bradleyeckert/thriller/README.md

# FPGA security stack with ROT

Root of trust for an FPGA-based device platform, built from three parts: an FPGA with an encrypted and authenticated bitstream,
one QSPI NOR flash, and a TPM 2.0 (ST33KTPM2X). The FPGA is a model of the ASIC that replaces it
at volume (`doc/ics55.md`), so everything the FPGA does is generic RTL and firmware, and everything that depends on the FPGA family lives in `fpga/<family>/`.

- **The FPGA is the root of trust and the application.** Its configuration engine authenticates and decrypts the bitstream with the device's own eFuse key;
  the bitstream holds a boot ROM, a loader core that owns every key path and security decision and is, with its hardware, the FIPS 140-3 cryptographic module; a supervisor core that
  runs the manufacturer's transports, scheduling and CLI outside the module, so that those change without a CMVP filing; and an application core that runs the LiteForth application and can reach
  nothing secret. All three execute in place from the flash through a decrypting, authenticating cache (`doc/xip.md`).
- **The TPM holds what must survive the bitstream:** the device's keys, its identity, and the two monotonic counters that stop rollback.
  It releases a key only to a bitstream that holds the current pairing key, and the data key only after the host has proved itself to the TPM directly (`doc/tpm.md`).
  It is a FIPS 140-3 validated module in its own right, which is what lets the device's own module boundary stop at the loader domain (`doc/fips.md`).
- **The flash is untrusted storage** for the bitstream, the loader, the supervisor and the application, every line of code authenticated as it is fetched (`doc/flash.md`).
- **The module is frozen.** Every change to the bitstream or the loader is a filing with the CMVP, so the loader is a crypto kernel with a fixed service API and all product logic lives in the supervisor and application images (`doc/fips.md`, Designing for few filings).

The platform will encrypt files, so the TPM is provisioned accordingly.
To support DSP applications, audio CODECs are planned for.

## Documents

| Document | Contents |
|---|---|
| This README | Overview: chipset, keys, boot, updates, recordings, sensor, host sessions, the network and the CLI |
| `doc/arch.md` | Trust boundary, threat model, risk assessment, algorithm bill of materials |
| `doc/hw.md` | Hardware modules: the three cores, the mailboxes, the shared XIP engine, key paths, boot and lockdown, the key-source interface |
| `doc/api.md` | The module's service API: mailbox messages, session messages the module consumes, events, status block, parameters carried as data |
| `doc/tpm.md` | TPM: NV indices, sealed objects and PCRs, sessions over SPI, host authentication, the pairing-key ratchet, counters, attestation, provisioning |
| `doc/flash.md` | Flash map: bitstream slots and multi-boot, loader, supervisor and application slots, boot record, install order, staging |
| `doc/fpga.md` | The FPGA, family-neutral: configuration from flash, per-device bitstreams, fallback, TRNG, resources |
| `fpga/` | Everything family-specific, one folder per FPGA family, and the wish list a family must meet |
| `doc/xip.md` | Execute in place: per-line Ascon-AEAD128 for the loader, the supervisor and the application |
| `doc/acquisition.md` | CODECs, data path, recording encryption, LCD, speaker and alarms |
| `doc/sensor.md` | Replaceable temperature sensor: certificates, offline pairing, authenticated sessions, fail-safe behavior |
| `doc/enrollment.md` | Device and sensor enrollment, TPM provisioning, the bitstream build service, detecting unknown identities, updates |
| `doc/roles.md` | Manufacturer, application owner, developer and user; device-bound developer builds |
| `doc/test.md` | Test plan and fault-injection campaigns |
| `doc/fda.md` | FDA security architecture views |
| `doc/network.md` | Network security posture: why the device cannot be a network attack vector, for IT departments and the FDA |
| `doc/fips.md` | FIPS 140-3 as the long-term target: designing for few filings, module boundary, approved algorithms, DRBG, self-tests, roles, zeroization, and what it changes now |
| `doc/ics55.md` | ASIC migration to the ICS55 55 nm process: the PUF behind the key-source interface |
| `doc/questions.md` | Every open question in one matrix, and the decisions taken |

## Chipset

- **FPGA with an encrypted and authenticated bitstream.** Current choice: **Pango Logos2 PG2L50H-6IFBG484** (50K-class), which authenticates bitstreams before decrypting them
  (`fpga/logos2/`). No family offers a hardened cipher usable from the fabric, so all symmetric cryptography runs in a masked Ascon core of our own (`doc/hw.md`). It configures itself from the flash at power-up in master SPI mode, with the vendor's multi-boot fallback to a second bitstream. Fallback: **Efinix Titanium Ti60** (`fpga/ti60/`), which meets the same hard requirements with RSA-4096 authentication
  and a scripted BRAM content updater. Candidates: Microchip PolarFire, Lattice CrossLink-NX. The ECP5 and Gowin GW5A were evaluated and dropped for lacking bitstream authentication. The requirements a family must meet are in `fpga/README.md`.
- **QSPI NOR flash**, 32 MB proposed: bitstream slots, loader, supervisor and application images (A/B each), the boot record and a recovery staging area (`doc/flash.md`). Nothing in it is trusted.
- **ST33KTPM2X32DKG9** TPM 2.0 (STMicroelectronics), on an SPI bus that never leaves the sealed enclosure, powered with the FPGA. Chosen over the ATECC608C when FIPS 140-3 became the target:
  it is on CMVP certificate #5570 (FIPS 140-3, physical security Level 3), ships with ST-certified endorsement keys, and sits inside the device's own module boundary as an embedded validated
  module, so its services need no testing of ours (`doc/fips.md`). Keys are sealed objects released only under a policy that names the pairing key; counters are its NV counters, authenticated and
  authorized; its indices cannot be deleted by anyone but the enrollment station (`doc/tpm.md`).
  Provisioned blank at enrollment. A high-volume part, in stock at Mouser in quantity; not at LCSC, so a consigned part for JLCPCB builds (E8).
- **2 × NAU88C22** stereo CODECs: four acquisition channels, and the speaker driver (`doc/acquisition.md`).
- **LCD panel and speaker** inside the enclosure, which carries a tamper-evident seal.
- **MicroSD card socket**, driven by the FPGA: encrypted recordings and user data, the event log, offline update packages.
- **ESP-PSRAM64H** (8 MB QSPI PSRAM): a ring buffer for the encrypted recording stream between the recording engine and the card or the network, riding out card write latency and network stalls.
  It holds ciphertext only, about ten seconds of it at the full rate, and is outside the trust boundary like the card (`doc/acquisition.md`, Stream buffer).
- **Sensor connector**: a wired, two-way link to a replaceable temperature sensor; the supervisor moves the bytes, the module checks every frame (`doc/sensor.md`).
- **UART** (USB-UART bridge): status reports, and the wired path for host sessions, updates and the CLI.
- **Ethernet**, 10/100 over RMII to a PHY such as the LAN8742A: the path to the server for attestation, updates, uploads and sensor-pairing confirmation. The FPGA speaks only UDP on one port,
  implemented in hardware; there is no network stack anywhere in the device (see Network). An untrusted edge proxy on site relays the datagrams to the server over TLS where IT requires port 443.
- **YXC YSN8130E real-time clock** (3225 module with built-in crystal, 0.9 µA, open-drain /INT that survives a VDD cycle), backed by two SR44 cells; A10 for the remaining checks. Its time is untrusted and never stands in for the server's time beacons (`doc/acquisition.md`); its job is
  scheduling and local display, and **its alarm output wakes the device from deep sleep** (the regulators' enables on the FPGA board, RST_N on the ASIC), so every scheduled wake is a cold start through the
  entire trust chain; the alarm is also an input pin, so the supervisor sees it as an interrupt when awake. It also automates NIST SP 800-90B restart testing of the TRNG: a thousand wakes, each logging its first raw samples (`doc/hw.md`, Real-time clock).
- Oscillator, voltage regulators, and test connectors not populated in production. The FPGA's JTAG is permanently disabled at enrollment where the family allows it.

## Keys and what unlocks them

| Key | Held in | Per device | Unlocked by | Protects |
|---|---|---|---|---|
| Bitstream configuration key | FPGA eFuse; HSM | Yes | The FPGA alone | The bitstream at rest in flash and on the configuration bus |
| Bitstream signing key | Manufacturer HSM; public key data in FPGA eFuse | No | — | Only manufacturer bitstreams configure the FPGA (where the family authenticates) |
| **Pairing key** | The bitstream (key source) and the TPM's pairing index, as its authorization value | Yes, and per bitstream release | The bitstream itself | Every TPM session: the session key, every HMAC, every policy. Rotated with each bitstream release, which is what kills old bitstreams (`doc/tpm.md`, Ratchet) |
| Application key | TPM, sealed | Yes | Pairing key | Headers and per-line keys of the loader, supervisor and application images in flash; the boot record |
| **Data key** | TPM, sealed, one per host | Yes | Pairing key **and** the host's proof to the TPM (a relayed HMAC session) | User data on the MicroSD card |
| Host authorization key | TPM (an NV index's authorization value, never readable) and the host | Yes, per host | Never leaves either | Proving the host is present; the host session secret sealed with the data key derives the session key |
| Device identity key (symmetric) | TPM (keyed-hash object, never readable); HSM | Yes | Pairing key; used in place | Authenticating the device to the enrollment server, quantum-safe |
| Attestation key (ECDSA P-256) | TPM (never readable); certificate chained to the manufacturer CA, bound to ST's endorsement key certificate | Yes | Pairing key | Quotes over the PCRs for hosts and third parties |
| Distribution key | TPM, sealed | No | Pairing key | Production application packages in transit; a device never enrolled cannot install them |
| Developer key | TPM, sealed | Yes | Pairing key, into hardware only | Developer builds for that one device (`doc/roles.md`) |
| Log key | TPM, sealed | Yes | Pairing key | The security event log's MAC chain |
| Release LMS keys (platform; application), main and backup | HSMs; platform public key in the boot ROM, application keys in write-locked TPM NV | No | — | Every update package, checked before anything is decrypted or installed |
| Host data secret | Host only; from a separate HSM master | Yes | — | Unlocks user data together with the device's data key |
| Host recording key pair (ML-KEM-768) | Private key on the host; public key in flash, under the application key | Per host | — | Recordings: the device can encrypt them but not decrypt them |
| Segment key | Loader domain and the recording engine, for one segment, then erased | Per segment | — | One segment of a recording |
| Sensor pairing key | Flash (under the application key) and the sensor | Per pairing | — | Sessions with one paired sensor |

The HSM derives every per-device key from a master key and the TPM's identifier (`doc/enrollment.md`). No stored key ever reaches software on any core: keys move from the
TPM or the key source into hardware key registers (`doc/hw.md`, Key paths). The one computed secret that does pass through loader software is the ML-KEM shared secret, which the
encapsulation code produces and hands to the derive path (H10).

## Boot

1. The FPGA's configuration engine loads the active bitstream from flash, checks its signature and decrypts it with the device's eFuse key; anything else is refused. On failure it falls back to the other
   bitstream slot (the family's multi-boot).
2. The **boot ROM** (block RAM in the bitstream) starts on the loader core with the other two cores in reset. It starts the TPM, opens a session under the pairing key, reads counter 0,
   has the TPM unseal the application key, checks the loader image's header and version, derives the loader's image key into the XIP engine, and jumps to the loader in flash.
   If the TPM refuses the pairing key, this bitstream has been superseded: the boot ROM stops in recovery.
3. The **loader** reads counters 1 and 2, checks the supervisor image's header and version, then the application's (or, for a developer build, device and epoch), derives their image keys,
   applies the network policy to the PHY's reset, and releases the supervisor core, then the application core. Every cache line of every image is authenticated as it is fetched.
4. The **supervisor** brings up the card, the clock, the schedule and, if the policy allows, the network address, and has the module open the sensor session.
5. The application runs. It reaches user data, recordings, the host, the sensor and the log only through the module's services; the supervisor moves the bytes.

Any check that fails falls back to the other slot of that image, or stops in the safe state with a record in the boot record (`doc/hw.md`, Boot and lockdown).

## Updates

Two signed chains, sharing nothing but the TPM:

| Package | Contents | Scope | Signed by | Counter |
|---|---|---|---|---|
| Platform | This device's encrypted bitstream with its next pairing key, and a loader image | Per device, built by the bitstream build service | LMS (manufacturer), one signature per release over a manifest | 0 |
| Supervisor | The manufacturer's supervisor image: transports, scheduling, CLI | Fleet | LMS (manufacturer) | 2 |
| Application | The LiteForth application, and its network policy | Fleet; encrypted under the distribution key | LMS (application owner); developer builds: a MAC under the device's developer key | 1 |

Packages arrive on the MicroSD card, over the UART from the host, or over the network, and the supervisor streams them to the module. The module checks the signature and the version before decrypting anything, writes into the
inactive slot, reads it back, advances the counter and switches the boot record (`doc/flash.md`, Install order). A bitstream update ends with the new bitstream, once it has booted,
replacing the pairing key in the TPM with its next key, after which the old bitstream can no longer open the TPM. Platform packages are the rare ones: each is a change to the FIPS module and a CMVP filing; supervisor and application packages are not (`doc/fips.md`).

## Recordings

The loader draws a fresh key for each segment, encapsulates it with ML-KEM to the host's public key, and loads it into the recording engine, which encrypts the stream in the FPGA's
masked Ascon core and writes ciphertext to the card. The segment key is then erased, so the device cannot read its own past recordings, and neither can a thief (`doc/acquisition.md`).

## Sensor

The temperature sensor is replaceable and pairs offline with an ML-DSA certificate and ML-KEM. Every frame carries a MAC, readings older than the maximum age are rejected,
and the server later confirms each pairing and catches clones (`doc/sensor.md`).

## Host sessions and user data

The host proves itself to the TPM, not to the loader: the loader relays one TPM command's HMAC, which the host computes under its own key, and the TPM unseals the data key only when it
verifies; the host session secret unsealed alongside derives the session key, so that every frame is encrypted and authenticated. User data other than recordings is encrypted under a key derived from both the device's data key and a secret the host sends in each
session, which the device never stores. A lost host is re-issued from the HSM. A compromised host means retiring the device (`doc/arch.md`, R20).

## Attestation and identity

The device proves what it is and what it runs in two ways (`doc/tpm.md`, Attestation):

- to the enrollment server, with a MAC under its symmetric identity key over the server's nonce and a report of its versions and counters: quantum-safe, and the HSM can derive the key;
- to a host or a third party, with a TPM quote: an ECDSA P-256 signature over PCRs the loader extended with the same report, under a per-device attestation key certificate chained to the manufacturer's CA and to ST's endorsement key certificate.

The TPM signs only for a bitstream that holds the current pairing key, so a report proves the pairing, the bitstream release, and the versions the loader measured.

## Network and the CLI

There are no radios. The device has one wired Ethernet port, and the FPGA implements the whole of its network side in hardware (`doc/hw.md`, Ethernet transport): an RMII MAC, an ARP
responder for its own address, IPv4 without fragments or options, ICMP echo, and a UDP demultiplexer that delivers datagrams on one port to the supervisor core and drops everything else.
The payload is the same authenticated, encrypted session frame the module already checks from the UART, so the network is a second transport for one protocol, with no TCP, DNS, TLS or HTTP
anywhere in the device. Flows are outbound only, with keepalives; the ack-and-window layer that makes updates and uploads reliable over a lossy path is part of the session protocol.

Where a site's IT policy only allows TCP on port 443, a small **edge proxy** (software on a PC or a gateway appliance on the same LAN) relays the device's datagrams to the server over TLS.
It is outside the trust boundary and sees only ciphertext: it can drop, delay or replay, and every one of those is already handled by the session protocol.

**The application owner decides** whether the port is enabled, through a network policy in the signed application package; the module holds the PHY in reset when it is disabled, and the supervisor cannot override it.
Addressing is by DHCP, with static addresses settable in a host session; the server (or proxy) address is set the same way.

- **The UART** gives read-only status to anyone with a cable, and authenticated sessions.
- **The network** carries authenticated sessions with the server, and with a host on the same LAN.

| Session | Commands |
|---|---|
| None (UART status only) | Versions, build mode, faults, pairing state |
| Host (host authorization key) | User data, recordings, sensor pairing, updates, log export, network settings, attestation |
| Developer (developer key, developer builds only) | The above, plus the application's debug commands |

The PHY choice, PoE and the edge proxy are open items (`doc/questions.md`, A6 to A9).

## ASIC conversion

The ASIC keeps the boot ROM (now mask ROM), the loader, the supervisor and application chains, the TPM and the flash, and loses the bitstream. The one thing the bitstream carried,
the pairing key, comes instead from a PUF behind the same key-source interface the FPGA build already uses, with the hardware to characterize it on silicon (`doc/ics55.md`).
