bradleyeckert/thriller/fpga/logos2/README.md

# Pango Logos2 (PG2L50H)

**Part under consideration:** PG2L50H-6IFBG484 (50K-class logic, speed grade 6, industrial temperature, 484-ball BGA).
**Status:** current choice, with the Efinix Ti60 as fallback (`fpga/ti60/`). Its bitstream security meets the hard requirements of the wish list. Its "DPA protection" turned out to mean authentication before decryption of the bitstream, not a hardened cipher the fabric can use,
so the design's symmetric cryptography runs in a masked Ascon core of our own (`doc/hw.md`), as it would on any family. The deciding unknowns are the build flow (item 5, F1) and the master SPI multi-boot behavior (item 4, F3).

## What the datasheet claims

From the *Logos2 Family FPGAs Device Datasheet*:

- AES-256-GCM bitstream encryption with "self-authentication", plus RSA-2048 bitstream signatures over a SHA-3 digest.
- Key storage in eFuse or battery-backed RAM (BB-RAM).
- Protection against bitstream readback.
- JTAG security management, including permanently disabling JTAG.
- Protection against differential power analysis (DPA) of the key. **In practice this is authentication before decryption:** the RSA signature over the ciphertext is checked first, so an attacker cannot feed chosen ciphertexts to the decryptor. It is not a hardened AES engine, and no AES engine is exposed to the fabric.

## The wish list

| # | Requirement (`fpga/README.md`) | Logos2 |
|---|---|---|
| 1 | Encryption and authentication, per-device key | AES-256-GCM with the key in eFuse, programmed per device at enrollment, and RSA-2048 signatures. **Yes, twice.** Closes R32 |
| 2 | No fallback | The configuration guide's procedure says only the corresponding encrypted bitstream can be configured once a key is programmed; an adjacent sentence is ambiguous about eFuse keys. Verify on a fused sample (see F2 below) |
| 3 | Readback disabled, key not readable | Encrypted bitstreams cannot be read back or verified (guide 4.3.9.1); eFuse key; JTAGLOCK and SCANLOCK fuse bits |
| 4 | Master SPI self-configuration with multi-boot | Yes: multi-boot stream with golden and application images, built by `cfg_gen_multi_file`; a status-register fallback flag. Golden-image rule and mode pins to confirm (F3) |
| 5 | Per-device constants from a script | **Not in the Tcl guide** (see Per-device keys below). Per-device re-encryption is cheap; whether a DRM INIT change forces re-synthesis is the open item (F1) |
| 6 | Room for a masked Ascon core | Yes; a 50K-class part. No vendor cipher block is usable from the fabric, so the core is ours (F4) |
| 7 | Ring-oscillator TRNG | To confirm |
| 8 | Enough logic | A 50K-class part: ample room for the three cores, the security blocks and the application. LUT size and block RAM to confirm |
| 9 | QSPI and peripheral pins | General I/O; 484 balls |
| 10 | Module placement held stable | **Partly:** hierarchy isolation, a locked region and fixed pins in the physical constraints editor; no partition flow, so netlist locking and the build-to-build comparison are scripts to write (Keeping the module's partition stable, below) |

## Against the Ti60 fallback

| | Logos2 PG2L50H | Efinix Ti60 |
|---|---|---|
| Bitstream authentication | RSA-2048 over SHA-3, plus AES-256-GCM | RSA-4096, plus AES-256-GCM |
| Power analysis on configuration (R5) | Signature checked before decryption | To confirm |
| Per-device constants (item 5, F1) | Open: DRM INIT re-synthesis test | Yes: BRAM Initial Content Updater |
| Permanent JTAG disable (R43) | JTAGLOCK, SCANLOCK fuses | JTAG disable option |
| Fit | 50K class | 60K class |
| Toolchain | PDS, free node-locked licence, Tcl and `cdt_cfg` headless | Efinity; headless operation to confirm |
| Origin | Pango (China) | Efinix (US) |

The fabric-side cryptography (R33) is the same masked Ascon and SHA-256 cores on both.

## No hard AES for the fabric

An earlier version of this design assumed the Logos2's DPA protection was a hardened AES engine the fabric could use, and built the XIP engine, the recording engine and the install port on it.
It is not: Pango's countermeasure is to authenticate the bitstream (RSA-2048 over the ciphertext) before decrypting it, which denies an attacker chosen ciphertexts, and nothing in the datasheet exposes an
AES engine to user logic. The design therefore runs all symmetric cryptography in a first-order masked Ascon-AEAD128 core of its own (`doc/hw.md`, The Ascon core), as it would on every other candidate family,
and F5 (wrapping the pairing keys under the eFuse key) is closed for this part.

## Key storage: eFuse or BB-RAM

- **eFuse (base choice):** permanent, needs no battery, matches every other family here.
- **BB-RAM:** the key lives in battery-backed RAM and can be erased instantly, which would allow a tamper response from the enclosure switch (Q7). The cost is a coin cell, and a device whose
  battery dies also stops working, which is probably unacceptable for a medical device.

## Enrollment

Replaces step 3 of `doc/enrollment.md`. Everything below is scriptable through the Fabric Configuration tool (`cdt_cfg`), from its *Fabric Configuration User Guide*; see Headless station flow.

1. Run the board's boundary-scan test.
2. Program the device's `.nky` key file into eFuse: the AES-256 key (from the HSM) and the RSA-2048 public key digest (`cfg_program_key_file -key_location 1`).
3. Confirm that decryption and authentication are mandatory (F2, see the caveat below), then lock the key, the digest, and the authentication, decryption and DPA enables (`cfg_efuse_lock`); DPALOCK and DRMDPALOCK are kept set, whatever they protect, since there is no reason to leave them open.
4. After the first boot and the attestation check, lock JTAG and scan mode (`cfg_efuse_lock -lock C`, `-lock D`), or lock everything with `-lock FF`.

### Headless station flow

The Fabric Configuration tool runs without its GUI: `cdt_cfg.exe -ip <jtag server> -port 65420 -file station.tcl -args {dev.sbit dev.nky dev_mul.sfc}`, where `%s` placeholders in the
script are filled in order from `-args`; `cdt_cfg_shell.exe` is the terminal version. It talks to the Jtag Server, a TCP service on the station PC (or a remote host) that drives the cable.
A per-device script, from the commands the guide documents (section 4.5):

```tcl
cfg_connect -ip 127.0.0.1 -port 65420
cfg_add_device -file %s                              ;# this device's encrypted .sbit
cfg_read_device_property -mode 1                     ;# device UID, for the enrollment record
cfg_program_key_file -key_location 1 -file %s        ;# .nky into eFuse: 0 = temporary register, 1 = eFuse, 2 = BBRAM
cfg_efuse_lock -lock <index> -password 000000 -status 1   ;# per lock bit, or FF for all; the password is a fixed interlock, not a secret
cfg_read_device_property -mode 4                     ;# eFuse value, for the record
cfg_read_device_property -mode 3                     ;# status register: bit 23 key_lock, bit 22 fallback
cfg_flash_scan_device                                ;# SPI flash through the cable; cfg_jtag_flash_* goes through the FPGA instead
cfg_flash_assign_file -file %s                       ;# the multi-boot .sfc
cfg_flash_program
cfg_flash_verify_checksum
cfg_disconnect
```

Conversions are Tcl too: `cfg_gen_sfc -sbit x.sbit -opcode 107 -device_name <flash>` makes a flash image (opcodes 0x0B/0x3B/0x6B for 24-bit, 0x0C/0x3C/0x6C for 32-bit, single/dual/quad read),
and `cfg_gen_multi_file -type 0 -infile {golden.sfc app.sfc} -outfile dev_mul.sfc -sbit_start_address …` builds the multi-boot stream. The GUI's Tcl record function (Operations → TCL Record File)
writes the commands for any manual sequence, and `cfg_xxx -help` prints each command's options.

`-key_location 0` loads the key into a volatile register, so encrypted bitstreams can be tested on unlocked boards without fusing anything; BBRAM (location 2) can change the AES key later but not the RSA digest.

### eFuse lock bits (Logos2 and Titan2, Table 5-21)

| Index | Name | Locks |
|---|---|---|
| 0 | KEYLOCK | Program key |
| 1 | UIDPLOCK | Program UID |
| 2 | FUSEPLOCK | Program user fuse |
| 3 | EDLOCK | Public key abstract (the RSA digest) |
| 4 | FUSELOCK | User fuse |
| 5 | OBFUSLOCK | Obscure enable |
| 6 | AUTLOCK | Authentication enable |
| 7 | DPALOCK | DPA enable |
| 8 | DRMDPALOCK | DRM DPA enable |
| 9 | DECLOCK | Deciphering enable |
| A | BBKEYLOCK | Power-source (BBRAM) key |
| B | KEYENLOCK | eFuse key enable |
| C | JTAGLOCK | JTAG |
| D | SCANLOCK | Scan mode |
| E | EFUSELOCK | eFuse enable |
| F | IDLOCK | IDCODE program |
| 10 | PRCFGLOCK | Partial reconfiguration |
| 11 | TRIMLOCK | Trim |
| 12 | ID2LOCK | IDCODE2 program |
| FF | all | Every bit above |

JTAGLOCK and SCANLOCK are the permanent JTAG disable the design relies on (R43): documented, one command. The 32 user eFuse bits (`cfg_program_user_efuse -value <32 binary digits>`) are
available for a lifecycle mark if wanted.

### F2: does the eFuse key force encryption?

Section 4.3.9.1 contains two statements in tension. The procedure's closing note says: "After configuring the key file, only the corresponding encrypted bitstream can be configured," with no distinction
between key locations, which is the behavior the design needs. The introductory paragraph, contrasting the temporary key with the eFuse key, says that after a temporary key is loaded "unencrypted bitstreams
will fail. This restriction does not apply to eFuse key .nky files," where "restriction" most plausibly refers to the temporary key's own property (bitstreams must match that key until power-off, when it is lost),
and reads as a translation placing the sentence one step too far. The lock table's KEYENLOCK ("eFuse key enable") and DECLOCK ("deciphering enable") show that separate enable bits exist, as on other vendors'
parts, and are presumably set by the `.nky` as a matter of course.

Treated as an ambiguity, not a hole, and closed by one bench test during station bring-up: fuse a sample with its `.nky`, attempt a plaintext `.sbit` and an `.sbit` encrypted under another key, confirm both are
refused, and read `cfg_read_device_property -mode 4` to record which enable bits the `.nky` set. Ask Pango in parallel how the `.nky` carries the enables.

## Flash and multi-boot

From the configuration guide (section 4.3.20.3), answering the layout half of F3:

- The multi-boot data stream (Logos, Logos2, Titan2) is built by `cfg_gen_multi_file -type 0` from a golden stream and one or more application streams, each with a settable start address.
- Each application stream has an 8 KB header; each stream gets 108 bytes of desynchronization data appended; every start address must be on a flash sector boundary; a watchdog field follows each stream
  and triggers the fallback to the golden stream when the application stream fails to configure. The status register's bit 22 (`fallback`) reports that the golden stream was used.
- Other types: 1 SPI remote-update stream, 4 remote-upgrade stream, 5 and 7 dual-boot streams (Compact only).

Still open in F3: whether the golden stream must be the fixed image at the base address (then bitstream A in `doc/flash.md` is the enrollment-time image, retired by the ratchet after the first platform update,
and updates alternate between B and a third region) or whether the fabric or the loader can redirect the boot address; and the master SPI mode pins. The bitstream slots in `doc/flash.md` are sized at 4 MB pending F9.

## Toolchain

Pango Design Suite (PDS), proprietary, runs from the command line. There is no open-source place-and-route for Logos2, so the development flow is PDS too.
Scripted block RAM updates with encryption and signing (F1) are open; see Per-device keys below.
License is free, but getting set up is not obvious. The steps are:

1. Create an account at https://www.pangomicro.com/en/
1. Once approved, log in using your email address and password (the password field is labeled PIN)
1. Apply for a node-locked license for PDS.
1. Download PDS. It is 2.0 GB, so it will take a while.
1. You will get an email about your MAC being approved. That means your license file is ready. 
1. Download the PDS license file from https://www.pangomicro.com/en/member/license/
1. Create a new environmental variable PANGO_LICENSE_FILE that points to it.
1. Launch PDS.

## Per-device keys: what the Tcl guide says

Read against the *Tcl Command User Guide* v2.0 (October 2023, 119 pages), the only version in hand:

**Present.** `pds_shell -file script.tcl` and `pds_shell -project design.pds -run gen_bit_stream` run headless. `gen_bit_stream` accepts `-input_db_file`, so a bitstream can be generated from a saved
place-and-route database without re-running PnR. **Changing the AES or RSA key settings in the project does not invalidate place-and-route; only Generate Bitstream reruns, in about a minute on a
moderate design** (observed in PDS). With blank key names the project draws fresh random keys at each run. So a per-device *encryption* step is cheap, and that step is needed in both plans, since the eFuse
key is per device whether the pairing keys ride in the bitstream or in flash.

**Absent.**
1. Any command that sets bitstream options. `gen_bit_stream` takes only `-of_flow`, `-force_to_run` and `-input_db_file`; there is no `set_property` or equivalent for encryption, key files, signing or
   security bits among the guide's commands. Those are project settings made in the GUI and stored in the `.pds` file; `import_project_settings -gen_bit_stream` copies them between projects, and
   `export_project_tcl` and `open_config` (the Configuration component) are marked "only supported in the GUI interface."
2. Any command that changes memory initialization in a routed design. The Design Editor commands (`move_cell`, `manual_route`, `new_net`, `copy_inst`, `save_adif`) edit placement and routing;
   `define_attribute` handles only `PAP_REGION` and `PAP_LOC`. There is no equivalent of Xilinx `updatemem`, Efinix's BRAM Initial Content Updater, or Diamond's ECO INIT edit.

**Consequences, in order of preference:**
1. **Test whether a DRM INIT change forces re-synthesis.** If PDS treats the key-source block RAM's initial contents as bitstream data (as Xilinx does), per-device bitstreams cost one `gen_bit_stream` each
   and F1 is settled. If it forces a new synthesis and PnR, the pairing keys need another per-device carrier (below) or per-device PnR.
2. **Per-device encryption from the project.** Per device, the station either edits the key file path in the `.pds` (its format to confirm) or leaves the key names blank and harvests the `.nky` PDS generates.
   To settle: the `.nky` format, so HSM-derived AES keys can be written into one (letting PDS's RNG pick them and escrowing the `.nky` is acceptable, since the station is already the trusted build service, R42);
   and the RSA signing key, which must be a fixed named file and never regenerated, and which therefore lives on the isolated station rather than in an HSM. Remaining question for Pango: whether a DRM INIT
   change forces re-synthesis (irrelevant under wrapped keys).
3. **Patch the bitstream.** Generate an unencrypted bitstream from the DB, locate the key DRM frames by diffing two builds with different placeholder constants, patch per device, then encrypt and sign.
   Workable only if step 2 yields a standalone encrypt-and-sign step; reimplementing Pango's AES-256-GCM-plus-RSA bitstream format is not realistic.
4. **Per-device synthesis and PnR** with the keys as Verilog parameters: minutes per device and different routing per unit. Not acceptable at fleet scale.

## Other considerations

- Documentation is mostly in Chinese; some details may only be available through Pango's support.
- Supply chain, availability and **country of origin** for the target markets should be checked alongside the technical evaluation (F11). PolarFire is the candidate to compare against if origin matters.
- It fits the ICS55 direction (`doc/ics55.md`): a domestic Chinese FPGA now, a domestic 55 nm ASIC later.

## Keeping the module's partition stable (F12)

The loader domain is the FIPS 140-3 module, and a bitstream release that changes only supervisor or application logic should be shown not to have touched it (`doc/fips.md`, Designing for
few filings). What PDS offers, and what it does not:

- **Hierarchy is preserved.** PDS parses the standard HDL hierarchy, so the whole loader domain is written as one hierarchy node (`thriller_module` in the RTL) and can be isolated as a unit.
- **Placement is held by constraints, not by a partition flow.** To keep the module's layout stable across iterations, its logic is assigned to a locked rectangular region in the physical
  constraints editor (the equivalent of a Pblock), and its pins (TPM SPI and reset, host UART, the QSPI, the overlay lines, the PHY reset, WAKE) are fixed by pin assignments. This keeps the
  module's cells inside its region and the rest of the design outside; it does not by itself make the module's placement and routing identical from build to build.
- **Bit-identical sub-region output needs scripting.** Guaranteeing that the module's region is strictly identical across unrelated top-level changes requires locking the module's placed
  and routed netlist and preserving its pin assignments by script between builds, and checking the result. Routing that crosses the region (the mailboxes' signals, clocks, resets) will still
  differ at the boundary, so the claim to make is "the module's cells and their internal routing are unchanged", with the mailbox interfaces as the declared boundary.
- **Bitstream bytes are not the evidence.** Every device's bitstream is encrypted under its own key, so no two are byte-comparable anyway, and even one device's successive bitstreams differ
  outside the region. The evidence is a digest of the module's post-place-and-route netlist (cells, their locations, their internal nets) extracted by script from each build and compared with
  the validated one; the laboratory decides whether that digest, plus the locked region and pins, is enough to call a release non-security-relevant (E12).

What this costs: the module's region is sized once with margin, and the design outside it works around a fixed rectangle. What remains: write the lock-and-compare scripts in PDS Tcl and prove
on two consecutive builds, one with a supervisor-only RTL change, that the digest holds (F12).

## Answers so far, and what remains

| Question | Answer |
|---|---|
| Encrypted-only and signed-only configuration | The guide says only the corresponding encrypted bitstream can be configured after keying, with one ambiguous sentence about eFuse keys; enable bits exist (locked by DECLOCK, AUTLOCK, KEYENLOCK). Bench test on a fused sample (F2) |
| Master SPI self-configuration and multi-boot | Multi-boot stream format and generation known (above); golden-image rule and mode pins open (F3) |
| JTAG access to the eFuse key before JTAG is disabled | Key read-out not offered by the tool (only `cfg_read_device_property -mode 4`, the eFuse value, to confirm what it shows); JTAGLOCK and SCANLOCK fuse bits disable JTAG permanently |
| DPA protection | Authentication before decryption of the bitstream only; no hardened engine for the fabric |
| PDS from the command line | Yes |
| Block RAM contents in a routed design, from a script, then encrypt and sign | **Not in the Tcl guide v2.0;** three questions for Pango support (F1, now the fallback) |
| A cipher block usable from the fabric | **None.** Symmetric cryptography is our masked Ascon core (F4) |
| Wrapping the pairing keys under the eFuse key | **Closed (F5):** no engine to do it with |
