bradleyeckert/thriller/doc/acquisition.md

# Acquisition and Recordings

One foreseen application streams digitized audio or video to the MicroSD card, whose files are sent to a server.
Assuming the data is biometric, recordings are the primary asset (`doc/arch.md`).

## Hardware

| Part | Role |
|---|---|
| 24-bit stereo CODEC(s) | One CODEC's DAC and speaker driver also drives the alarm speaker |
| FPGA, application core domain | Masters both I2S buses and generates the CODECs' master clock; controls the CODECs over their own I2C bus; drives the LCD |
| FPGA, loader core domain | The recording engine, segment keys |
| FPGA, supervisor core domain | The stream buffer's drain, the card, the network: ciphertext only |
| LCD panel | Inside the enclosure, behind a window |
| Speaker | Inside the enclosure, for audible alarms |
| Enclosure | Tamper-evident seal |

## Data path

| Hop | Contents | Protection |
|---|---|---|
| CODEC → FPGA (I2S) | Samples | None possible; tamper-evident seal |
| Application core domain | Samples, for display and processing | Inside the FPGA |
| Application → recording engine (sample FIFO) | Samples the application wants recorded | A one-way FIFO into the loader domain; the engine accepts samples only while a segment key is loaded |
| FPGA → LCD | Displayed waveforms | Tamper-evident seal |
| Recording engine → stream buffer (PSRAM) → card or network | Recording ciphertext | Encrypted to the host; the PSRAM holds nothing else |

Plaintext exists only in the sealed enclosure: on the I2S buses, the LCD bus, and inside the FPGA (R38). Someone who breaks the seal could also replay or substitute samples on an I2S bus;
nothing in the design detects that (R40). An enclosure-crossing data link, when present, carries only ciphertext (R39).

## Recording encryption

Recordings are encrypted so that **the device can write them but not read them back.**

1. **Recipient keys.** The host (and optionally a clinic server) gives the device its ML-KEM-768 public key during an authenticated host session. The loader stores it in the records region of the flash, under the application key.
2. **Segments.** A recording is cut into segments, for example a few minutes each. For each segment the loader draws a fresh 128-bit segment key (Ascon-AEAD128's key size) from the DRBG into the recording engine's key register.
   For each recipient it runs ML-KEM encapsulation to the recipient's public key and wraps the segment key with Ascon-AEAD128 under a key derived from the shared secret (the one place the loader's code
   handles key material, masked; `doc/hw.md`). It then writes the segment header: device serial, recording ID, segment number, start sample index, build mode, the latest time beacon with the
   sample count since it (below), and the encapsulations with their wrapped keys.
3. **Stream.** The application feeds samples into the sample FIFO; the recording engine encrypts them in Ascon-AEAD128 blocks (for example 4 KB) in the Ascon core, with the block number in the nonce
   and the segment header as associated data in the first block, and the supervisor writes the ciphertext to the card or sends it over the network.
4. **Erase.** At the end of the segment the engine's key register is cleared. Nothing on the device can decrypt that segment again.
5. **Order.** Block and segment numbers make dropped, reordered or substituted blocks and segments detectable at the host.
6. **Provenance (optional).** The loader signs each segment's header and final block tag with a per-device ML-DSA key kept in the records region, registered at enrollment (open question Q5).

A thief who breaks the device gets the segment in progress at most, never earlier recordings. The host, holding the private key, decrypts and checks everything.

## Stream buffer

The card and the network both stall: an SD card can pause for hundreds of milliseconds on a wear-leveling or garbage-collection cycle, and a network path can lose connectivity for longer.
The recording engine cannot stall, because samples arrive at a fixed rate. Between them sits a **stream buffer**: an 8 MB QSPI PSRAM (ESP-PSRAM64H) used as a ring of encrypted blocks.

- **Ciphertext only.** The recording engine writes finished, authenticated Ascon-AEAD128 blocks into the ring; the supervisor's stream-buffer controller drains them to the SD controller, the Ethernet
  transport, or both, with the supervisor choosing destinations and watching the fill level. No plaintext and no key ever reaches the PSRAM, so it is outside the trust boundary like the card:
  a board prober who reads it sees ciphertext, and one who corrupts it corrupts a block the host will reject (R41).
- **Capacity.** 8 MB is about ten seconds of stream at the highest foreseen rate and twenty at the lowest, far beyond card latency, and enough to cover a network hiccup. A longer outage simply
  falls back to the card, which is always a destination unless the application owner has turned it off.
- **Loss on power cut.** PSRAM is volatile; whatever is in the ring when power fails is lost, at most the last ten seconds of the segment in progress. The host sees the missing blocks (block numbers
  are consecutive) and the segment's final tag is absent, so the loss is visible, never silent.
- **Overflow.** If both destinations stall for longer than the ring holds, the controller stops accepting blocks and the supervisor raises an alarm and logs the event; the recording engine's FIFO
  then backs up to the application, which decides whether to drop samples or stop. Nothing is overwritten silently.
- **Its own bus.** The PSRAM has its own QSPI pins and controller, separate from the flash's QSPI, so buffering never contends with instruction fetch. The controller respects the device's
  maximum chip-select time and page boundaries, which is what makes a PSRAM need a controller rather than a plain SPI master.

The same ring can hold a staged update package on its way from the network to the card, so a download does not stall on card writes either.

## When a recording was made

The device has no trusted clock. The TPM's clock runs only while it is powered, the FPGA has none, and a battery-backed clock on the board is something a board prober can set, so a device
timestamp proves only what the device believed. Instead, **time comes from the server, and the recording proves its position relative to it.**

- **Time beacons.** Whenever the device is in contact with the server, the server sends a beacon: its time, a nonce, and a MAC under the device's symmetric identity key, which the loader
  verifies through the TPM (`TPM2_HMAC` under the symmetric identity key, compared in the security block, as for any server message). The loader keeps the latest verified beacon in the records region, together with the device's sample count at the moment it arrived.
  Online, beacons arrive every few seconds; the loader also requests one at the start of every recording.
- **In the header.** Every segment header carries the latest beacon and the number of samples the device has acquired since it, so the header says: *this segment started no earlier than
  the server time in the beacon, plus this many samples at the nominal rate.* The header is authenticated as associated data of the segment, so the claim cannot be altered without the segment failing.
- **Bracketing.** The first segment written after a reconnection carries the first new beacon as well. A recording made offline is then bounded on both sides by server-attested instants:
  not before beacon A, not after beacon B, with the device's own sample count filling in the elapsed time. Online, A and B are seconds apart; after an offline week they are a week apart,
  and the host shows that interval rather than a false timestamp.
- **What it defeats.** Backdating or postdating a recording by setting a clock; presenting an old recording as new (its beacon is old and the server knows when it issued it);
  claiming a recording was made during a period when the device was provably offline or elsewhere (R47).
- **The real-time clock is not a substitute.** The board's RTC (`doc/hw.md`, Real-time clock) is settable by anyone with board access, so its reading is recorded in headers only as an untrusted
  estimate: useful for interpolating between beacons across power cycles, when the sample count cannot run, and shown by the host as such, inside the trusted bracket.
- **What it does not do.** It does not make the device's oscillator trustworthy: a prober who slows the clock stretches the sample count, which the next beacon exposes as a rate mismatch the host
  can flag. It does not give a time to a device that has never contacted the server; such recordings carry no beacon and the host marks them as undated.

The cost is one record in flash, one field in the segment header, and nothing in hardware. The same beacons also give the event log server-anchored times.

## Alarms

The speaker is driven through a CODEC by the application. The loader raises alarms through the mailbox (sensor faults, security events) and also drives the LCD overlay band directly,
so an alarm and the developer-mode mark are visible whatever the application draws (F8). Safety alarms do not need a path independent of the application beyond that.

## Open questions

See `doc/questions.md` (Acquisition rows).
