bradleyeckert/thriller/fpga/logos2/KiCAD/thriller/thriller_bom.csv

Qty | Value | Footprint | LCSC | MPN | DNP | References
2 | SR44 |  |  |  |  | BT1 BT2
9 | 47u | Capacitor_SMD:C_1206_3216Metric | C96123 |  |  | C1 C52 C63 C68 C80 C89 C98 C107 C116
6 | 22u | Capacitor_SMD:C_0805_2012Metric | C45783 |  |  | C10 C11 C15 C16 C20 C21
1 | 470p | Capacitor_SMD:C_0402_1005Metric |  |  |  | C130
2 | 22p | Capacitor_SMD:C_0402_1005Metric | C1555 |  |  | C131 C132
1 | 4n7/2kV | Capacitor_SMD:C_1206_3216Metric |  |  |  | C139
1 | 1u/50V | Capacitor_SMD:C_0805_2012Metric | C28323 |  |  | C177
58 | 100n | Capacitor_SMD:C_0402_1005Metric | C1525 |  |  | C2 C5 C6 C9 C12 C14 C17 C19 C22 C24 C42 C43 C44 C45 C46 C50 C51 C61 C62 C67 C70 C71 C74 C76 C77 C79 C87 C88 C96 C97 C105 C106 C114 C115 C123 C124 C125 C128 C134 C135 C136 C138 C140 C141 C142 C152 C154 C155 C159 C167 C169 C170 C174 C176 C178 C179 C180 C181
4 | 100u | Capacitor_SMD:C_1206_3216Metric | C15008 |  |  | C25 C26 C27 C47
29 | 4u7 | Capacitor_SMD:C_0603_1608Metric | C19666 |  |  | C28 C29 C30 C31 C32 C33 C53 C54 C55 C64 C72 C81 C82 C90 C91 C99 C100 C108 C109 C117 C118 C151 C153 C156 C157 C166 C168 C171 C172
22 | 1u | Capacitor_SMD:C_0402_1005Metric | C52923 |  |  | C3 C4 C75 C78 C126 C129 C133 C137 C143 C144 C145 C146 C147 C148 C149 C150 C160 C161 C162 C163 C164 C165
38 | 470n | Capacitor_SMD:C_0402_1005Metric |  |  |  | C34 C35 C36 C37 C38 C39 C40 C41 C48 C49 C56 C57 C58 C59 C60 C65 C66 C69 C83 C84 C85 C86 C92 C93 C94 C95 C101 C102 C103 C104 C110 C111 C112 C113 C119 C120 C121 C122
1 | 2u2 | Capacitor_SMD:C_0402_1005Metric | C12530 |  |  | C7
1 | 10n | Capacitor_SMD:C_0402_1005Metric | C15195 |  |  | C73
8 | 10u | Capacitor_SMD:C_0603_1608Metric | C19702 |  |  | C8 C13 C18 C23 C127 C158 C173 C175
1 | SMAJ5.0A | Diode_SMD:D_SMA |  | SMAJ5.0A |  | D1
1 | BAT54A | Package_TO_SOT_SMD:SOT-23 |  | BAT54A |  | D2
1 | BAT54C | Package_TO_SOT_SMD:SOT-23 |  | BAT54C |  | D3
4 | green | LED_SMD:LED_0603_1608Metric | C72043 |  |  | D4 D6 D7 D10
1 | B5819W | Diode_SMD:D_SOD-123 | C8598 |  |  | D5
1 | blue | LED_SMD:LED_0603_1608Metric | C72041 |  |  | D8
1 | red | LED_SMD:LED_0603_1608Metric | C2286 |  |  | D9
1 | 2A PTC | Fuse:Fuse_1812_4532Metric |  |  |  | F1
1 | 0.2A PTC | Fuse:Fuse_0805_2012Metric |  |  |  | F2
9 | 600R@100MHz | Inductor_SMD:L_0603_1608Metric | C1002 | GZ1608D601TF |  | FB1 FB2 FB3 FB4 FB5 FB6 FB7 FB8 FB9
1 | 5V IN | TerminalBlock_Phoenix:TerminalBlock_Phoenix_MKDS-1,5-2-5.08_1x02_P5.08mm_Horizontal |  |  |  | J1
1 | SPEAKER | Connector_JST:JST_PH_B2B-PH-K_1x02_P2.00mm_Vertical | C131337 | B2B-PH-K-S |  | J11
1 | FPC 40P 0.5mm | Connector_FFC-FPC:Hirose_FH12-40S-0.5SH_1x40-1MP_P0.50mm_Horizontal |  |  |  | J13
1 | SWITCH | Connector_JST:JST_PH_B2B-PH-K_1x02_P2.00mm_Vertical | C131337 | B2B-PH-K-S |  | J14
1 | JTAG | Connector_PinHeader_2.54mm:PinHeader_1x06_P2.54mm_Vertical |  |  | DNP | J2
1 | TEST | Connector_PinHeader_2.54mm:PinHeader_2x10_P2.54mm_Vertical |  |  | DNP | J3
1 | TF-01A |  | C91145 | TF-01A |  | J4
1 | HR911105A | Connector_RJ:RJ45_Hanrun_HR911105A_Horizontal | C12074 | HR911105A |  | J5
1 | TYPE-C-31-M-12 | Connector_USB:USB_C_Receptacle_HRO_TYPE-C-31-M-12 | C165948 | TYPE-C-31-M-12 |  | J6
1 | UART TEST | Connector_PinHeader_2.54mm:PinHeader_1x03_P2.54mm_Vertical |  |  | DNP | J7
1 | SENSOR | Connector_JST:JST_PH_B4B-PH-K_1x04_P2.00mm_Vertical |  | B4B-PH-K-S |  | J8
2 | ANALOG IN | Connector_PinHeader_2.54mm:PinHeader_2x05_P2.54mm_Vertical |  |  |  | J9 J10
1 | JUMPER | Connector_PinHeader_2.54mm:PinHeader_1x02_P2.54mm_Vertical |  |  |  | JP1
3 | 2u2 | Inductor_SMD:L_Sunlord_SWPA4030S |  | SWPA4030S2R2MT |  | L1 L2 L3
1 | 10u | Inductor_SMD:L_Sunlord_SWPA4030S |  | SWPA4030S100MT |  | L4
4 | AO3401A | Package_TO_SOT_SMD:SOT-23 | C15127 | AO3401A |  | Q1 Q2 Q3 Q12
9 | BSS138 | Package_TO_SOT_SMD:SOT-23 |  | BSS138 |  | Q4 Q5 Q6 Q7 Q8 Q9 Q10 Q11 Q13
13 | 100k | Resistor_SMD:R_0402_1005Metric | C25741 |  |  | R1 R2 R3 R4 R6 R13 R14 R16 R18 R81 R83 R87 R105
22 | 10k | Resistor_SMD:R_0402_1005Metric | C25744 |  |  | R10 R15 R19 R27 R36 R37 R51 R52 R53 R60 R70 R71 R88 R93 R94 R100 R101 R104 R107 R108 R109 R110
1 | 10R | Resistor_SMD:R_0402_1005Metric | C25077 |  |  | R106
1 | 68k | Resistor_SMD:R_0402_1005Metric |  |  |  | R11
1 | 15k | Resistor_SMD:R_0402_1005Metric | C25756 |  |  | R12
1 | 0R | Resistor_SMD:R_0402_1005Metric | C17168 |  |  | R17
12 | 1k | Resistor_SMD:R_0402_1005Metric | C11702 |  |  | R20 R21 R28 R29 R42 R82 R111 R112 R113 R114 R115 R116
21 | 4k7 | Resistor_SMD:R_0402_1005Metric | C25900 |  |  | R22 R23 R24 R25 R26 R30 R31 R35 R38 R43 R44 R45 R46 R47 R48 R49 R50 R91 R92 R98 R99
12 | 33R | Resistor_SMD:R_0402_1005Metric | C25105 |  |  | R32 R40 R54 R61 R62 R63 R64 R65 R66 R95 R102 R103
4 | 0R | Resistor_SMD:R_0402_1005Metric | C17168 |  | DNP | R33 R34 R41 R86
1 | 1k | Resistor_SMD:R_0402_1005Metric | C11702 |  | DNP | R39
2 | 1M | Resistor_SMD:R_0402_1005Metric | C26083 |  |  | R5 R77
5 | 47k | Resistor_SMD:R_0402_1005Metric | C25792 |  |  | R55 R56 R57 R58 R59
2 | 330R | Resistor_SMD:R_0402_1005Metric | C25104 |  |  | R67 R68
1 | 12k1 | Resistor_SMD:R_0402_1005Metric |  |  |  | R69
2 | 20k | Resistor_SMD:R_0402_1005Metric | C25765 |  |  | R7 R9
1 | 2k2 | Resistor_SMD:R_0402_1005Metric | C25879 |  |  | R72
4 | 49R9 | Resistor_SMD:R_0402_1005Metric | C25120 |  |  | R73 R74 R75 R76
2 | 5k1 | Resistor_SMD:R_0402_1005Metric | C25905 |  |  | R78 R79
1 | 30k | Resistor_SMD:R_0402_1005Metric |  |  |  | R8
1 | 150k | Resistor_SMD:R_0402_1005Metric |  |  |  | R80
2 | 100R | Resistor_SMD:R_0402_1005Metric | C25076 |  |  | R84 R85
4 | 2k2 | Resistor_SMD:R_0402_1005Metric | C25879 |  | DNP | R89 R90 R96 R97
5 | TS-1187A | Button_Switch_SMD:SW_Push_1P1T_XKB_TS-1187A | C318884 | TS-1187A-B-A-B |  | SW1 SW2 SW3 SW4 SW5
1 | PG2L50H-6IFBG484 |  |  |  |  | U1
1 | LAN8742AI-CZ | Package_DFN_QFN:QFN-24-1EP_4x4mm_P0.5mm_EP2.6x2.6mm | C621425 | LAN8742AI-CZ-TR |  | U10
2 | USBLC6-2SC6 | Package_TO_SOT_SMD:SOT-23-6 | C7519 | USBLC6-2SC6 |  | U11 U13
1 | CH340N | Package_SO:SOIC-8_3.9x4.9mm_P1.27mm | C2977777 | CH340N |  | U12
2 | NAU88C22YG | Package_DFN_QFN:QFN-32-1EP_5x5mm_P0.5mm_EP3.45x3.45mm | C914209 | NAU88C22YG |  | U14 U15
1 | TPS61169DCKR | Package_TO_SOT_SMD:SOT-353_SC-70-5 |  | TPS61169DCKR |  | U16
1 | XC6206P332MR | Package_TO_SOT_SMD:SOT-23 | C5446 | XC6206P332MR |  | U2
3 | TLV62569PDDCR | Package_TO_SOT_SMD:TSOT-23-6 | C398365 | TLV62569PDDCR |  | U3 U4 U5
1 | W25Q256JVEIQ | Package_SON:WSON-8-1EP_8x6mm_P1.27mm_EP3.4x4.3mm | C97522 | W25Q256JVEIQ |  | U6
1 | ATECC608C-SSHDA | Package_SO:SOIC-8_3.9x4.9mm_P1.27mm | C28975195 | ATECC608C-SSHDA-T |  | U7
1 | YSN8130E |  | C48888238 | YSN8130E |  | U8
1 | ESP-PSRAM64H | Package_SO:SOIC-8_3.9x4.9mm_P1.27mm |  | ESP-PSRAM64H |  | U9
1 | 50MHz | Oscillator:Oscillator_SMD_Abracon_ASE-4Pin_3.2x2.5mm |  |  |  | Y1
1 | 25MHz | Crystal:Crystal_SMD_3225-4Pin_3.2x2.5mm | C9006 | X322525MOB4SI |  | Y2
