bradleyeckert/thriller/doc/test.md

# Test Plan

How `thriller` is tested, from reference models to fault injection. Risk IDs (R1–R46) refer to `doc/arch.md`.

## 1. Approach

Security lives in three places: the FPGA's configuration engine (the vendor's, characterized by the vendor), the TPM (validated), and our own RTL and Forth in the loader domain.
Testing therefore concentrates on:

- **our protocols and their implementation:** packages, the TPM sessions, the ratchet, host sessions, recordings, sensor pairing and sessions, user data, the event log, attestation;
- **our RTL:** the XIP engine, key paths and the key gate, the recording engine, the mailbox, the TRNG, the security block;
- **the chip configurations:** FPGA eFuses and locks, the TPM's NV layout and policies;
- **fault injection and side channels** on the checks we write, and on the vendor's claimed countermeasures.

### Layers

| Layer | What | Where |
|---|---|---|
| 1. Reference models | Python models of every format and protocol: package layout and signatures, key derivations, per-line Ascon-AEAD128, headers and boot record, TPM sessions and policies, ratchet, recording segments, host session, sensor pairing and session, user data records, event log chain, attestation report | Workstation; produce test vectors |
| 2. Unit tests | RTL modules against the vectors in Verilator; loader Forth against the same vectors in LiteForth's `vm.c` with modeled peripherals; a TPM 2.0 software stack (tpm2-tools or a Python TSS) against a real TPM and against the Microsoft TPM 2.0 reference simulator for the sessions and policies | Workstation and bench |
| 3. System tests | Whole device against simulated host, sensor, server, network and card | Hardware-in-the-loop rig |
| 4. Fault injection and side channels | Attacks on one unit | Lab bench |
| 5. Penetration test | Independent team, whole system | External |

### Evidence

Each test names the risk it covers. The catalogue below is the traceability matrix between risks and tests that an FDA submission needs (`doc/fda.md`).

## 2. Reference models

- **Formats:** platform and application packages, manifests and inclusion proofs, developer packages, image headers, XIP lines and tags, the boot record, records in flash, TPM command and response frames, recording segment headers and blocks, sensor certificates and transcripts, session frames, user data records, log entries, attestation reports.
- **Cryptography:** known-answer tests for each algorithm from the standards (LMS from RFC 8554, ML-KEM and ML-DSA from the FIPS 203 and 204 vectors, Ascon-AEAD128 and Ascon-Hash256 from the SP 800-232 vectors, HMAC-SHA256 KDF from SP 800-108, the TPM 2.0 session KDFa, HMAC and XOR parameter-encryption formats from the TPM reference implementation); the same vectors drive the RTL and the Forth.
- **Protocols:** both ends of the host session, the sensor protocol and the server exchange, so each end can be tested against a model of the other; the TPM reference simulator with our NV layout and policies loaded, so a policy mistake shows up in simulation before a part is provisioned.

The sensor's firmware is tested against the same models.

## 3. Hardware-in-the-loop rig

- A production-configured board (locked FPGA, provisioned TPM, flash, CODECs, LCD, card), plus boards with the eFuses left open, an unlocked FPGA and a TPM with its platform hierarchy still open for debugging.
- **Interposers** on the QSPI flash (or a flash emulator), on the TPM's SPI bus, and on one I2S bus, able to record, replay and alter traffic.
- **Signal source** on the CODEC inputs: synthetic EEG at known levels.
- **Host simulator** on the UART and on the LAN, driven by test scripts.
- **Network test harness:** a switch, a packet generator and a server simulator able to act as the edge proxy, the DHCP server or a fake server, and to drop, delay, replay and flood.
  Everything from the RMII pins outward is attacker territory, so the harness is driven as an attacker: boofuzz (the successor to Sulley) generates the malformed ARP, IP, ICMP, UDP and DHCP
  traffic and the malformed session frames, with the device's response and its UART status as the monitor.
- **Sensor simulator** on the sensor link, able to misbehave on command (bad certificates, wrong MACs, replays, delays, silence), and a **link interposer** between it and the device.
- **Power control** for power cuts at chosen points during installs, the ratchet write and pairing.
- A flash programmer, and a JTAG pod on unlocked FPGAs.

## 4. Test catalogue

| Area | Tests | Risks |
|---|---|---|
| Bitstream | Configuration bus capture shows only ciphertext; an unencrypted, unsigned or altered bitstream is refused; one encrypted for another device fails to configure; an older bitstream of the same device, after an update, pairs with neither key and stays in recovery; corrupting the active slot falls back to the other slot with the same result | R17, R31, R32, R44 |
| Ratchet | Power cut before, during and after `TPM2_NV_ChangeAuth` at each boot leaves a device that boots; a release that fails to configure leaves the old release working; a skipped-release package built for the wrong inherited key is refused by the TPM and reported | R4, R17 |
| Boot chain | Forged or old loader header refused by the boot ROM; forged or old application header refused by the loader; slot fallback when an image fails; recovery when both fail; a header for another device's application key fails | R2, R4, R34, R35 |
| XIP | Each attack in `doc/xip.md`: modified, moved, other-slot and earlier-install lines; a whole older image written back; flash copied from another board; an emulator swapping lines after boot; all fail and lock down, and the next boot falls back | R6 |
| Updates | Forged LMS signature, bad inclusion proof, altered ciphertext, wrong distribution key, truncated package: all refused before any flash write, for both chains; a platform package for another device refused; power cut at every step leaves a bootable device; a new image that fails its checks is never selected | R3, R18 |
| TPM | Every read with a replayed or forged response fails its HMAC; altered sealed data fails the response HMAC before it reaches a key register; a counter increment or NV write without the pairing policy is refused; the data key is not unsealed without the host's HMAC, and a wrong one counts against the lockout; a `TPM2_Clear` or platform command after the boot ROM has run is refused; the NV and policy dump matches `doc/tpm.md` after provisioning | R1, R36 |
| Key isolation | No instruction sequence or bus access on any core reads a key (simulation over every register address, and on hardware); the application core's buses have no path into the loader domain (netlist connectivity check); no debug port in production bitstreams; keys cleared on reset, reconfiguration and failures | R8, R37 |
| Mailbox | Parser fuzzing on the software platform; oversized, misaligned and racing requests rejected; a request changed after submission has no effect | R45 |
| Debug lockdown | JTAG unusable after enrollment; UART recovery accepts only signed loader packages and reads out nothing | R7, R43 |
| Host session | Wrong host key, replayed challenge, reordered, altered and replayed frames, all rejected; no user data access outside a session; attempt limits and logging | R9, R28 |
| User data | Card read offline shows no plaintext; altered records rejected; an old copy of the card detected through the freshness index; developer and production data mutually unreadable | R1, R10, R21 |
| Attestation | A report with a stale nonce, a forged signature or a wrong MAC is rejected by the verifier model; a report from a bitstream with a retired pairing key cannot be obtained; the report's versions match the installed images | R16 |
| Sensor pairing | Certificate signed by an unknown CA, altered certificate, denylisted serial, wrong private key (implicit rejection) all refused; power cut during pairing leaves the old pairing or none; server rejection removes the pairing | R14, R15 |
| Sensor session | Forged, replayed, reordered and delayed frames rejected; readings older than the maximum age rejected; link cut puts the device in its safe state within the maximum age | R11, R12, R13 |
| Recordings | Card and network capture show no plaintext; the loader's memory holds a segment key only in masked form and only during encapsulation; the recording engine accepts no samples without a key; the host detects dropped, reordered and substituted blocks and segments; segment keys erased at segment end | R39, R41 |
| Real-time clock | An alarm from deep sleep powers the device up through the complete chain, with the boot cause recorded; the loader's sleep sequence flushes the stream buffer and closes the card before releasing power-hold; a device whose RTC is set arbitrarily still attests correctly and its recordings still carry correct beacons; a forced reboot during a recording leaves a segment the host reads up to the last complete block | R49 |
| Stream buffer | PSRAM bus capture shows only ciphertext; a block corrupted in the PSRAM is rejected by the host; a stalled card and a stalled network are ridden out for at least ten seconds without sample loss; overflow raises the alarm and the log entry and overwrites nothing; power loss during recording leaves a segment the host can read up to the last complete block | R48 |
| Recording time | A forged or replayed beacon is rejected by the HMAC check through the TPM; a header's beacon cannot be altered without the segment failing; offline recordings are bracketed by the last and next beacons; a slowed oscillator shows as a rate mismatch at the host; recordings from a never-connected device are marked undated | R47 |
| Enrollment | Unenrolled device cannot install updates or authenticate; enrollment cannot be repeated; server flags unknown and duplicate identities | R16 |
| Developer builds | Package for another device refused; old-epoch builds refused after an epoch release; counter 1 unchanged by developer installs; developer mode shown on the overlay whatever the application draws | R21, R22 |
| Event log | Removed or altered entries detected by the host and the server | R26 |
| Network policy and transport | A release with the port disabled holds the PHY in reset, and no software path releases it; RTL fuzzing of the Ethernet transport (malformed ARP, IP, ICMP and UDP headers, bad checksums, runt and giant frames, floods) in simulation and on hardware never delivers a payload that is not a well-formed UDP datagram to our port, and never wedges the transport beyond a re-initialization; ARP and DHCP spoofing cause only loss of connectivity; CLI refuses commands without a session; developer commands absent from production builds; the supervisor's framing and DHCP code fuzzed on the software platform and from the network, and a crashed supervisor leaves the module's state and the recording intact (R50) | R23, R28, R50 |
| Network updates | Fake server, hostile edge proxy and injected datagrams: forged, old and truncated packages refused; interrupted download leaves the old image active; server authentication failure stops the exchange | R29 |
| UART status | Status output contains no user data or keys | R30 |
| Coexistence | Sensor timing and safe-state behavior unaffected by recording, card and network load, including floods | R13 |

## 5. Fault injection

### Threat

A lab attacker glitches the FPGA to skip a check: a header comparison, a version comparison, an HMAC comparison in the TPM session, sensor or host protocol, a tag comparison in the XIP engine.
On the configuration engine, a glitch could make it accept a bad bitstream; that is the vendor's countermeasure to test.

### Countermeasures to build into our RTL and Forth

1. Compare MACs, tags and signatures in constant time, in hardware comparators, and check each security decision twice, with the second check on a complemented value.
2. Encode success as a multi-bit pass token, never 0 or 1, so a single skipped instruction or zeroed register cannot produce it; keys load only on pass tokens.
3. Count loop iterations in signature and MAC checks, and check the count at the end (the flow counter in the security block).
4. Random delays before critical checks (the TRNG is available).
5. On any inconsistency, lock down; never retry silently.
6. Encoded state machines in the fill, key gate and TPM session sequencers that a single bit flip cannot advance.
7. Clock checker and supply monitor inputs to the security block; their events are logged.

### Campaigns

| Campaign | Method | Target | Pass |
|---|---|---|---|
| A. Package check | Voltage glitch (crowbar on the core supply) and EM pulses during the loader's LMS check | Install a package with a bad signature | No bad package installed in the campaign budget; detections logged |
| B. Header and version | Same, during the boot ROM's and loader's header checks | Boot an old or forged image | Never boots |
| C. TPM session HMACs | Same, during HMAC comparison | Accept a forged counter read or altered sealed data | Never accepted |
| D. Sensor and host MACs | Same, during frame verification | Accept a forged reading or frame | Never accepted |
| E. XIP tag check | Voltage and clock glitches during line fills; first in Verilator with injected faults, then on hardware | Execute a line whose tag failed | Never executed |
| F. Configuration engine | Voltage and EM glitches during configuration | Configure an unsigned or altered bitstream | Never configures; the vendor's detectors fire where present |
| G. Key gate | Glitches during key loading | Load a key without its pass token | Never loads |

### TRNG characterization

SP 800-90B wants two kinds of data from an entropy source: a long sequential run, and a **restart** data set of about a thousand power-ups with the first thousand samples from each, to show that the
source is as random at a cold start as in steady state (ring oscillators are the classic case where it may not be). The RTC makes the second automatic:

1. A test build whose boot ROM, before anything else, logs the first raw noise-source samples (pre-conditioning) and the health-test counters to the MicroSD card, then programs the RTC alarm a few
   seconds ahead, and powers down.
2. The RTC wakes the device from deep sleep a thousand times (`doc/hw.md`, Real-time clock), across the temperature and voltage corners the rig can set.
3. The card's log feeds NIST's SP 800-90B estimator suite: the IID tests, the non-IID min-entropy estimators, and the restart tests (row and column), per corner.
4. The result sets the conditioner's input ratio and the health-test cutoffs in production builds, and is the entropy evidence for any FIPS or FDA question about the source (A11).

The same campaign runs on each FPGA family and on ASIC silicon, since ring-oscillator behavior is process-specific.

### Side channels

- **Configuration decryption:** test-vector leakage assessment (TVLA) on the configuration engine as far as the family allows; on the Logos2 the question is how much the fixed legitimate bitstream leaks over repeated power-ups, since chosen ciphertexts are refused (R5).
- **Ascon core:** TVLA on the masked core as used by the XIP engine, the recording engine and the install port, including key loading, with the mask PRNG running and with it deliberately stalled to confirm the masking is what protects it (R33).
- **SHA-256 core:** TVLA with the pairing key and the HMAC keys; the result decides whether the core must be masked (H4).
- **TPM:** the part's validation covers it; the session KDFa and HMACs in the SHA-256 core, which also produces the XOR stream for encrypted parameters, are covered by the SHA-256 core's TVLA.
- **Sensor:** TVLA on the sensor's ML-KEM decapsulation and MAC. A broken sensor exposes only itself (R15).

## 6. Tools

| Tool | Use |
|---|---|
| Verilator | The security RTL, with fault injection, against the vectors |
| LiteForth `vm.c` and `stage1sim` | The loader and application Forth with modeled peripherals; two cores and the mailbox |
| tpm2-tools or a Python TSS, the Microsoft TPM 2.0 reference simulator, an SPI TPM evaluation board | Exercising the NV layout, policies and sessions in simulation and on real TPMs before provisioning |
| Python (`cryptography`, reference implementations of LMS, ML-KEM, ML-DSA) | Reference models and vectors |
| boofuzz, Scapy and a managed switch | Protocol fuzzing of the Ethernet transport and the session protocol from the network; the edge proxy, DHCP and fake-server cases. boofuzz's block-based grammars suit the fixed header and frame formats, and the same grammars drive the RTL fuzzing in Verilator through a Python harness |
| ChipWhisperer-Husky, a voltage glitch stage, an EMFI probe | Fault injection |
| A scope or ChipWhisperer for power traces | TVLA |
| The family's programmer and tools | eFuse state, encrypted bitstream generation |

## 7. Open questions

See `doc/questions.md` (Test rows).
