bradleyeckert/thriller/fpga/logos2/KiCAD/thriller/th_audio.kicad_sch

## KiCad design fpga/logos2/KiCAD/thriller/th_audio.kicad_sch (2026-11-13)

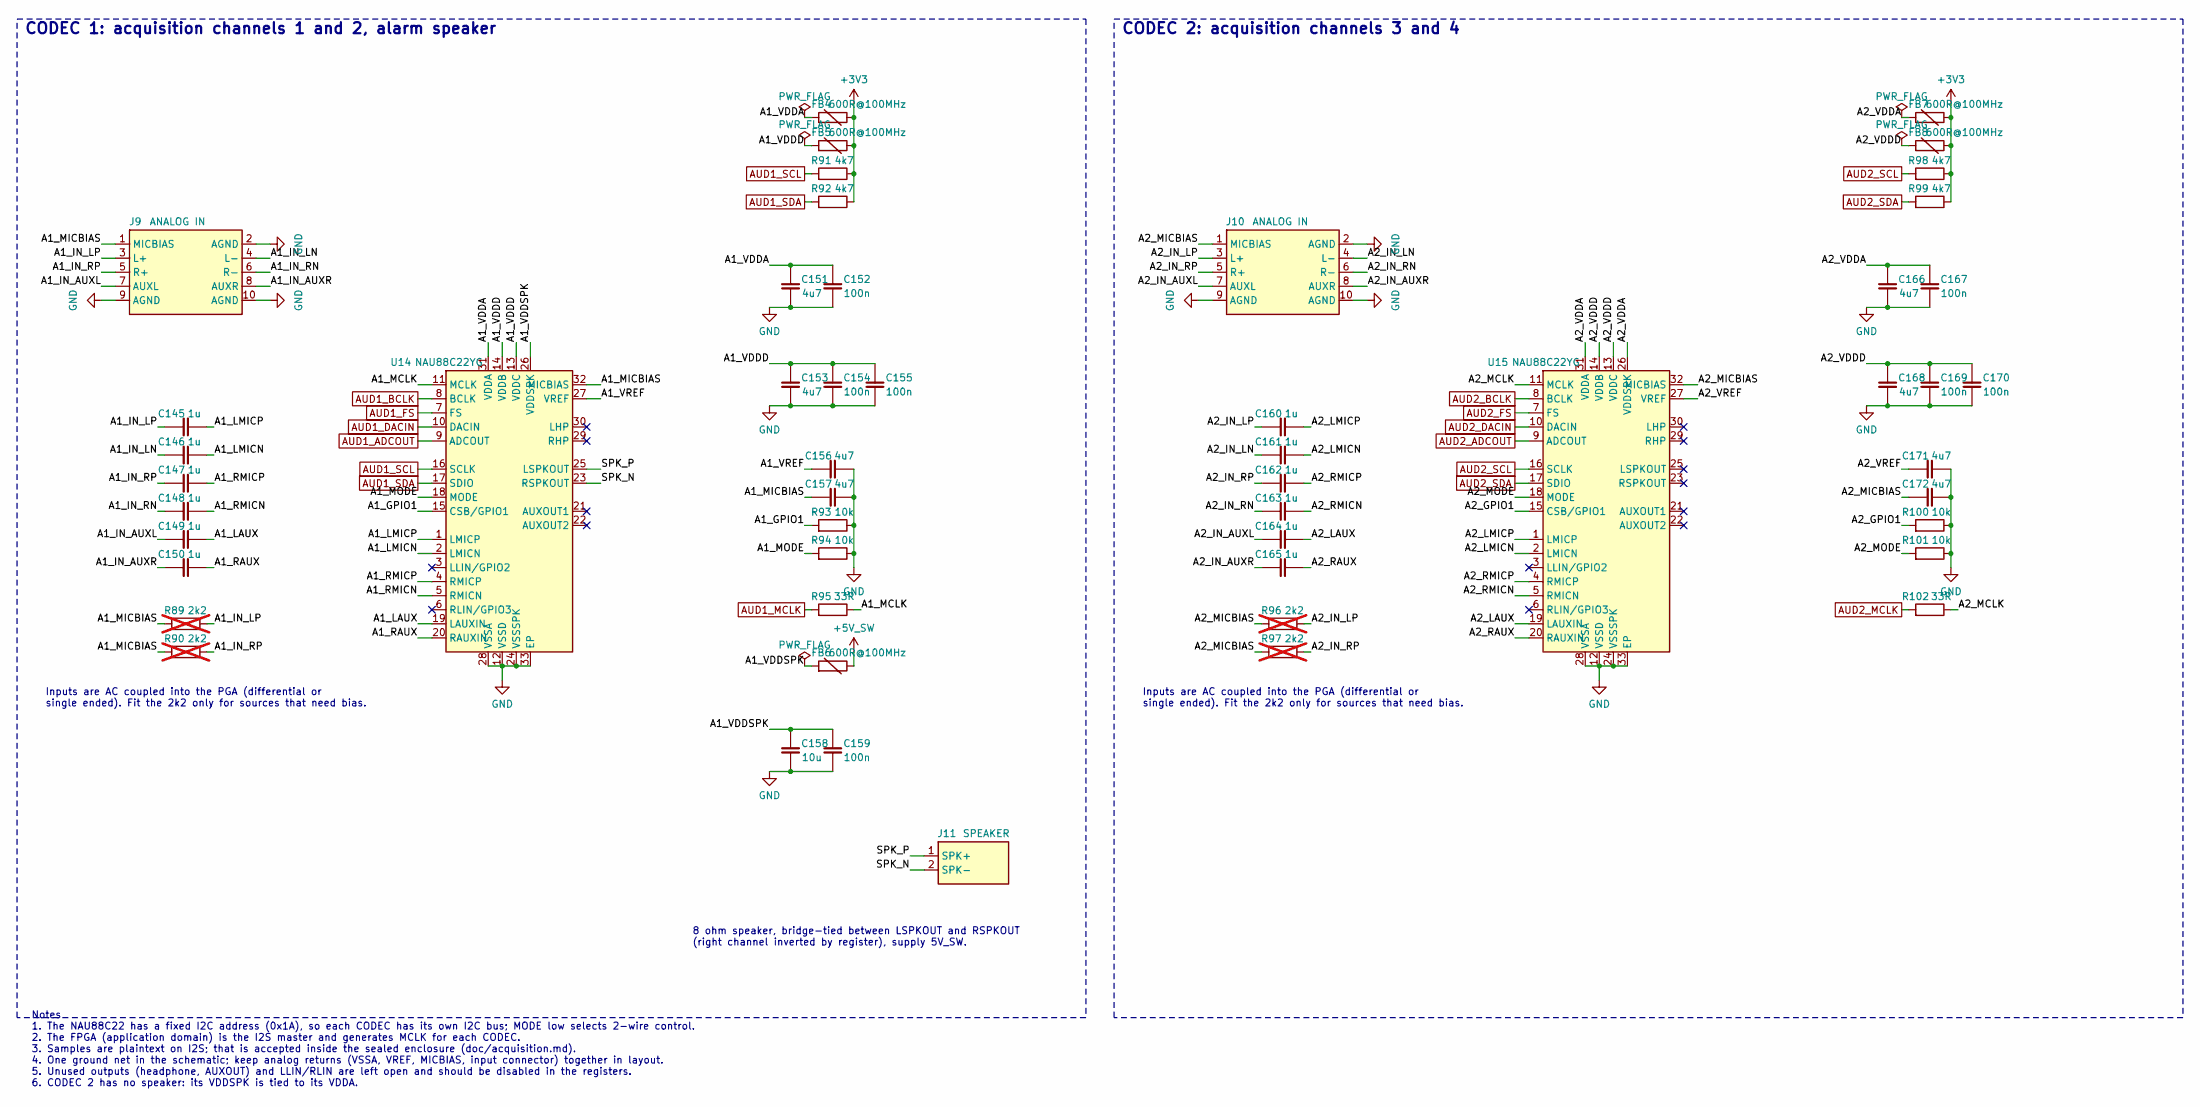
[picture p1: schematic th_audio.kicad_sch]

Parts:
C145, C146, C147, C148, C149, C150, C160, C161, C162, C163, C164, C165: 1u; C_0402_1005Metric; LCSC C52923
C151, C153, C156, C157, C166, C168, C171, C172: 4u7; C_0603_1608Metric; LCSC C19666
C152, C154, C155, C159, C167, C169, C170: 100n; C_0402_1005Metric; LCSC C1525
C158: 10u; C_0603_1608Metric; LCSC C19702
FB4, FB5, FB6, FB7, FB8: 600R@100MHz; L_0603_1608Metric; MPN GZ1608D601TF; LCSC C1002
J9, J10: ANALOG IN; PinHeader_2x05_P2.54mm_Vertical
J11: SPEAKER; JST_PH_B2B-PH-K_1x02_P2.00mm_Vertical; MPN B2B-PH-K-S; LCSC C131337
R89, R90, R96, R97: 2k2; R_0402_1005Metric; LCSC C25879; not fitted
R91, R92, R98, R99: 4k7; R_0402_1005Metric; LCSC C25900
R93, R94, R100, R101: 10k; R_0402_1005Metric; LCSC C25744
R95, R102: 33R; R_0402_1005Metric; LCSC C25105
U14, U15: NAU88C22YG; QFN-32-1EP_5x5mm_P0.5mm_EP3.45x3.45mm; MPN NAU88C22YG; LCSC C914209

Connections:
+3V3: FB4.2, FB5.2, FB7.2, FB8.2, R91.2, R92.2, R98.2, R99.2
+5V_SW: FB6.2
A1_GPIO1: R93.1, U14.15 (CSB/GPIO1)
A1_IN_AUXL: C149.1, J9.7 (AUXL)
A1_IN_AUXR: C150.1, J9.8 (AUXR)
A1_IN_LN: C146.1, J9.4 (L-)
A1_IN_LP: C145.1, J9.3 (L+), R89.2
A1_IN_RN: C148.1, J9.6 (R-)
A1_IN_RP: C147.1, J9.5 (R+), R90.2
A1_LAUX: C149.2, U14.19 (LAUXIN)
A1_LMICN: C146.2, U14.2 (LMICN)
A1_LMICP: C145.2, U14.1 (LMICP)
A1_MCLK: R95.2, U14.11 (MCLK)
A1_MICBIAS: C157.1, J9.1 (MICBIAS), R89.1, R90.1, U14.32 (MICBIAS)
A1_MODE: R94.1, U14.18 (MODE)
A1_RAUX: C150.2, U14.20 (RAUXIN)
A1_RMICN: C148.2, U14.5 (RMICN)
A1_RMICP: C147.2, U14.4 (RMICP)
A1_VREF: C156.1, U14.27 (VREF)
A2_GPIO1: R100.1, U15.15 (CSB/GPIO1)
A2_IN_AUXL: C164.1, J10.7 (AUXL)
A2_IN_AUXR: C165.1, J10.8 (AUXR)
A2_IN_LN: C161.1, J10.4 (L-)
A2_IN_LP: C160.1, J10.3 (L+), R96.2
A2_IN_RN: C163.1, J10.6 (R-)
A2_IN_RP: C162.1, J10.5 (R+), R97.2
A2_LAUX: C164.2, U15.19 (LAUXIN)
A2_LMICN: C161.2, U15.2 (LMICN)
A2_LMICP: C160.2, U15.1 (LMICP)
A2_MCLK: R102.2, U15.11 (MCLK)
A2_MICBIAS: C172.1, J10.1 (MICBIAS), R96.1, R97.1, U15.32 (MICBIAS)
A2_MODE: R101.1, U15.18 (MODE)
A2_RAUX: C165.2, U15.20 (RAUXIN)
A2_RMICN: C163.2, U15.5 (RMICN)
A2_RMICP: C162.2, U15.4 (RMICP)
A2_VREF: C171.1, U15.27 (VREF)
AUD1_ADCOUT: U14.9 (ADCOUT)
AUD1_BCLK: U14.8 (BCLK)
AUD1_DACIN: U14.10 (DACIN)
AUD1_FS: U14.7 (FS)
AUD1_MCLK: R95.1
AUD1_SCL: R91.1, U14.16 (SCLK)
AUD1_SDA: R92.1, U14.17 (SDIO)
AUD2_ADCOUT: U15.9 (ADCOUT)
AUD2_BCLK: U15.8 (BCLK)
AUD2_DACIN: U15.10 (DACIN)
AUD2_FS: U15.7 (FS)
AUD2_MCLK: R102.1
AUD2_SCL: R98.1, U15.16 (SCLK)
AUD2_SDA: R99.1, U15.17 (SDIO)
GND: C151.2, C152.2, C153.2, C154.2, C155.2, C156.2, C157.2, C158.2, C159.2, C166.2, C167.2, C168.2, C169.2, C170.2, C171.2, C172.2, J9.2 (AGND), J9.9 (AGND), J9.10 (AGND), J10.2 (AGND), J10.9 (AGND), J10.10 (AGND), R93.2, R94.2, R100.2, R101.2, U14.12 (VSSD), U14.24 (VSSSPK), U14.28 (VSSA), U14.33 (EP), U15.12 (VSSD), U15.24 (VSSSPK), U15.28 (VSSA), U15.33 (EP)
PWR_FLAG: C151.1, C152.1, C153.1, C154.1, C155.1, C158.1, C159.1, C166.1, C167.1, C168.1, C169.1, C170.1, FB4.1, FB5.1, FB6.1, FB7.1, FB8.1, U14.13 (VDDC), U14.14 (VDDB), U14.26 (VDDSPK), U14.31 (VDDA), U15.13 (VDDC), U15.14 (VDDB), U15.26 (VDDSPK), U15.31 (VDDA)
SPK_N: J11.2 (SPK-), U14.23 (RSPKOUT)
SPK_P: J11.1 (SPK+), U14.25 (LSPKOUT)

Notes on the sheet:
CODEC 1: acquisition channels 1 and 2, alarm speaker
Inputs are AC coupled into the PGA (differential or single ended). Fit the 2k2 only for sources that need bias.
8 ohm speaker, bridge-tied between LSPKOUT and RSPKOUT (right channel inverted by register), supply 5V_SW.
CODEC 2: acquisition channels 3 and 4
Notes 1. The NAU88C22 has a fixed I2C address (0x1A), so each CODEC has its own I2C bus; MODE low selects 2-wire control. 2. The FPGA (application domain) is the I2S master and generates MCLK for each CODEC. 3. Samples are plaintext on I2S; that is accepted inside the sealed enclosure (doc/acquisit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
