bradleyeckert/thriller/fpga/logos2/KiCAD/thriller/th_base.kicad_sch

## KiCad design fpga/logos2/KiCAD/thriller/th_base.kicad_sch (2026-11-13)

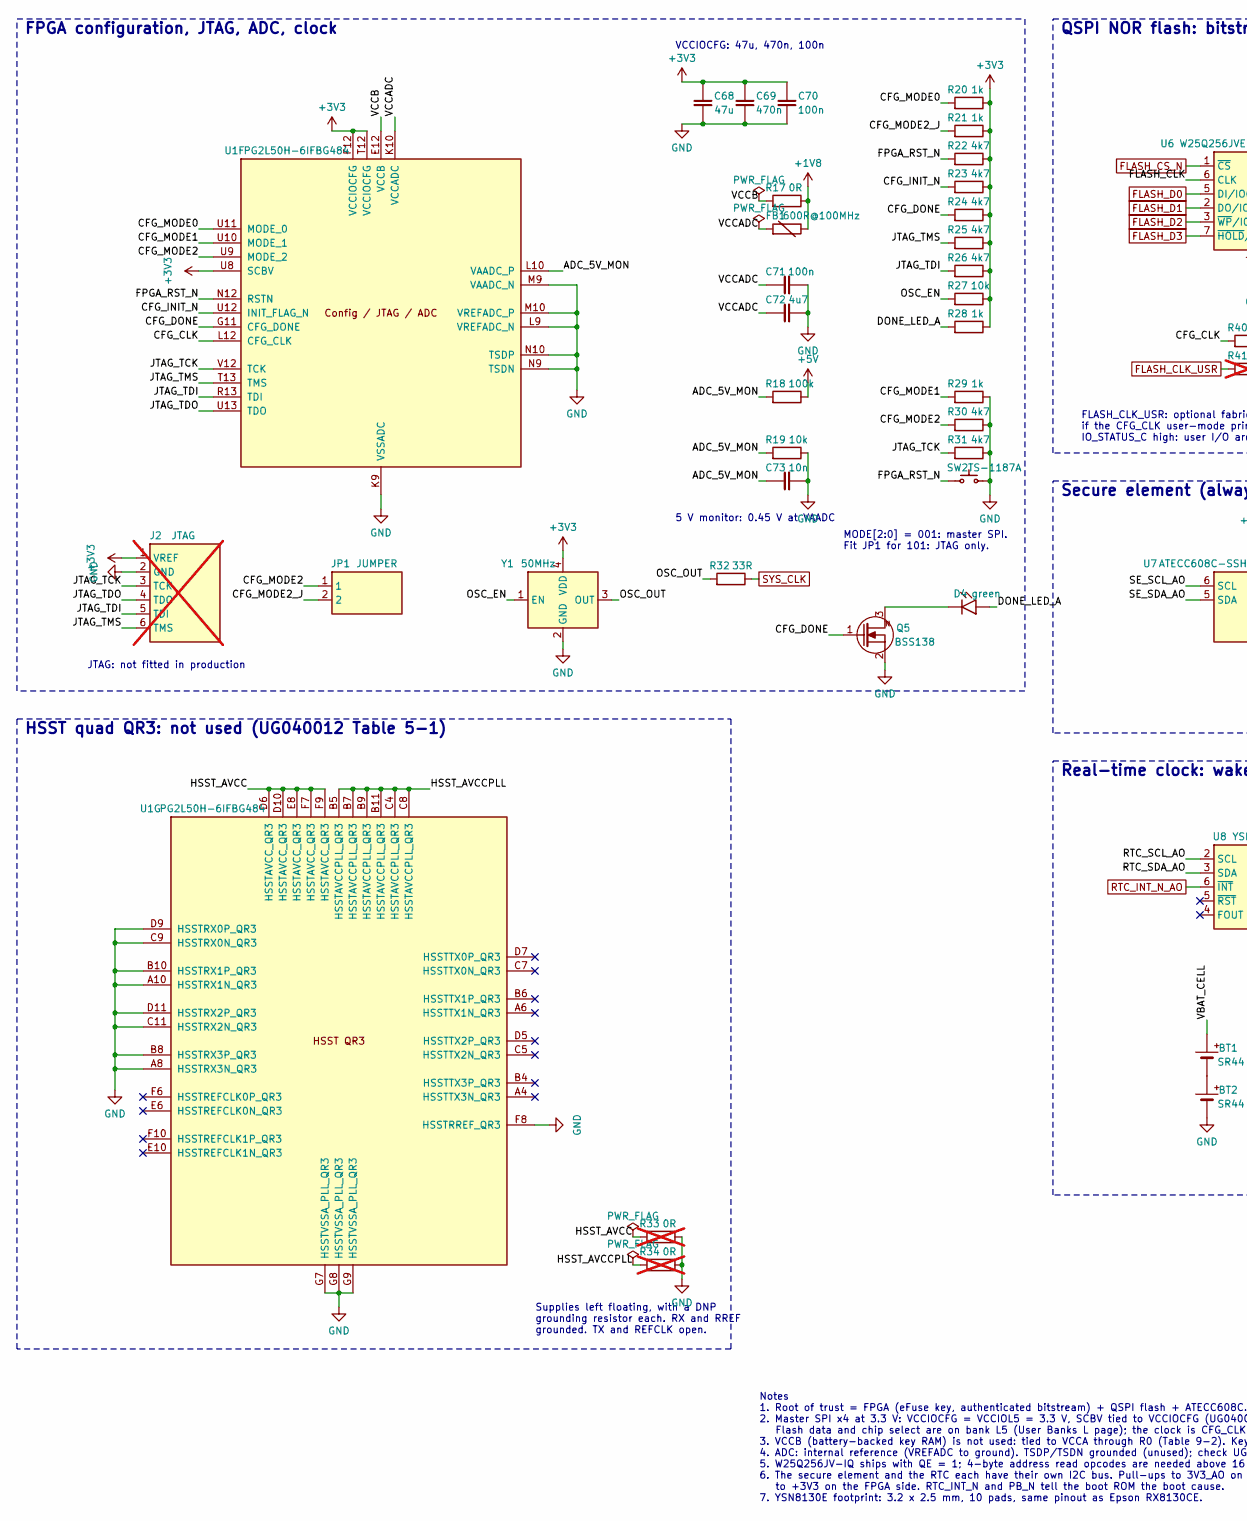
[picture p2: schematic th_base.kicad_sch, part in row 1, column 1]

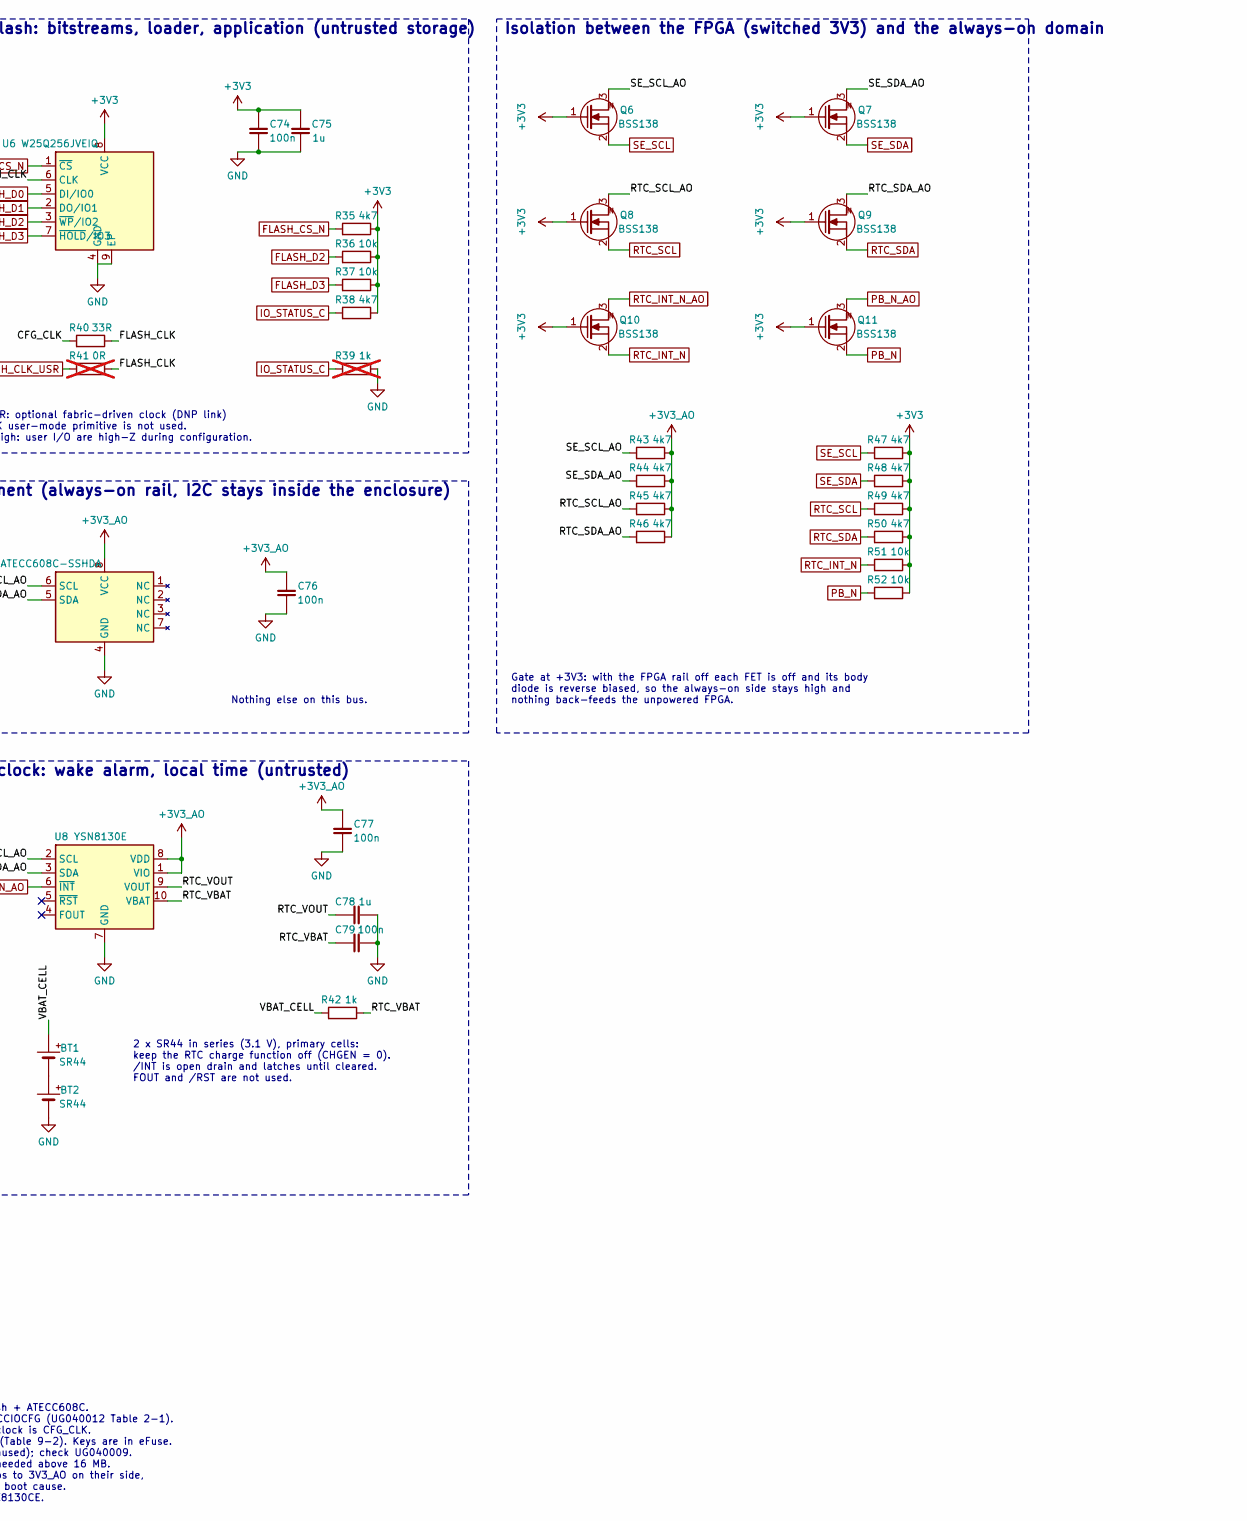
[picture p3: schematic th_base.kicad_sch, part in row 1, column 2]

Parts:
BT1, BT2: SR44
C68: 47u; C_1206_3216Metric; LCSC C96123
C69: 470n; C_0402_1005Metric
C70, C71, C74, C76, C77, C79: 100n; C_0402_1005Metric; LCSC C1525
C72: 4u7; C_0603_1608Metric; LCSC C19666
C73: 10n; C_0402_1005Metric; LCSC C15195
C75, C78: 1u; C_0402_1005Metric; LCSC C52923
D4: green; LED_0603_1608Metric; LCSC C72043
FB1: 600R@100MHz; L_0603_1608Metric; MPN GZ1608D601TF; LCSC C1002
J2: JTAG; PinHeader_1x06_P2.54mm_Vertical; not fitted
JP1: JUMPER; PinHeader_1x02_P2.54mm_Vertical
Q5, Q6, Q7, Q8, Q9, Q10, Q11: BSS138; SOT-23; MPN BSS138
R17: 0R; R_0402_1005Metric; LCSC C17168
R18: 100k; R_0402_1005Metric; LCSC C25741
R19, R27, R36, R37, R51, R52: 10k; R_0402_1005Metric; LCSC C25744
R20, R21, R28, R29, R42: 1k; R_0402_1005Metric; LCSC C11702
R22, R23, R24, R25, R26, R30, R31, R35, R38, R43, R44, R45, R46, R47, R48, R49, R50: 4k7; R_0402_1005Metric; LCSC C25900
R32, R40: 33R; R_0402_1005Metric; LCSC C25105
R33, R34, R41: 0R; R_0402_1005Metric; LCSC C17168; not fitted
R39: 1k; R_0402_1005Metric; LCSC C11702; not fitted
SW2: TS-1187A; SW_Push_1P1T_XKB_TS-1187A; MPN TS-1187A-B-A-B; LCSC C318884
U1: PG2L50H-6IFBG484; BGA-484_23.0x23.0mm_Layout22x22_P1.0mm
U6: W25Q256JVEIQ; WSON-8-1EP_8x6mm_P1.27mm_EP3.4x4.3mm; MPN W25Q256JVEIQ; LCSC C97522
U7: ATECC608C-SSHDA; SOIC-8_3.9x4.9mm_P1.27mm; MPN ATECC608C-SSHDA-T; LCSC C28975195
U8: YSN8130E; MPN YSN8130E; LCSC C48888238
Y1: 50MHz; Oscillator_SMD_Abracon_ASE-4Pin_3.2x2.5mm

Connections:
+1V8: FB1.2, R17.2
+3V3: C68.1, C69.1, C70.1, C74.1, C75.1, J2.1 (VREF), Q6.1 (G), Q7.1 (G), Q8.1 (G), Q9.1 (G), Q10.1 (G), Q11.1 (G), R20.2, R21.2, R22.2, R23.2, R24.2, R25.2, R26.2, R27.2, R28.2, R35.2, R36.2, R37.2, R38.2, R47.2, R48.2, R49.2, R50.2, R51.2, R52.2, U1.F12 (VCCIOCFG), U1.T12 (VCCIOCFG), U1.U8 (SCBV), U6.8 (VCC), Y1.4 (VDD)
+3V3_AO: C76.1, C77.1, R43.2, R44.2, R45.2, R46.2, U7.8 (VCC), U8.1 (VIO), U8.8 (VDD)
+5V: R18.2
ADC_5V_MON: C73.1, R18.1, R19.1, U1.L10 (VAADC_P)
CFG_CLK: R40.1, U1.L12 (CFG_CLK)
CFG_DONE: Q5.1 (G), R24.1, U1.G11 (CFG_DONE)
CFG_INIT_N: R23.1, U1.U12 (INIT_FLAG_N)
CFG_MODE0: R20.1, U1.U11 (MODE_0)
CFG_MODE1: R29.1, U1.U10 (MODE_1)
CFG_MODE2: JP1.1, R30.1, U1.U9 (MODE_2)
CFG_MODE2_J: JP1.2, R21.1
DONE_LED_A: D4.2 (A), R28.1
FLASH_CLK: R40.2, R41.2, U6.6 (CLK)
FLASH_CLK_USR: R41.1
FLASH_CS_N: R35.1, U6.1 (~CS)
FLASH_D0: U6.5 (DI/IO0)
FLASH_D1: U6.2 (DO/IO1)
FLASH_D2: R36.1, U6.3 (~WP/IO2)
FLASH_D3: R37.1, U6.7 (~HOLD/IO3)
FPGA_RST_N: R22.1, SW2.1, U1.N12 (RSTN)
GND: BT2.2 (-), C68.2, C69.2, C70.2, C71.2, C72.2, C73.2, C74.2, C75.2, C76.2, C77.2, C78.2, C79.2, J2.2 (GND), Q5.2 (S), R19.2, R29.2, R30.2, R31.2, R33.2, R34.2, R39.2, SW2.2, U1.A8 (HSSTRX3N_QR3), U1.A10 (HSSTRX1N_QR3), U1.B8 (HSSTRX3P_QR3), U1.B10 (HSSTRX1P_QR3), U1.C9 (HSSTRX0N_QR3), U1.C11 (HSSTRX2N_QR3), U1.D9 (HSSTRX0P_QR3), U1.D11 (HSSTRX2P_QR3), U1.F8 (HSSTRREF_QR3), U1.G7 (HSSTVSSA_PLL_QR3), U1.G8 (HSSTVSSA_PLL_QR3), U1.G9 (HSSTVSSA_PLL_QR3), U1.K9 (VSSADC), U1.L9 (VREFADC_N), U1.M9 (VAADC_N), U1.M10 (VREFADC_P), U1.N9 (TSDN), U1.N10 (TSDP), U6.4 (GND), U6.9 (EP), U7.4 (GND), U8.7 (GND), Y1.2 (GND)
IO_STATUS_C: R38.1, R39.1
JTAG_TCK: J2.3 (TCK), R31.1, U1.V12 (TCK)
JTAG_TDI: J2.5 (TDI), R26.1, U1.R13 (TDI)
JTAG_TDO: J2.4 (TDO), U1.U13 (TDO)
JTAG_TMS: J2.6 (TMS), R25.1, U1.T13 (TMS)
unnamed: BT1.2 (-), BT2.1 (+)
unnamed: D4.1 (K), Q5.3 (D)
OSC_EN: R27.1, Y1.1 (EN)
OSC_OUT: R32.1, Y1.3 (OUT)
PB_N: Q11.2 (S), R52.1
PB_N_AO: Q11.3 (D)
PWR_FLAG: C71.1, C72.1, FB1.1, R17.1, R33.1, R34.1, U1.B5 (HSSTAVCCPLL_QR3), U1.B7 (HSSTAVCCPLL_QR3), U1.B9 (HSSTAVCCPLL_QR3), U1.B11 (HSSTAVCCPLL_QR3), U1.C4 (HSSTAVCCPLL_QR3), U1.C8 (HSSTAVCCPLL_QR3), U1.D6 (HSSTAVCC_QR3), U1.D10 (HSSTAVCC_QR3), U1.E8 (HSSTAVCC_QR3), U1.E12 (VCCB), U1.F7 (HSSTAVCC_QR3), U1.F9 (HSSTAVCC_QR3), U1.K10 (VCCADC)
RTC_INT_N: Q10.2 (S), R51.1
RTC_INT_N_AO: Q10.3 (D), U8.6 (~INT)
RTC_SCL: Q8.2 (S), R49.1
RTC_SCL_AO: Q8.3 (D), R45.1, U8.2 (SCL)
RTC_SDA: Q9.2 (S), R50.1
RTC_SDA_AO: Q9.3 (D), R46.1, U8.3 (SDA)
RTC_VBAT: C79.1, R42.2, U8.10 (VBAT)
RTC_VOUT: C78.1, U8.9 (VOUT)
SE_SCL: Q6.2 (S), R47.1
SE_SCL_AO: Q6.3 (D), R43.1, U7.6 (SCL)
SE_SDA: Q7.2 (S), R48.1
SE_SDA_AO: Q7.3 (D), R44.1, U7.5 (SDA)
SYS_CLK: R32.2
VBAT_CELL: BT1.1 (+), R42.1

Notes on the sheet:
FPGA configuration, JTAG, ADC, clock
VCCIOCFG: 47u, 470n, 100n
5 V monitor: 0.45 V at VAADC
MODE[2:0] = 001: master SPI. Fit JP1 for 101: JTAG only.
JTAG: not fitted in production
HSST quad QR3: not used (UG040012 Table 5-1)
Supplies left floating, with a DNP grounding resistor each. RX and RREF grounded. TX and REFCLK open.
QSPI NOR flash: bitstreams, loader, application (untrusted storage)
FLASH_CLK_USR: optional fabric-driven clock (DNP link) if the CFG_CLK user-mode primitive is not used. IO_STATUS_C high: user I/O are high-Z during configuration.
Secure element (always-on rail, I2C stays inside the enclosure)
Nothing else on this bus.
Real-time clock: wake alarm, local time (untrusted)
2 x SR44 in series (3.1 V), primary cells: keep the RTC charge function off (CHGEN = 0). /INT is open drain and latches until cleared. FOUT and /RST are not used.
Isolation between the FPGA (switched 3V3) and the always-on domain
Gate at +3V3: with the FPGA rail off each FET is off and its body diode is reverse biased, so the always-on side stays high and nothing back-feeds the unpowered FPGA.
Notes 1. Root of trust = FPGA (eFuse key, authenticated bitstream) + QSPI flash + ATECC608C. 2. Master SPI x4 at 3.3 V: VCCIOCFG = VCCIOL5 = 3.3 V, SCBV tied to VCCIOCFG (UG040012 Table 2-1). Flash data and chip select are on bank L5 (User Banks L page); the clock is CFG_CLK. 3. VCCB (battery-backe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
