bradleyeckert/thriller/fpga/logos2/KiCAD/thriller/th_display.kicad_sch

## KiCad design fpga/logos2/KiCAD/thriller/th_display.kicad_sch (2026-11-13)

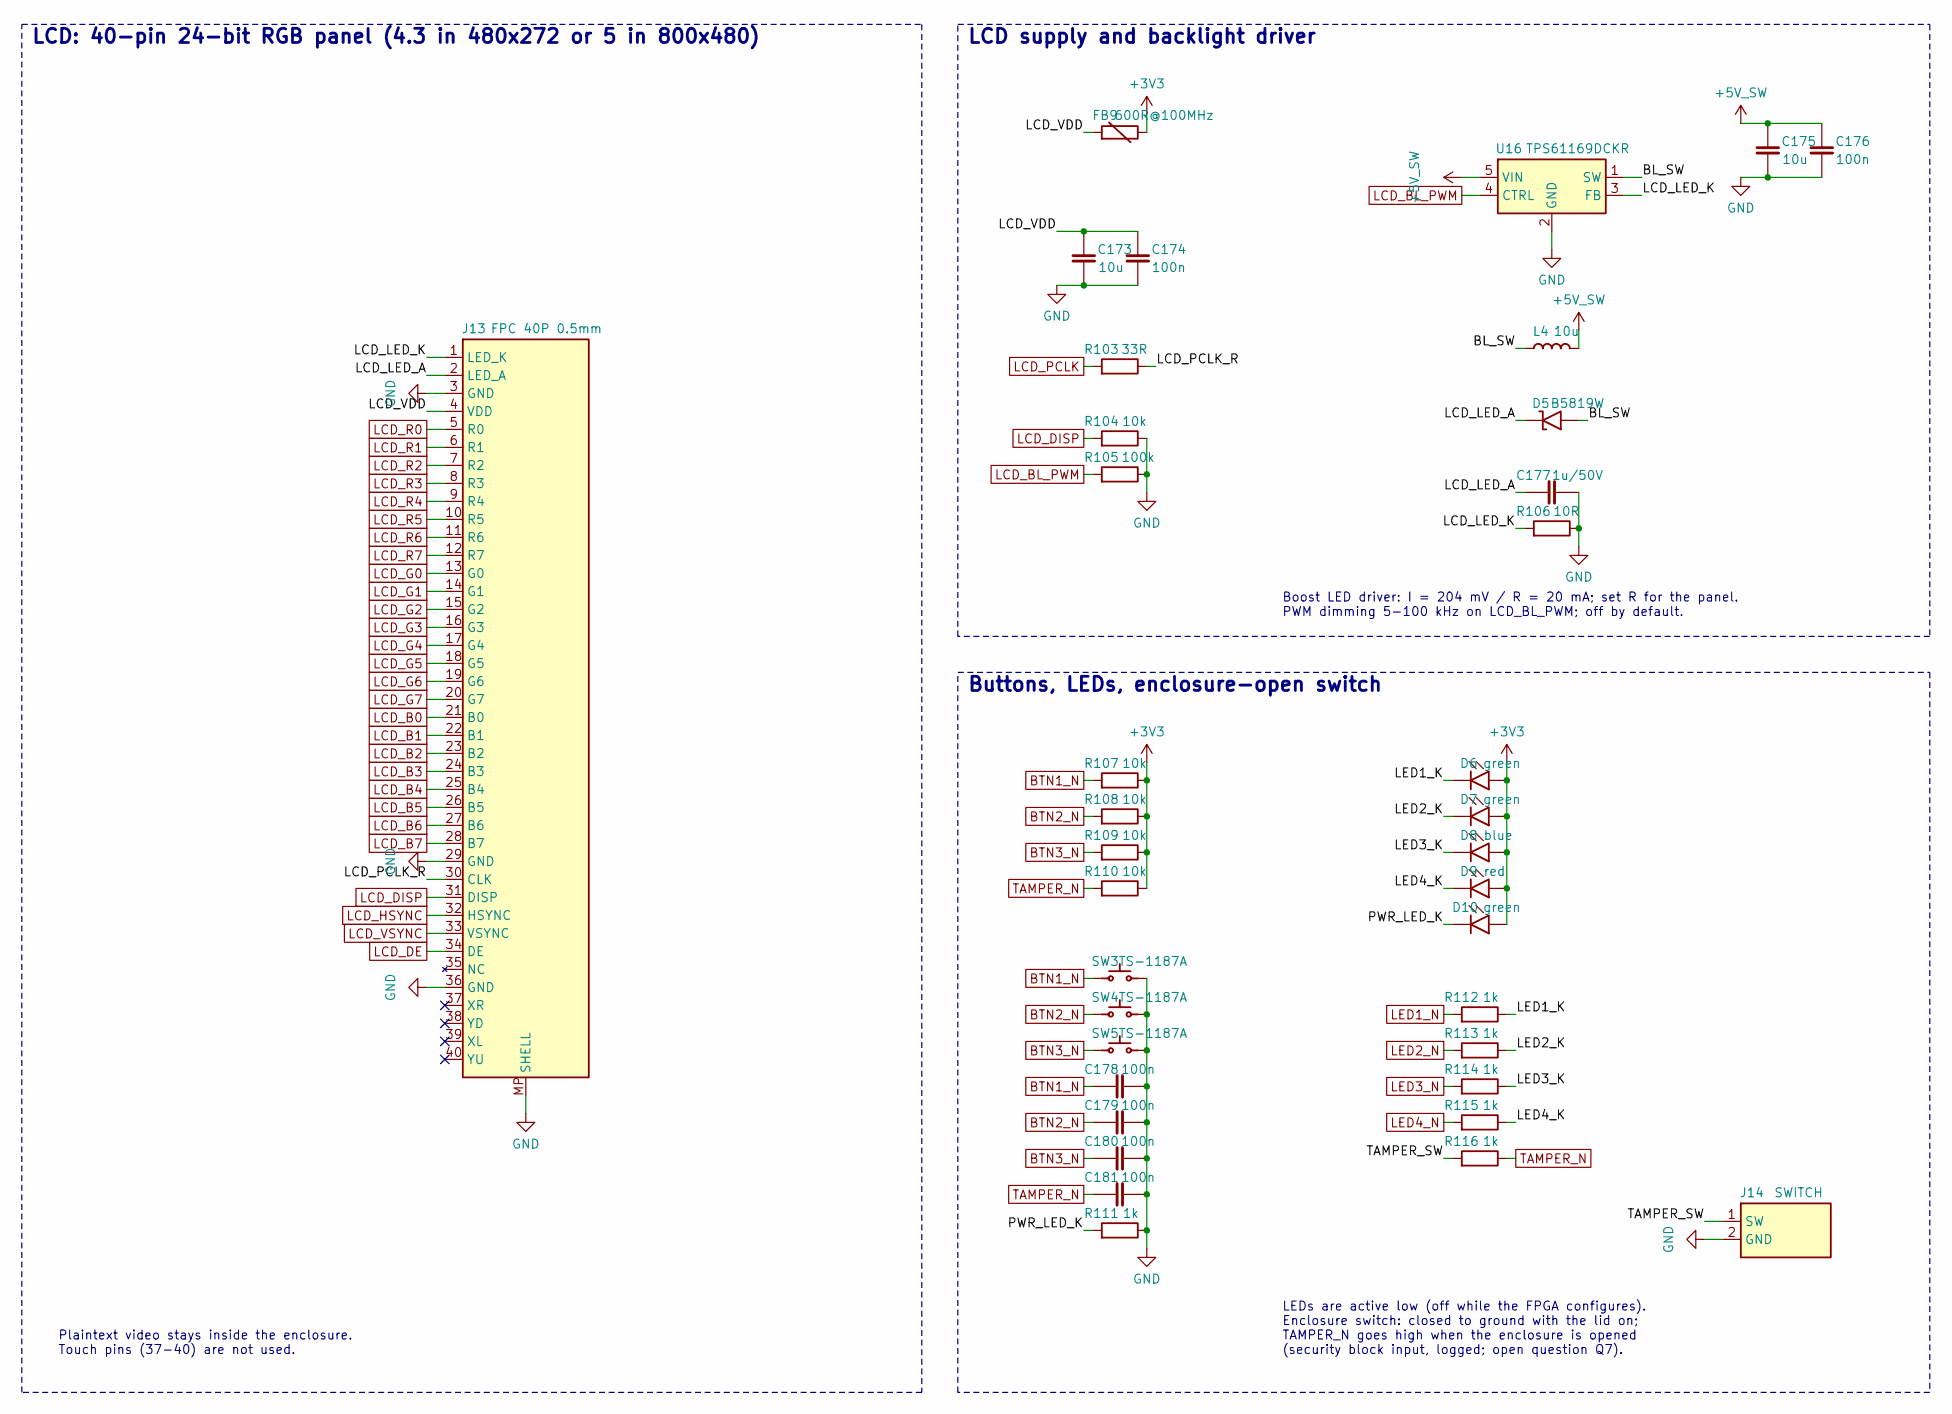
[picture p4: schematic th_display.kicad_sch]

Parts:
C173, C175: 10u; C_0603_1608Metric; LCSC C19702
C174, C176, C178, C179, C180, C181: 100n; C_0402_1005Metric; LCSC C1525
C177: 1u/50V; C_0805_2012Metric; LCSC C28323
D5: B5819W; D_SOD-123; LCSC C8598
D6, D7, D10: green; LED_0603_1608Metric; LCSC C72043
D8: blue; LED_0603_1608Metric; LCSC C72041
D9: red; LED_0603_1608Metric; LCSC C2286
FB9: 600R@100MHz; L_0603_1608Metric; MPN GZ1608D601TF; LCSC C1002
J13: FPC 40P 0.5mm; Hirose_FH12-40S-0.5SH_1x40-1MP_P0.50mm_Horizontal
J14: SWITCH; JST_PH_B2B-PH-K_1x02_P2.00mm_Vertical; MPN B2B-PH-K-S; LCSC C131337
L4: 10u; L_Sunlord_SWPA4030S; MPN SWPA4030S100MT
R103: 33R; R_0402_1005Metric; LCSC C25105
R104, R107, R108, R109, R110: 10k; R_0402_1005Metric; LCSC C25744
R105: 100k; R_0402_1005Metric; LCSC C25741
R106: 10R; R_0402_1005Metric; LCSC C25077
R111, R112, R113, R114, R115, R116: 1k; R_0402_1005Metric; LCSC C11702
SW3, SW4, SW5: TS-1187A; SW_Push_1P1T_XKB_TS-1187A; MPN TS-1187A-B-A-B; LCSC C318884
U16: TPS61169DCKR; SOT-353_SC-70-5; MPN TPS61169DCKR

Connections:
+3V3: D6.2 (A), D7.2 (A), D8.2 (A), D9.2 (A), D10.2 (A), FB9.2, R107.2, R108.2, R109.2, R110.2
+5V_SW: C175.1, C176.1, L4.2, U16.5 (VIN)
BL_SW: D5.2 (A), L4.1, U16.1 (SW)
BTN1_N: C178.1, R107.1, SW3.1
BTN2_N: C179.1, R108.1, SW4.1
BTN3_N: C180.1, R109.1, SW5.1
GND: C173.2, C174.2, C175.2, C176.2, C177.2, C178.2, C179.2, C180.2, C181.2, J13.3 (GND), J13.29 (GND), J13.36 (GND), J13.MP (SHELL), J14.2 (GND), R104.2, R105.2, R106.2, R111.2, SW3.2, SW4.2, SW5.2, U16.2 (GND)
LCD_B0: J13.21 (B0)
LCD_B1: J13.22 (B1)
LCD_B2: J13.23 (B2)
LCD_B3: J13.24 (B3)
LCD_B4: J13.25 (B4)
LCD_B5: J13.26 (B5)
LCD_B6: J13.27 (B6)
LCD_B7: J13.28 (B7)
LCD_BL_PWM: R105.1, U16.4 (CTRL)
LCD_DE: J13.34 (DE)
LCD_DISP: J13.31 (DISP), R104.1
LCD_G0: J13.13 (G0)
LCD_G1: J13.14 (G1)
LCD_G2: J13.15 (G2)
LCD_G3: J13.16 (G3)
LCD_G4: J13.17 (G4)
LCD_G5: J13.18 (G5)
LCD_G6: J13.19 (G6)
LCD_G7: J13.20 (G7)
LCD_HSYNC: J13.32 (HSYNC)
LCD_LED_A: C177.1, D5.1 (K), J13.2 (LED_A)
LCD_LED_K: J13.1 (LED_K), R106.1, U16.3 (FB)
LCD_PCLK: R103.1
LCD_PCLK_R: J13.30 (CLK), R103.2
LCD_R0: J13.5 (R0)
LCD_R1: J13.6 (R1)
LCD_R2: J13.7 (R2)
LCD_R3: J13.8 (R3)
LCD_R4: J13.9 (R4)
LCD_R5: J13.10 (R5)
LCD_R6: J13.11 (R6)
LCD_R7: J13.12 (R7)
LCD_VDD: C173.1, C174.1, FB9.1, J13.4 (VDD)
LCD_VSYNC: J13.33 (VSYNC)
LED1_K: D6.1 (K), R112.2
LED1_N: R112.1
LED2_K: D7.1 (K), R113.2
LED2_N: R113.1
LED3_K: D8.1 (K), R114.2
LED3_N: R114.1
LED4_K: D9.1 (K), R115.2
LED4_N: R115.1
PWR_LED_K: D10.1 (K), R111.1
TAMPER_N: C181.1, R110.1, R116.2
TAMPER_SW: J14.1 (SW), R116.1

Notes on the sheet:
LCD: 40-pin 24-bit RGB panel (4.3 in 480x272 or 5 in 800x480)
Plaintext video stays inside the enclosure. Touch pins (37-40) are not used.
LCD supply and backlight driver
Boost LED driver: I = 204 mV / R = 20 mA; set R for the panel. PWM dimming 5-100 kHz on LCD_BL_PWM; off by default.
Buttons, LEDs, enclosure-open switch
LEDs are active low (off while the FPGA configures). Enclosure switch: closed to ground with the lid on; TAMPER_N goes high when the enclosure is opened (security block input, logged; open question Q7).
