bradleyeckert/thriller/fpga/logos2/KiCAD/thriller/th_ext.kicad_sch

## KiCad design fpga/logos2/KiCAD/thriller/th_ext.kicad_sch (2026-11-13)

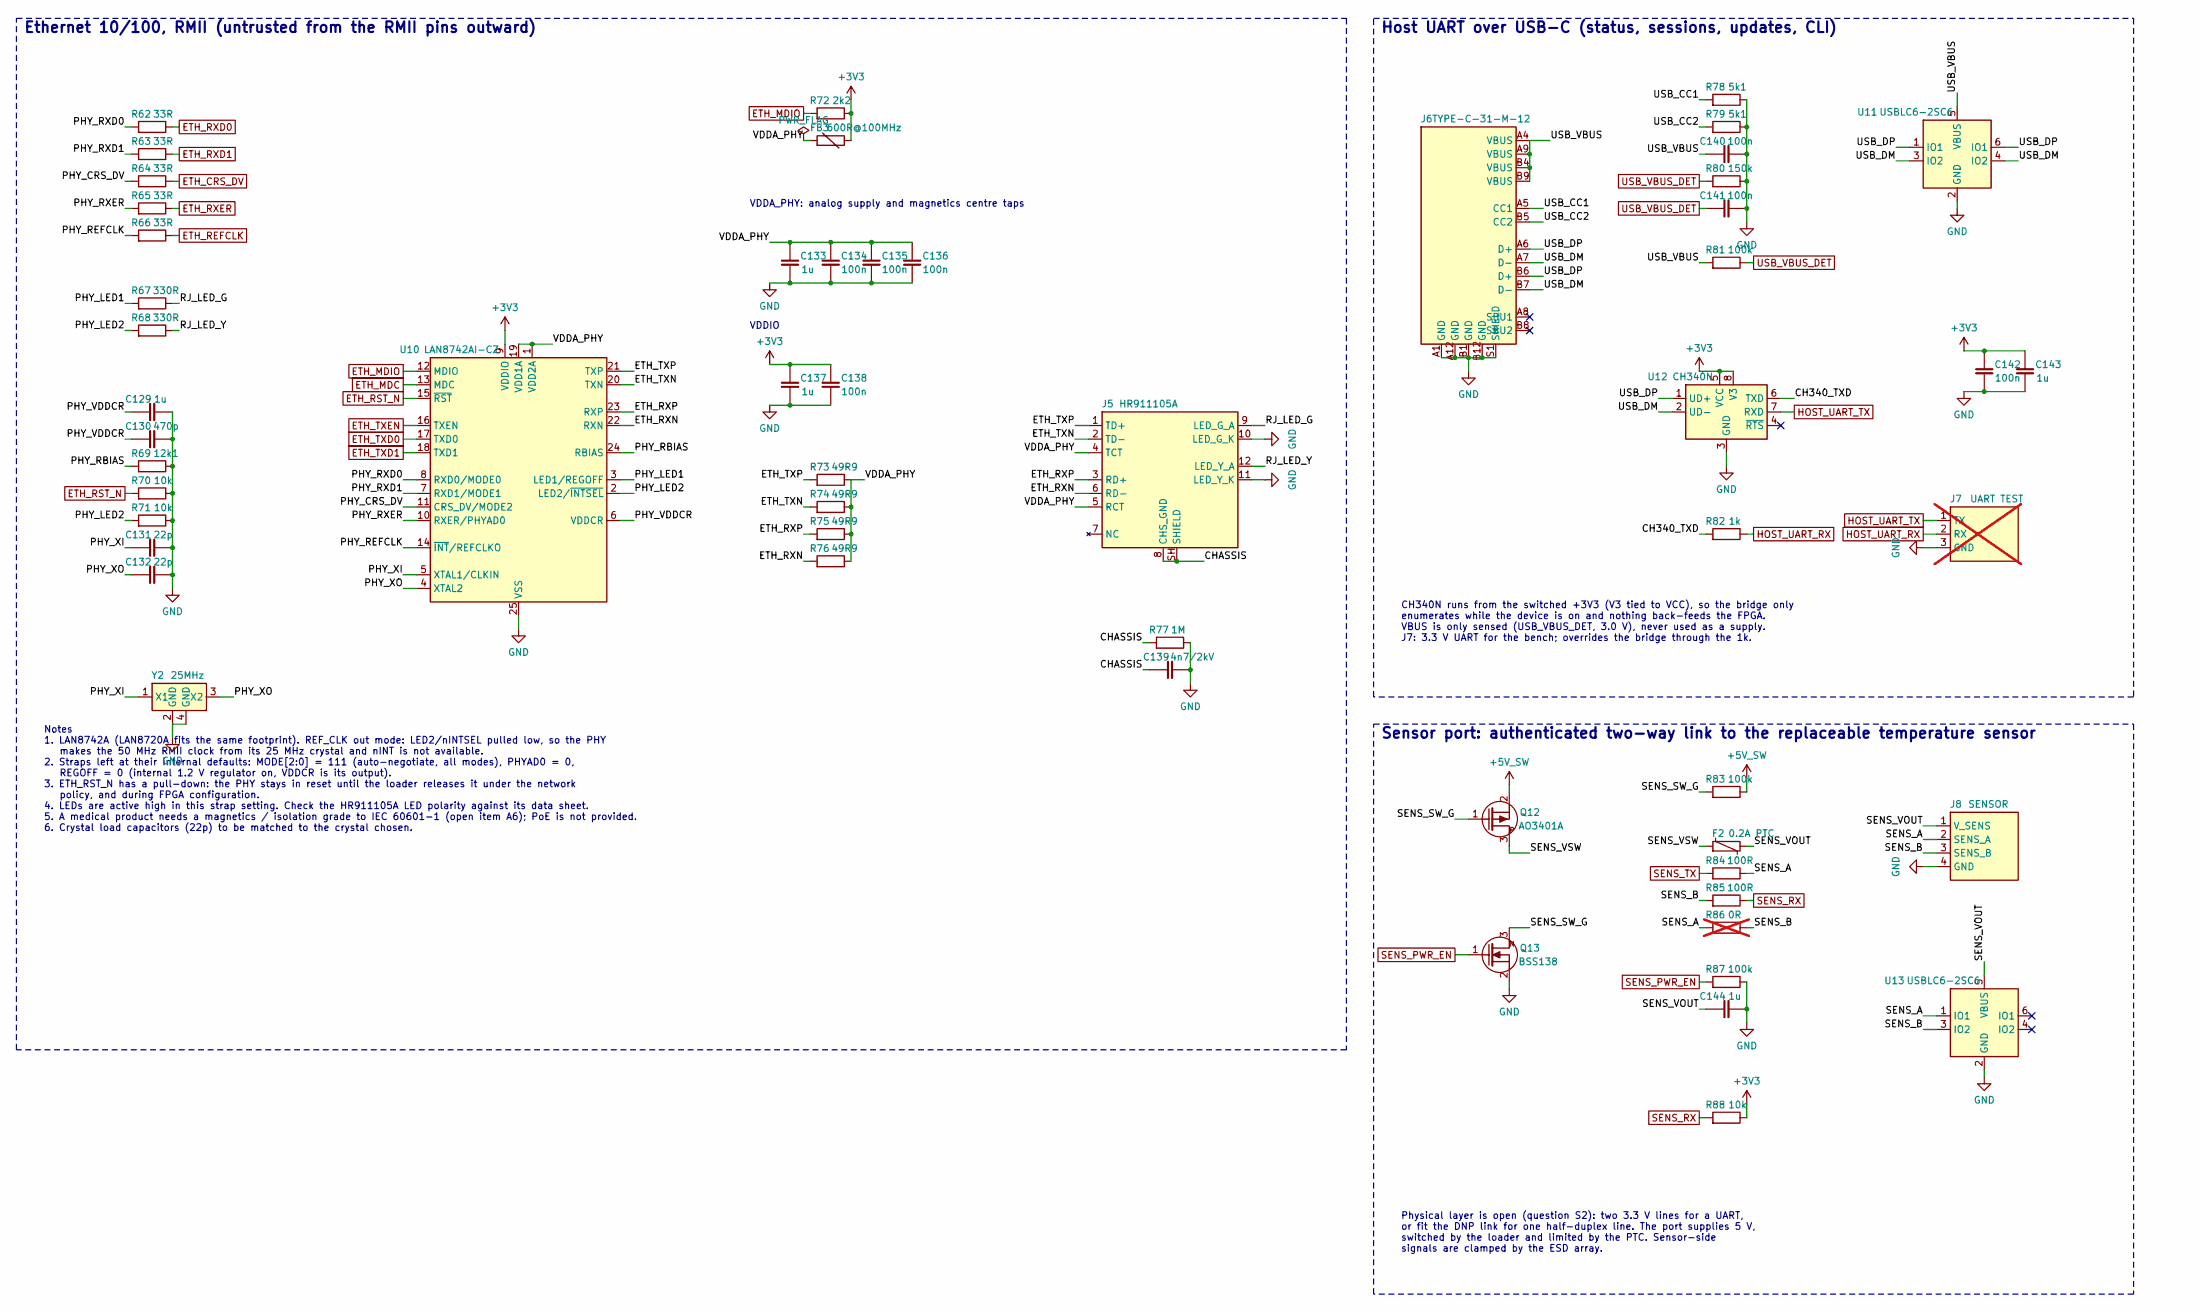
[picture p5: schematic th_ext.kicad_sch]

Parts:
C129, C133, C137, C143, C144: 1u; C_0402_1005Metric; LCSC C52923
C130: 470p; C_0402_1005Metric
C131, C132: 22p; C_0402_1005Metric; LCSC C1555
C134, C135, C136, C138, C140, C141, C142: 100n; C_0402_1005Metric; LCSC C1525
C139: 4n7/2kV; C_1206_3216Metric
F2: 0.2A PTC; Fuse_0805_2012Metric
FB3: 600R@100MHz; L_0603_1608Metric; MPN GZ1608D601TF; LCSC C1002
J5: HR911105A; RJ45_Hanrun_HR911105A_Horizontal; MPN HR911105A; LCSC C12074
J6: TYPE-C-31-M-12; USB_C_Receptacle_HRO_TYPE-C-31-M-12; MPN TYPE-C-31-M-12; LCSC C165948
J7: UART TEST; PinHeader_1x03_P2.54mm_Vertical; not fitted
J8: SENSOR; JST_PH_B4B-PH-K_1x04_P2.00mm_Vertical; MPN B4B-PH-K-S
Q12: AO3401A; SOT-23; MPN AO3401A; LCSC C15127
Q13: BSS138; SOT-23; MPN BSS138
R62, R63, R64, R65, R66: 33R; R_0402_1005Metric; LCSC C25105
R67, R68: 330R; R_0402_1005Metric; LCSC C25104
R69: 12k1; R_0402_1005Metric
R70, R71, R88: 10k; R_0402_1005Metric; LCSC C25744
R72: 2k2; R_0402_1005Metric; LCSC C25879
R73, R74, R75, R76: 49R9; R_0402_1005Metric; LCSC C25120
R77: 1M; R_0402_1005Metric; LCSC C26083
R78, R79: 5k1; R_0402_1005Metric; LCSC C25905
R80: 150k; R_0402_1005Metric
R81, R83, R87: 100k; R_0402_1005Metric; LCSC C25741
R82: 1k; R_0402_1005Metric; LCSC C11702
R84, R85: 100R; R_0402_1005Metric; LCSC C25076
R86: 0R; R_0402_1005Metric; LCSC C17168; not fitted
U10: LAN8742AI-CZ; QFN-24-1EP_4x4mm_P0.5mm_EP2.6x2.6mm; MPN LAN8742AI-CZ-TR; LCSC C621425
U11, U13: USBLC6-2SC6; SOT-23-6; MPN USBLC6-2SC6; LCSC C7519
U12: CH340N; SOIC-8_3.9x4.9mm_P1.27mm; MPN CH340N; LCSC C2977777
Y2: 25MHz; Crystal_SMD_3225-4Pin_3.2x2.5mm; MPN X322525MOB4SI; LCSC C9006

Connections:
+3V3: C137.1, C138.1, C142.1, C143.1, FB3.2, R72.2, R88.2, U10.9 (VDDIO), U12.5 (VCC), U12.8 (V3)
+5V_SW: Q12.2 (S), R83.2
CH340_TXD: R82.1, U12.6 (TXD)
CHASSIS: C139.1, J5.8 (CHS_GND), J5.SH (SHIELD), R77.1
ETH_CRS_DV: R64.2
ETH_MDC: U10.13 (MDC)
ETH_MDIO: R72.1, U10.12 (MDIO)
ETH_REFCLK: R66.2
ETH_RST_N: R70.1, U10.15 (~RST)
ETH_RXD0: R62.2
ETH_RXD1: R63.2
ETH_RXER: R65.2
ETH_RXN: J5.6 (RD-), R76.1, U10.22 (RXN)
ETH_RXP: J5.3 (RD+), R75.1, U10.23 (RXP)
ETH_TXD0: U10.17 (TXD0)
ETH_TXD1: U10.18 (TXD1)
ETH_TXEN: U10.16 (TXEN)
ETH_TXN: J5.2 (TD-), R74.1, U10.20 (TXN)
ETH_TXP: J5.1 (TD+), R73.1, U10.21 (TXP)
GND: C129.2, C130.2, C131.2, C132.2, C133.2, C134.2, C135.2, C136.2, C137.2, C138.2, C139.2, C140.2, C141.2, C142.2, C143.2, C144.2, J5.10 (LED_G_K), J5.11 (LED_Y_K), J6.A1 (GND), J6.A12 (GND), J6.B1 (GND), J6.B12 (GND), J6.S1 (SHIELD), J7.3 (GND), J8.4 (GND), Q13.2 (S), R69.2, R70.2, R71.2, R77.2, R78.2, R79.2, R80.2, R87.2, U10.25 (VSS), U11.2 (GND), U12.3 (GND), U13.2 (GND), Y2.2 (GND), Y2.4 (GND)
HOST_UART_RX: J7.2 (RX), R82.2
HOST_UART_TX: J7.1 (TX), U12.7 (RXD)
PHY_CRS_DV: R64.1, U10.11 (CRS_DV/MODE2)
PHY_LED1: R67.1, U10.3 (LED1/REGOFF)
PHY_LED2: R68.1, R71.1, U10.2 (LED2/~INTSEL)
PHY_RBIAS: R69.1, U10.24 (RBIAS)
PHY_REFCLK: R66.1, U10.14 (~INT/REFCLKO)
PHY_RXD0: R62.1, U10.8 (RXD0/MODE0)
PHY_RXD1: R63.1, U10.7 (RXD1/MODE1)
PHY_RXER: R65.1, U10.10 (RXER/PHYAD0)
PHY_VDDCR: C129.1, C130.1, U10.6 (VDDCR)
PHY_XI: C131.1, U10.5 (XTAL1/CLKIN), Y2.1 (X1)
PHY_XO: C132.1, U10.4 (XTAL2), Y2.3 (X2)
PWR_FLAG: C133.1, C134.1, C135.1, C136.1, FB3.1, J5.4 (TCT), J5.5 (RCT), R73.2, R74.2, R75.2, R76.2, U10.1 (VDD2A), U10.19 (VDD1A)
RJ_LED_G: J5.9 (LED_G_A), R67.2
RJ_LED_Y: J5.12 (LED_Y_A), R68.2
SENS_A: J8.2 (SENS_A), R84.2, R86.1, U13.1 (IO1)
SENS_B: J8.3 (SENS_B), R85.1, R86.2, U13.3 (IO2)
SENS_PWR_EN: Q13.1 (G), R87.1
SENS_RX: R85.2, R88.1
SENS_SW_G: Q12.1 (G), Q13.3 (D), R83.1
SENS_TX: R84.1
SENS_VOUT: C144.1, F2.2, J8.1 (V_SENS), U13.5 (VBUS)
SENS_VSW: F2.1, Q12.3 (D)
USB_CC1: J6.A5 (CC1), R78.1
USB_CC2: J6.B5 (CC2), R79.1
USB_DM: J6.A7 (D-), J6.B7 (D-), U11.3 (IO2), U11.4 (IO2), U12.2 (UD-)
USB_DP: J6.A6 (D+), J6.B6 (D+), U11.1 (IO1), U11.6 (IO1), U12.1 (UD+)
USB_VBUS: C140.1, J6.A4 (VBUS), J6.A9 (VBUS), J6.B4 (VBUS), J6.B9 (VBUS), R81.1, U11.5 (VBUS)
USB_VBUS_DET: C141.1, R80.1, R81.2

Notes on the sheet:
Ethernet 10/100, RMII (untrusted from the RMII pins outward)
VDDA_PHY: analog supply and magnetics centre taps
VDDIO
Notes 1. LAN8742A (LAN8720A fits the same footprint). REF_CLK out mode: LED2/nINTSEL pulled low, so the PHY makes the 50 MHz RMII clock from its 25 MHz crystal and nINT is not available. 2. Straps left at their internal defaults: MODE[2:0] = 111 (auto-negotiate, all modes), PHYAD0 = 0, REGOFF = 0 (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
Host UART over USB-C (status, sessions, updates, CLI)
CH340N runs from the switched +3V3 (V3 tied to VCC), so the bridge only enumerates while the device is on and nothing back-feeds the FPGA. VBUS is only sensed (USB_VBUS_DET, 3.0 V), never used as a supply. J7: 3.3 V UART for the bench; overrides the bridge through the 1k.
Sensor port: authenticated two-way link to the replaceable temperature sensor
Physical layer is open (question S2): two 3.3 V lines for a UART, or fit the DNP link for one half-duplex line. The port supplies 5 V, switched by the loader and limited by the PTC. Sensor-side signals are clamped by the ESD array.
