bradleyeckert/thriller/fpga/logos2/KiCAD/thriller/th_power.kicad_sch

## KiCad design fpga/logos2/KiCAD/thriller/th_power.kicad_sch (2026-11-13)

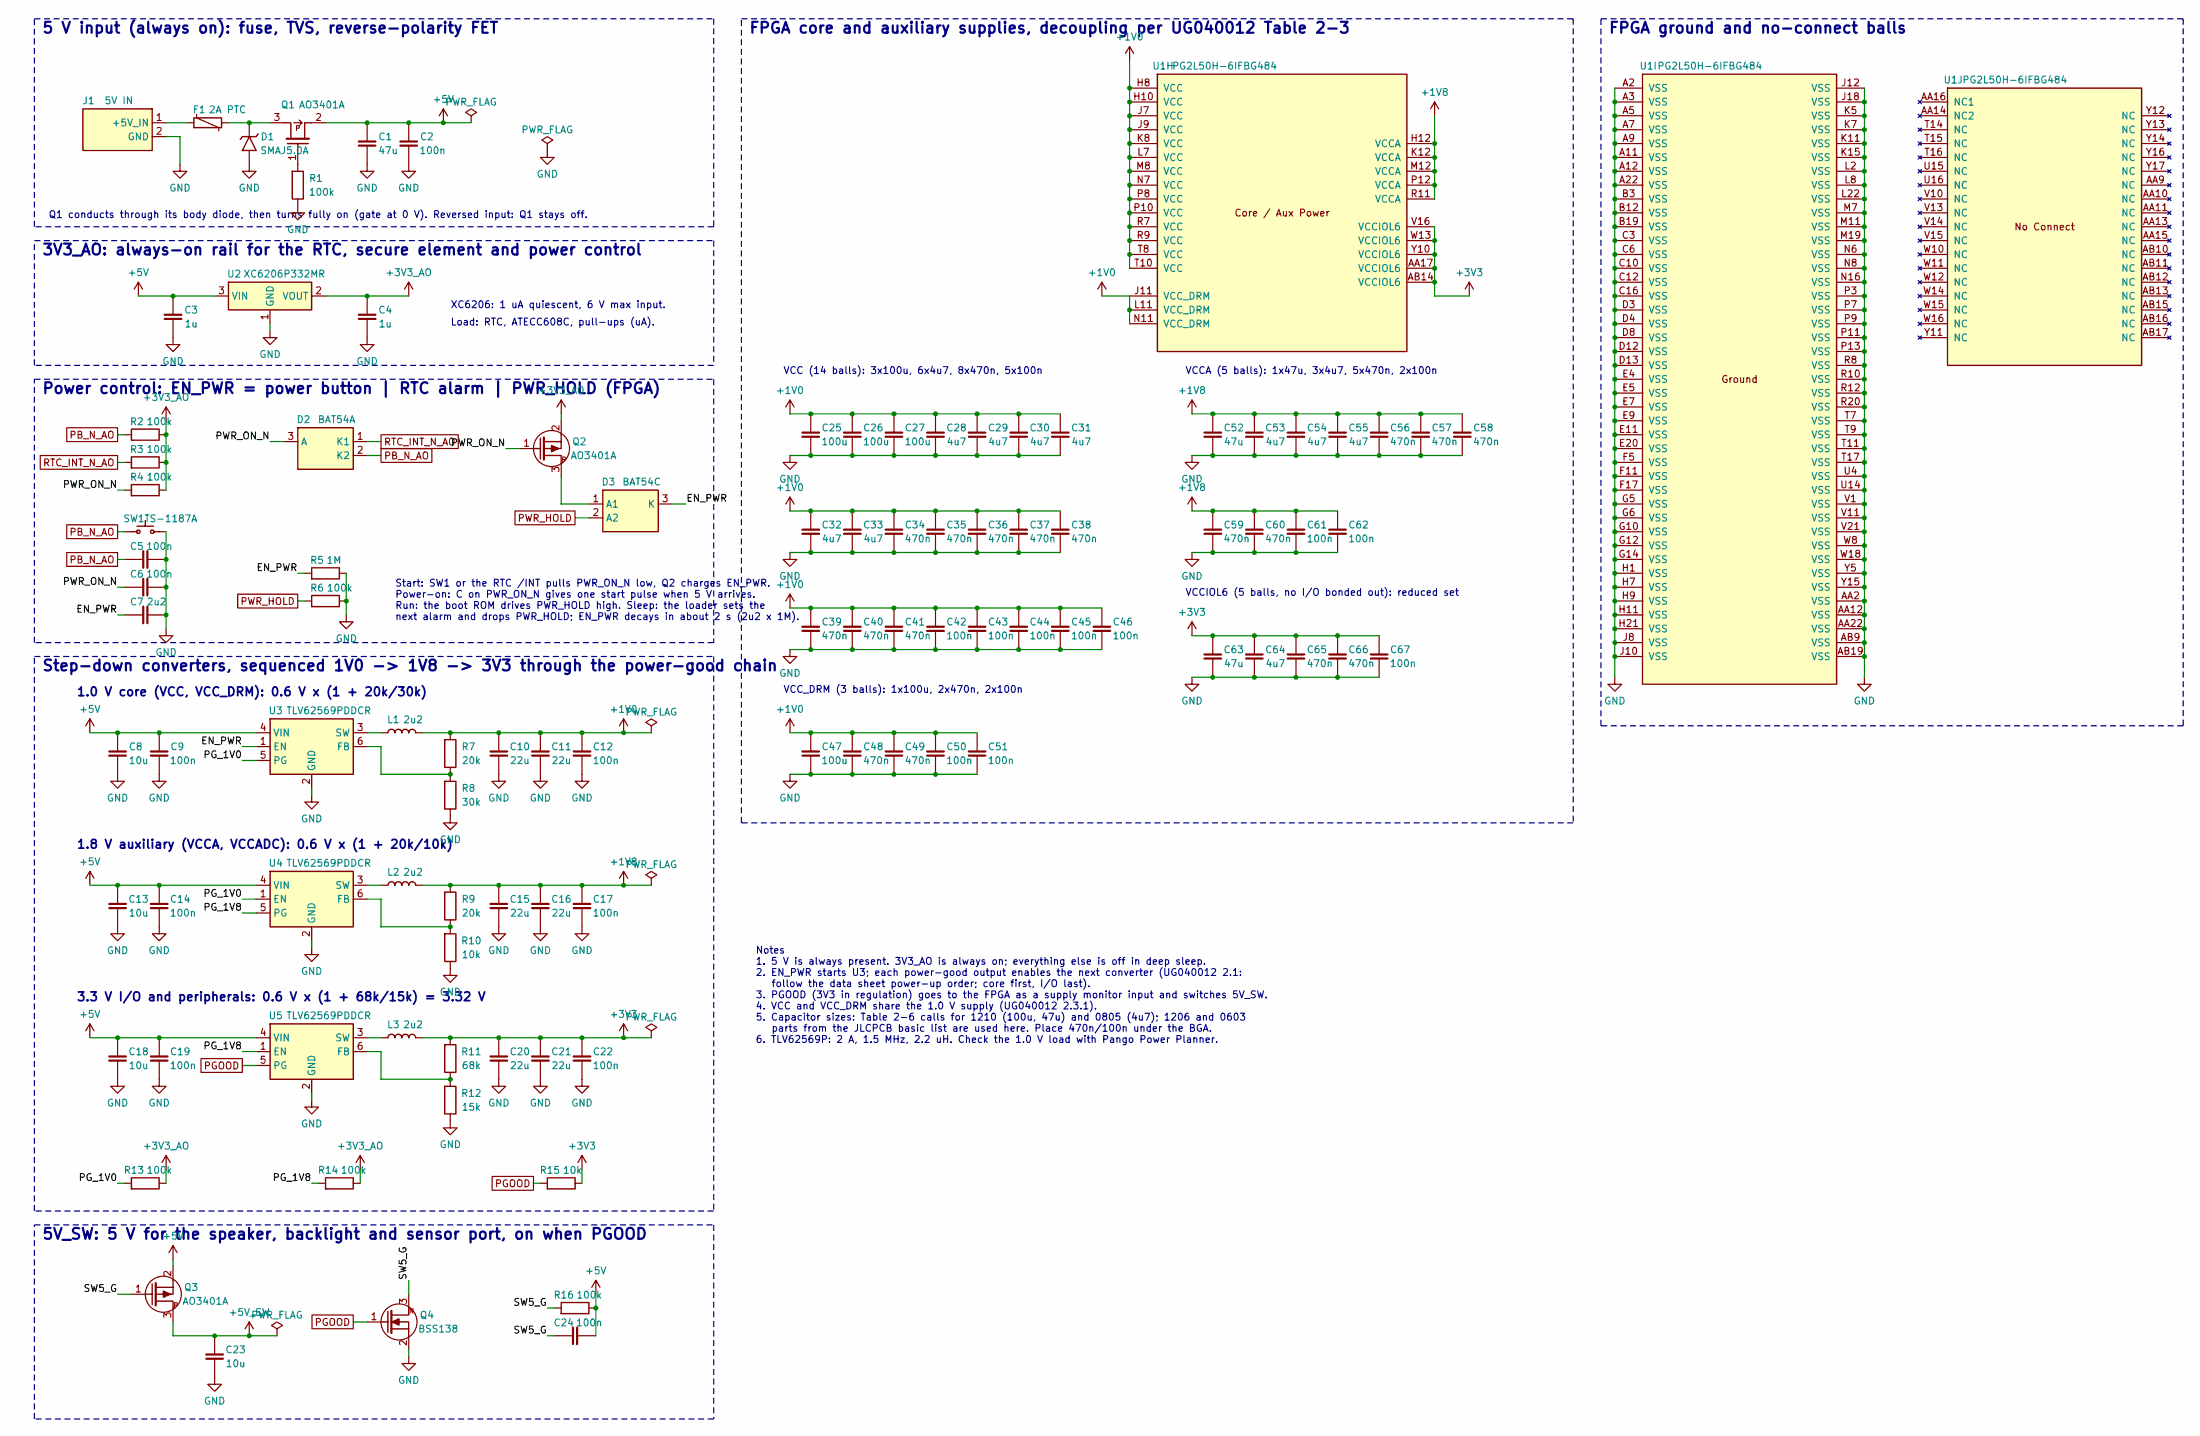
[picture p6: schematic th_power.kicad_sch]

Parts:
C1, C52, C63: 47u; C_1206_3216Metric; LCSC C96123
C2, C5, C6, C9, C12, C14, C17, C19, C22, C24, C42, C43, C44, C45, C46, C50, C51, C61, C62, C67: 100n; C_0402_1005Metric; LCSC C1525
C3, C4: 1u; C_0402_1005Metric; LCSC C52923
C7: 2u2; C_0402_1005Metric; LCSC C12530
C8, C13, C18, C23: 10u; C_0603_1608Metric; LCSC C19702
C10, C11, C15, C16, C20, C21: 22u; C_0805_2012Metric; LCSC C45783
C25, C26, C27, C47: 100u; C_1206_3216Metric; LCSC C15008
C28, C29, C30, C31, C32, C33, C53, C54, C55, C64: 4u7; C_0603_1608Metric; LCSC C19666
C34, C35, C36, C37, C38, C39, C40, C41, C48, C49, C56, C57, C58, C59, C60, C65, C66: 470n; C_0402_1005Metric
D1: SMAJ5.0A; D_SMA; MPN SMAJ5.0A
D2: BAT54A; SOT-23; MPN BAT54A
D3: BAT54C; SOT-23; MPN BAT54C
F1: 2A PTC; Fuse_1812_4532Metric
J1: 5V IN; TerminalBlock_Phoenix_MKDS-1,5-2-5.08_1x02_P5.08mm_Horizont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
L1, L2, L3: 2u2; L_Sunlord_SWPA4030S; MPN SWPA4030S2R2MT
Q1, Q2, Q3: AO3401A; SOT-23; MPN AO3401A; LCSC C15127
Q4: BSS138; SOT-23; MPN BSS138
R1, R2, R3, R4, R6, R13, R14, R16: 100k; R_0402_1005Metric; LCSC C25741
R5: 1M; R_0402_1005Metric; LCSC C26083
R7, R9: 20k; R_0402_1005Metric; LCSC C25765
R8: 30k; R_0402_1005Metric
R10, R15: 10k; R_0402_1005Metric; LCSC C25744
R11: 68k; R_0402_1005Metric
R12: 15k; R_0402_1005Metric; LCSC C25756
SW1: TS-1187A; SW_Push_1P1T_XKB_TS-1187A; MPN TS-1187A-B-A-B; LCSC C318884
U1: PG2L50H-6IFBG484; BGA-484_23.0x23.0mm_Layout22x22_P1.0mm
U2: XC6206P332MR; SOT-23; MPN XC6206P332MR; LCSC C5446
U3, U4, U5: TLV62569PDDCR; TSOT-23-6; MPN TLV62569PDDCR; LCSC C398365

Connections:
+1V0: C1.1, C1.2, C2.1, C2.2, C3.1, C3.2, C4.2, C5.2, C6.2, C7.2, C8.1, C8.2, C9.1, C9.2, C10.1, C10.2, C11.1, C11.2, C12.1, C12.2, C13.1, C13.2, C14.1, C14.2, C15.1, C15.2, C16.1, C16.2, C17.1, C17.2, C18.1, C18.2, C19.1, C19.2, C20.1, C20.2, C21.1, C21.2, C22.1, C22.2, C23.1, C23.2, C24.2, C25.1, C25.2, C26.1, C26.2, C27.1, C27.2, C28.1, C28.2, C29.1, C29.2, C30.1, C30.2, C31.1, C31.2, C32.1, C32.2, C33.1, C33.2, C34.1, C34.2, C35.1, C35.2, C36.1, C36.2, C37.1, C37.2, C38.1, C38.2, C39.1, C39.2, C40.1, C40.2, C41.1, C41.2, C42.1, C42.2, C43.1, C43.2, C44.1, C44.2, C45.1, C45.2, C46.1, C46.2, C47.1, C47.2, C48.1, C48.2, C49.1, C49.2, C50.1, C50.2, C51.1, C51.2, C52.1, C52.2, C53.1, C53.2, C54.1, C54.2, C55.1, C55.2, C56.1, C56.2, C57.1, C57.2, C58.1, C58.2, C59.1, C59.2, C60.1, C60.2, C61.1, C61.2, C62.1, C62.2, C63.1, C63.2, C64.1, C64.2, C65.1, C65.2, C66.1, C66.2, C67.1, C67.2, D1.2 (A), J1.2 (GND), L1.2, L2.2, L3.2, Q1.2 (S), Q3.2 (S), Q3.3 (D), Q4.2 (S), R1.2, R5.2, R6.2, R7.1, R8.2, R9.1, R10.2, R11.1, R12.2, R15.2, R16.2, SW1.2, U1.A2 (VSS), U1.A3 (VSS), U1.A5 (VSS), U1.A7 (VSS), U1.A9 (VSS), U1.A11 (VSS), U1.A12 (VSS), U1.A22 (VSS), U1.AA2 (VSS), U1.AA12 (VSS), U1.AA17 (VCCIOL6), U1.AA22 (VSS), U1.AB9 (VSS), U1.AB14 (VCCIOL6), U1.AB19 (VSS), U1.B3 (VSS), U1.B12 (VSS), U1.B19 (VSS), U1.C3 (VSS), U1.C6 (VSS), U1.C10 (VSS), U1.C12 (VSS), U1.C16 (VSS), U1.D3 (VSS), U1.D4 (VSS), U1.D8 (VSS), U1.D12 (VSS), U1.D13 (VSS), U1.E4 (VSS), U1.E5 (VSS), U1.E7 (VSS), U1.E9 (VSS), U1.E11 (VSS), U1.E20 (VSS), U1.F5 (VSS), U1.F11 (VSS), U1.F17 (VSS), U1.G5 (VSS), U1.G6 (VSS), U1.G10 (VSS), U1.G12 (VSS), U1.G14 (VSS), U1.H1 (VSS), U1.H7 (VSS), U1.H8 (VCC), U1.H9 (VSS), U1.H10 (VCC), U1.H11 (VSS), U1.H12 (VCCA), U1.H21 (VSS), U1.J7 (VCC), U1.J8 (VSS), U1.J9 (VCC), U1.J10 (VSS), U1.J11 (VCC_DRM), U1.J12 (VSS), U1.J18 (VSS), U1.K5 (VSS), U1.K7 (VSS), U1.K8 (VCC), U1.K11 (VSS), U1.K12 (VCCA), U1.K15 (VSS), U1.L2 (VSS), U1.L7 (VCC), U1.L8 (VSS), U1.L11 (VCC_DRM), U1.L22 (VSS), U1.M7 (VSS), U1.M8 (VCC), U1.M11 (VSS), U1.M12 (VCCA), U1.M19 (VSS), U1.N6 (VSS), U1.N7 (VCC), U1.N8 (VSS), U1.N11 (VCC_DRM), U1.N16 (VSS), U1.P3 (VSS), U1.P7 (VSS), U1.P8 (VCC), U1.P9 (VSS), U1.P10 (VCC), U1.P11 (VSS), U1.P12 (VCCA), U1.P13 (VSS), U1.R7 (VCC), U1.R8 (VSS), U1.R9 (VCC), U1.R10 (VSS), U1.R11 (VCCA), U1.R12 (VSS), U1.R20 (VSS), U1.T7 (VSS), U1.T8 (VCC), U1.T9 (VSS), U1.T10 (VCC), U1.T11 (VSS), U1.T17 (VSS), U1.U4 (VSS), U1.U14 (VSS), U1.V1 (VSS), U1.V11 (VSS), U1.V16 (VCCIOL6), U1.V21 (VSS), U1.W8 (VSS), U1.W13 (VCCIOL6), U1.W18 (VSS), U1.Y5 (VSS), U1.Y10 (VCCIOL6), U1.Y15 (VSS), U2.1 (GND), U2.3 (VIN), U3.2 (GND), U3.4 (VIN), U4.2 (GND), U4.4 (VIN), U5.2 (GND), U5.4 (VIN)
+3V3_AO: C4.1, Q2.2 (S), R2.2, R3.2, R4.2, R13.2, R14.2, U2.2 (VOUT)
EN_PWR: C7.1, D3.3 (K), R5.1, U3.1 (EN)
unnamed: D1.1 (K), F1.2, Q1.3 (D)
unnamed: D3.1 (A1), Q2.3 (D)
unnamed: F1.1, J1.1 (+5V_IN)
unnamed: L1.1, U3.3 (SW)
unnamed: L2.1, U4.3 (SW)
unnamed: L3.1, U5.3 (SW)
unnamed: Q1.1 (G), R1.1
unnamed: R7.2, R8.1, U3.6 (FB)
unnamed: R9.2, R10.1, U4.6 (FB)
unnamed: R11.2, R12.1, U5.6 (FB)
PB_N_AO: C5.1, D2.2 (K2), R2.1, SW1.1
PGOOD: Q4.1 (G), R15.1, U5.5 (PG)
PG_1V0: R13.1, U3.5 (PG), U4.1 (EN)
PG_1V8: R14.1, U4.5 (PG), U5.1 (EN)
PWR_HOLD: D3.2 (A2), R6.1
PWR_ON_N: C6.1, D2.3 (A), Q2.1 (G), R4.1
RTC_INT_N_AO: D2.1 (K1), R3.1
SW5_G: C24.1, Q3.1 (G), Q4.3 (D), R16.1

Notes on the sheet:
5 V input (always on): fuse, TVS, reverse-polarity FET
Q1 conducts through its body diode, then turns fully on (gate at 0 V). Reversed input: Q1 stays off.
3V3_AO: always-on rail for the RTC, secure element and power control
XC6206: 1 uA quiescent, 6 V max input.
Load: RTC, ATECC608C, pull-ups (uA).
Power control: EN_PWR = power button | RTC alarm | PWR_HOLD (FPGA)
Start: SW1 or the RTC /INT pulls PWR_ON_N low, Q2 charges EN_PWR. Power-on: C on PWR_ON_N gives one start pulse when 5 V arrives. Run: the boot ROM drives PWR_HOLD high. Sleep: the loader sets the next alarm and drops PWR_HOLD; EN_PWR decays in about 2 s (2u2 x 1M).
Step-down converters, sequenced 1V0 -> 1V8 -> 3V3 through the power-good chain
1.0 V core (VCC, VCC_DRM): 0.6 V x (1 + 20k/30k)
1.8 V auxiliary (VCCA, VCCADC): 0.6 V x (1 + 20k/10k)
3.3 V I/O and peripherals: 0.6 V x (1 + 68k/15k) = 3.32 V
5V_SW: 5 V for the speaker, backlight and sensor port, on when PGOOD
FPGA core and auxiliary supplies, decoupling per UG040012 Table 2-3
VCC (14 balls): 3x100u, 6x4u7, 8x470n, 5x100n
VCC_DRM (3 balls): 1x100u, 2x470n, 2x100n
VCCA (5 balls): 1x47u, 3x4u7, 5x470n, 2x100n
VCCIOL6 (5 balls, no I/O bonded out): reduced set
FPGA ground and no-connect balls
Notes 1. 5 V is always present. 3V3_AO is always on; everything else is off in deep sleep. 2. EN_PWR starts U3; each power-good output enables the next converter (UG040012 2.1: follow the data sheet power-up order; core first, I/O last). 3. PGOOD (3V3 in regulation) goes to the FPGA as a supply mon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
