bradleyeckert/thriller/fpga/logos2/KiCAD/thriller/th_storage.kicad_sch

## KiCad design fpga/logos2/KiCAD/thriller/th_storage.kicad_sch (2026-11-13)

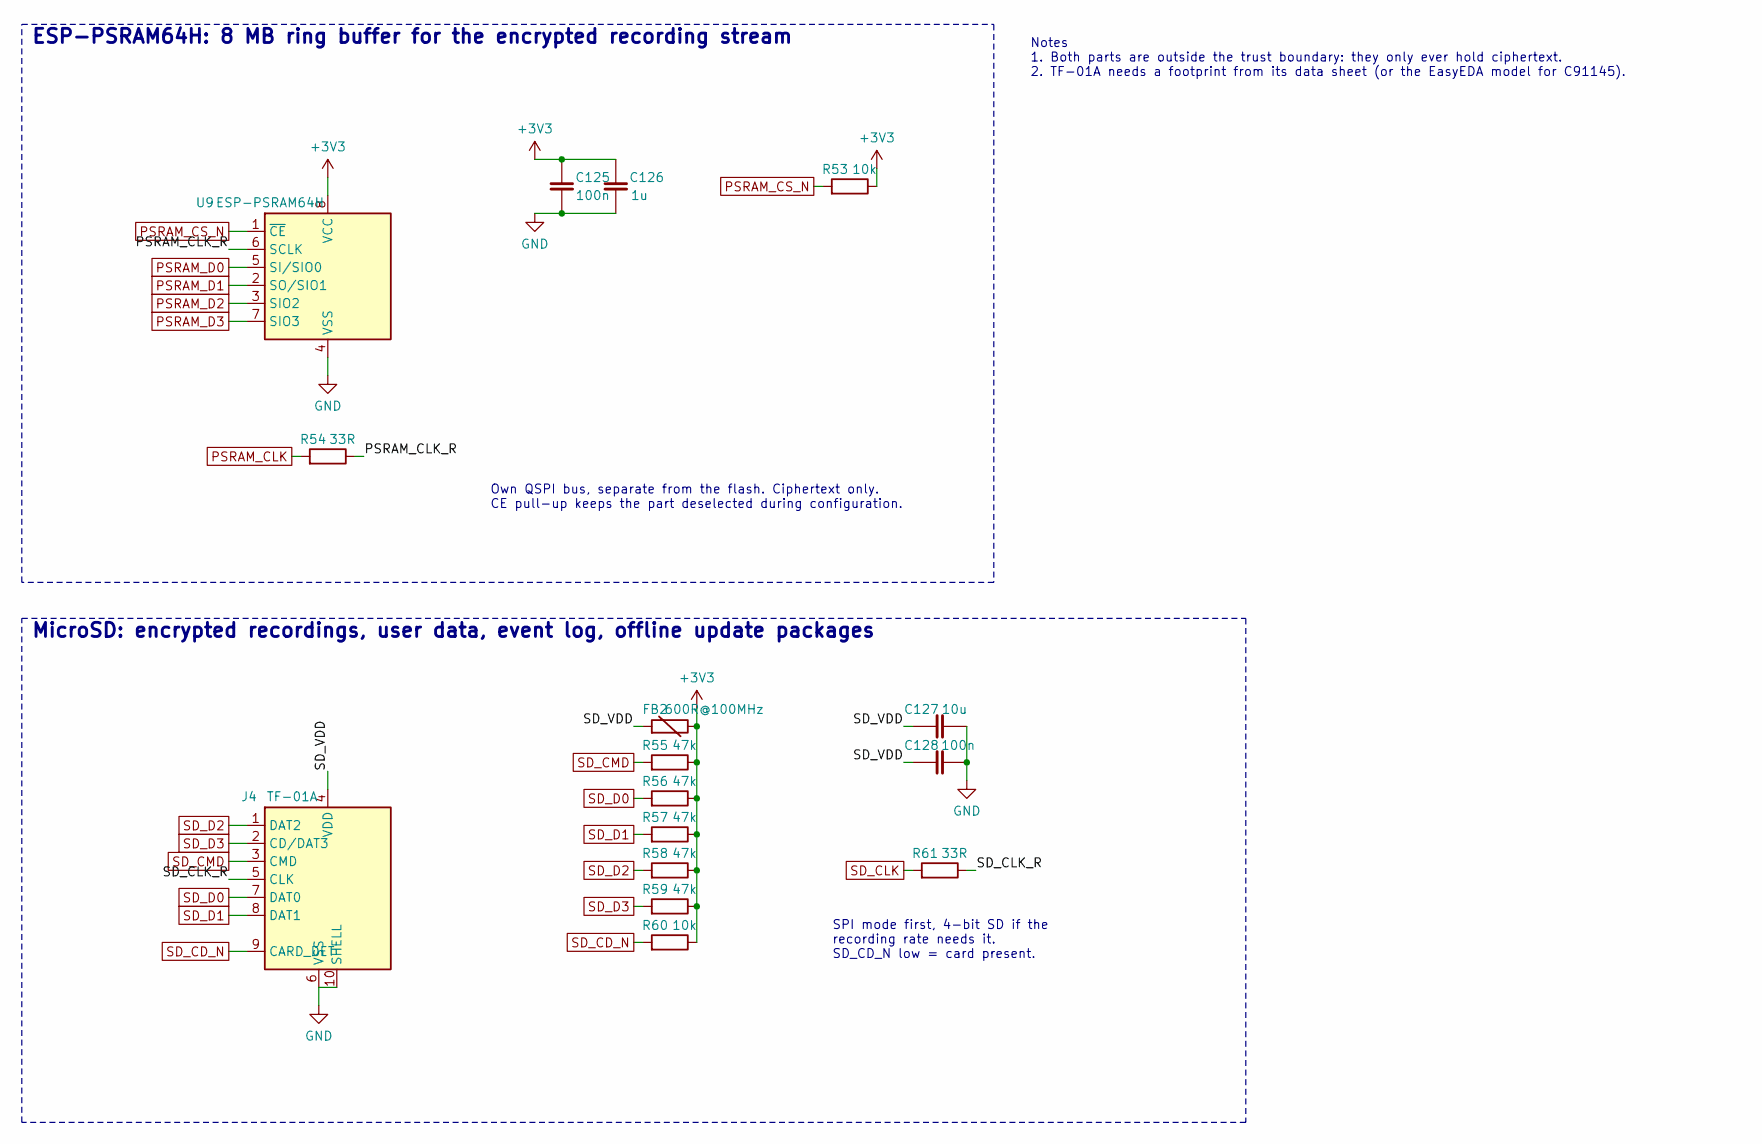
[picture p7: schematic th_storage.kicad_sch]

Parts:
C125, C128: 100n; C_0402_1005Metric; LCSC C1525
C126: 1u; C_0402_1005Metric; LCSC C52923
C127: 10u; C_0603_1608Metric; LCSC C19702
FB2: 600R@100MHz; L_0603_1608Metric; MPN GZ1608D601TF; LCSC C1002
J4: TF-01A; MPN TF-01A; LCSC C91145
R53, R60: 10k; R_0402_1005Metric; LCSC C25744
R54, R61: 33R; R_0402_1005Metric; LCSC C25105
R55, R56, R57, R58, R59: 47k; R_0402_1005Metric; LCSC C25792
U9: ESP-PSRAM64H; SOIC-8_3.9x4.9mm_P1.27mm; MPN ESP-PSRAM64H

Connections:
+3V3: C125.1, C126.1, FB2.2, R53.2, R55.2, R56.2, R57.2, R58.2, R59.2, R60.2, U9.8 (VCC)
GND: C125.2, C126.2, C127.2, C128.2, J4.6 (VSS), J4.10 (SHELL), U9.4 (VSS)
PSRAM_CLK: R54.1
PSRAM_CLK_R: R54.2, U9.6 (SCLK)
PSRAM_CS_N: R53.1, U9.1 (~CE)
PSRAM_D0: U9.5 (SI/SIO0)
PSRAM_D1: U9.2 (SO/SIO1)
PSRAM_D2: U9.3 (SIO2)
PSRAM_D3: U9.7 (SIO3)
SD_CD_N: J4.9 (CARD_DET), R60.1
SD_CLK: R61.1
SD_CLK_R: J4.5 (CLK), R61.2
SD_CMD: J4.3 (CMD), R55.1
SD_D0: J4.7 (DAT0), R56.1
SD_D1: J4.8 (DAT1), R57.1
SD_D2: J4.1 (DAT2), R58.1
SD_D3: J4.2 (CD/DAT3), R59.1
SD_VDD: C127.1, C128.1, FB2.1, J4.4 (VDD)

Notes on the sheet:
ESP-PSRAM64H: 8 MB ring buffer for the encrypted recording stream
Own QSPI bus, separate from the flash. Ciphertext only. CE pull-up keeps the part deselected during configuration.
MicroSD: encrypted recordings, user data, event log, offline update packages
SPI mode first, 4-bit SD if the recording rate needs it. SD_CD_N low = card present.
Notes 1. Both parts are outside the trust boundary: they only ever hold ciphertext. 2. TF-01A needs a footprint from its data sheet (or the EasyEDA model for C91145).
