bradleyeckert/thriller/fpga/logos2/KiCAD/thriller/th_userA.kicad_sch

## KiCad design fpga/logos2/KiCAD/thriller/th_userA.kicad_sch (2026-11-13)

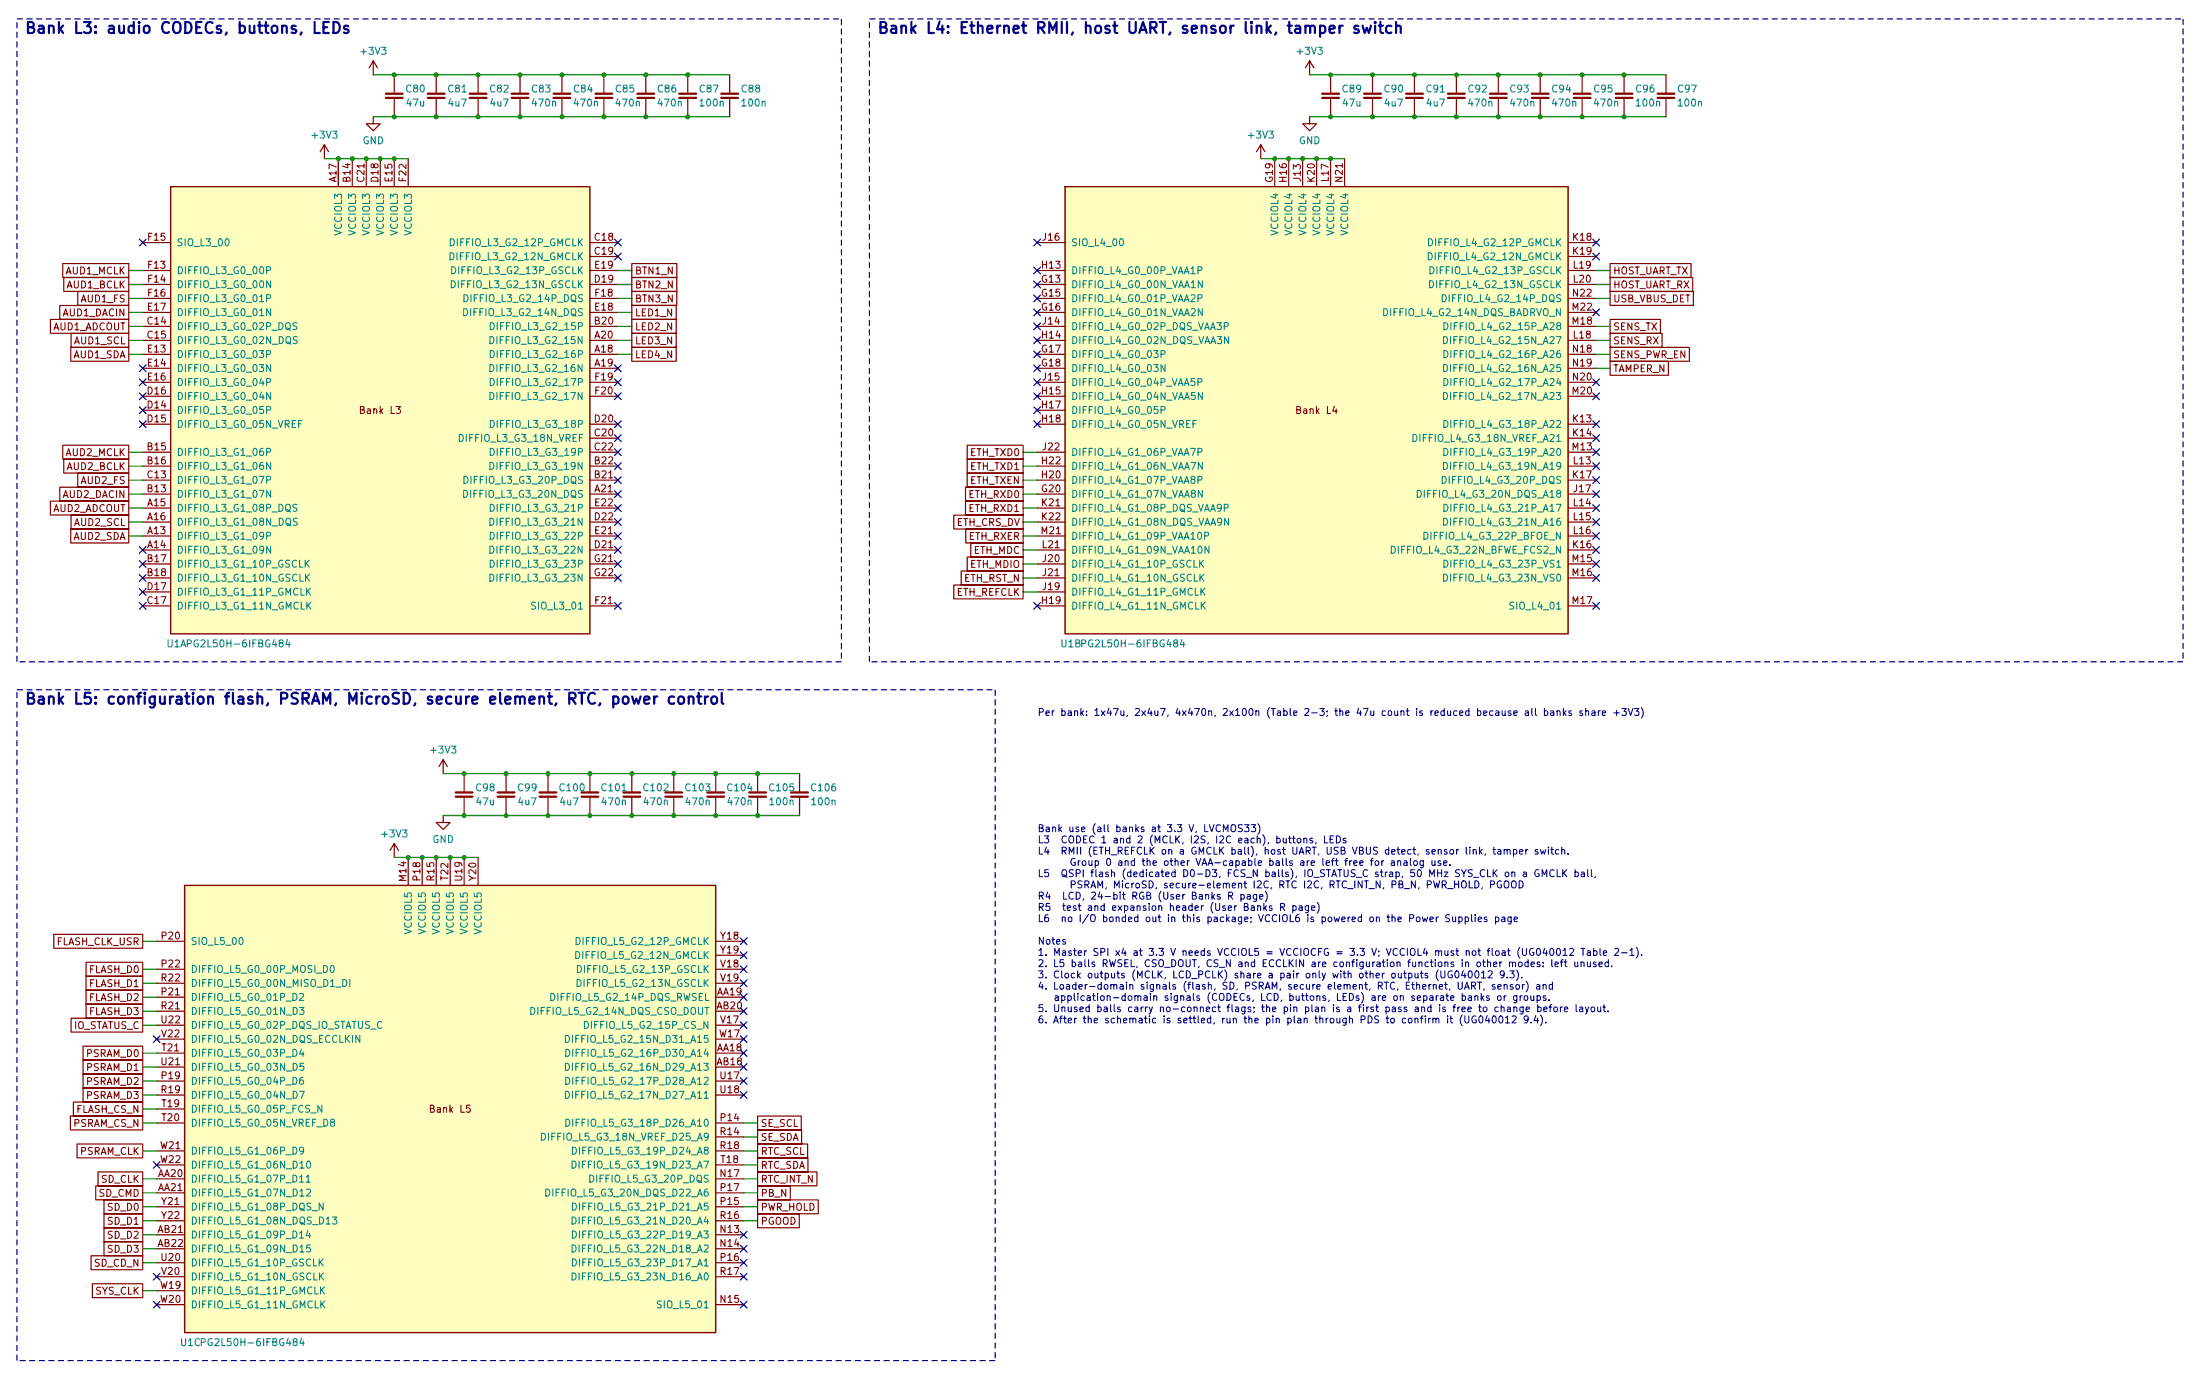
[picture p8: schematic th_userA.kicad_sch]

Parts:
C80, C89, C98: 47u; C_1206_3216Metric; LCSC C96123
C81, C82, C90, C91, C99, C100: 4u7; C_0603_1608Metric; LCSC C19666
C83, C84, C85, C86, C92, C93, C94, C95, C101, C102, C103, C104: 470n; C_0402_1005Metric
C87, C88, C96, C97, C105, C106: 100n; C_0402_1005Metric; LCSC C1525
U1: PG2L50H-6IFBG484; BGA-484_23.0x23.0mm_Layout22x22_P1.0mm

Connections:
+3V3: C80.1, C81.1, C82.1, C83.1, C84.1, C85.1, C86.1, C87.1, C88.1, C89.1, C90.1, C91.1, C92.1, C93.1, C94.1, C95.1, C96.1, C97.1, C98.1, C99.1, C100.1, C101.1, C102.1, C103.1, C104.1, C105.1, C106.1, U1.A17 (VCCIOL3), U1.B14 (VCCIOL3), U1.C21 (VCCIOL3), U1.D18 (VCCIOL3), U1.E15 (VCCIOL3), U1.F22 (VCCIOL3), U1.G19 (VCCIOL4), U1.H16 (VCCIOL4), U1.J13 (VCCIOL4), U1.K20 (VCCIOL4), U1.L17 (VCCIOL4), U1.M14 (VCCIOL5), U1.N21 (VCCIOL4), U1.P18 (VCCIOL5), U1.R15 (VCCIOL5), U1.T22 (VCCIOL5), U1.U19 (VCCIOL5), U1.Y20 (VCCIOL5)
AUD1_ADCOUT: U1.C14 (DIFFIO_L3_G0_02P_DQS)
AUD1_BCLK: U1.F14 (DIFFIO_L3_G0_00N)
AUD1_DACIN: U1.E17 (DIFFIO_L3_G0_01N)
AUD1_FS: U1.F16 (DIFFIO_L3_G0_01P)
AUD1_MCLK: U1.F13 (DIFFIO_L3_G0_00P)
AUD1_SCL: U1.C15 (DIFFIO_L3_G0_02N_DQS)
AUD1_SDA: U1.E13 (DIFFIO_L3_G0_03P)
AUD2_ADCOUT: U1.A15 (DIFFIO_L3_G1_08P_DQS)
AUD2_BCLK: U1.B16 (DIFFIO_L3_G1_06N)
AUD2_DACIN: U1.B13 (DIFFIO_L3_G1_07N)
AUD2_FS: U1.C13 (DIFFIO_L3_G1_07P)
AUD2_MCLK: U1.B15 (DIFFIO_L3_G1_06P)
AUD2_SCL: U1.A16 (DIFFIO_L3_G1_08N_DQS)
AUD2_SDA: U1.A13 (DIFFIO_L3_G1_09P)
BTN1_N: U1.E19 (DIFFIO_L3_G2_13P_GSCLK)
BTN2_N: U1.D19 (DIFFIO_L3_G2_13N_GSCLK)
BTN3_N: U1.F18 (DIFFIO_L3_G2_14P_DQS)
ETH_CRS_DV: U1.K22 (DIFFIO_L4_G1_08N_DQS_VAA9N)
ETH_MDC: U1.L21 (DIFFIO_L4_G1_09N_VAA10N)
ETH_MDIO: U1.J20 (DIFFIO_L4_G1_10P_GSCLK)
ETH_REFCLK: U1.J19 (DIFFIO_L4_G1_11P_GMCLK)
ETH_RST_N: U1.J21 (DIFFIO_L4_G1_10N_GSCLK)
ETH_RXD0: U1.G20 (DIFFIO_L4_G1_07N_VAA8N)
ETH_RXD1: U1.K21 (DIFFIO_L4_G1_08P_DQS_VAA9P)
ETH_RXER: U1.M21 (DIFFIO_L4_G1_09P_VAA10P)
ETH_TXD0: U1.J22 (DIFFIO_L4_G1_06P_VAA7P)
ETH_TXD1: U1.H22 (DIFFIO_L4_G1_06N_VAA7N)
ETH_TXEN: U1.H20 (DIFFIO_L4_G1_07P_VAA8P)
FLASH_CLK_USR: U1.P20 (SIO_L5_00)
FLASH_CS_N: U1.T19 (DIFFIO_L5_G0_05P_FCS_N)
FLASH_D0: U1.P22 (DIFFIO_L5_G0_00P_MOSI_D0)
FLASH_D1: U1.R22 (DIFFIO_L5_G0_00N_MISO_D1_DI)
FLASH_D2: U1.P21 (DIFFIO_L5_G0_01P_D2)
FLASH_D3: U1.R21 (DIFFIO_L5_G0_01N_D3)
GND: C80.2, C81.2, C82.2, C83.2, C84.2, C85.2, C86.2, C87.2, C88.2, C89.2, C90.2, C91.2, C92.2, C93.2, C94.2, C95.2, C96.2, C97.2, C98.2, C99.2, C100.2, C101.2, C102.2, C103.2, C104.2, C105.2, C106.2
HOST_UART_RX: U1.L20 (DIFFIO_L4_G2_13N_GSCLK)
HOST_UART_TX: U1.L19 (DIFFIO_L4_G2_13P_GSCLK)
IO_STATUS_C: U1.U22 (DIFFIO_L5_G0_02P_DQS_IO_STATUS_C)
LED1_N: U1.E18 (DIFFIO_L3_G2_14N_DQS)
LED2_N: U1.B20 (DIFFIO_L3_G2_15P)
LED3_N: U1.A20 (DIFFIO_L3_G2_15N)
LED4_N: U1.A18 (DIFFIO_L3_G2_16P)
PB_N: U1.P17 (DIFFIO_L5_G3_20N_DQS_D22_A6)
PGOOD: U1.R16 (DIFFIO_L5_G3_21N_D20_A4)
PSRAM_CLK: U1.W21 (DIFFIO_L5_G1_06P_D9)
PSRAM_CS_N: U1.T20 (DIFFIO_L5_G0_05N_VREF_D8)
PSRAM_D0: U1.T21 (DIFFIO_L5_G0_03P_D4)
PSRAM_D1: U1.U21 (DIFFIO_L5_G0_03N_D5)
PSRAM_D2: U1.P19 (DIFFIO_L5_G0_04P_D6)
PSRAM_D3: U1.R19 (DIFFIO_L5_G0_04N_D7)
PWR_HOLD: U1.P15 (DIFFIO_L5_G3_21P_D21_A5)
RTC_INT_N: U1.N17 (DIFFIO_L5_G3_20P_DQS)
RTC_SCL: U1.R18 (DIFFIO_L5_G3_19P_D24_A8)
RTC_SDA: U1.T18 (DIFFIO_L5_G3_19N_D23_A7)
SD_CD_N: U1.U20 (DIFFIO_L5_G1_10P_GSCLK)
SD_CLK: U1.AA20 (DIFFIO_L5_G1_07P_D11)
SD_CMD: U1.AA21 (DIFFIO_L5_G1_07N_D12)
SD_D0: U1.Y21 (DIFFIO_L5_G1_08P_DQS_N)
SD_D1: U1.Y22 (DIFFIO_L5_G1_08N_DQS_D13)
SD_D2: U1.AB21 (DIFFIO_L5_G1_09P_D14)
SD_D3: U1.AB22 (DIFFIO_L5_G1_09N_D15)
SENS_PWR_EN: U1.N18 (DIFFIO_L4_G2_16P_A26)
SENS_RX: U1.L18 (DIFFIO_L4_G2_15N_A27)
SENS_TX: U1.M18 (DIFFIO_L4_G2_15P_A28)
SE_SCL: U1.P14 (DIFFIO_L5_G3_18P_D26_A10)
SE_SDA: U1.R14 (DIFFIO_L5_G3_18N_VREF_D25_A9)
SYS_CLK: U1.W19 (DIFFIO_L5_G1_11P_GMCLK)
TAMPER_N: U1.N19 (DIFFIO_L4_G2_16N_A25)
USB_VBUS_DET: U1.N22 (DIFFIO_L4_G2_14P_DQS)

Notes on the sheet:
Bank L3: audio CODECs, buttons, LEDs
Bank L4: Ethernet RMII, host UART, sensor link, tamper switch
Bank L5: configuration flash, PSRAM, MicroSD, secure element, RTC, power control
Per bank: 1x47u, 2x4u7, 4x470n, 2x100n (Table 2-3; the 47u count is reduced because all banks share +3V3)
Bank use (all banks at 3.3 V, LVCMOS33) L3 CODEC 1 and 2 (MCLK, I2S, I2C each), buttons, LEDs L4 RMII (ETH_REFCLK on a GMCLK ball), host UART, USB VBUS detect, sensor link, tamper switch. Group 0 and the other VAA-capable balls are left free for analog use. L5 QSPI flash (dedicated D0-D3, FCS_N bal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
