bradleyeckert/thriller/fpga/logos2/KiCAD/thriller/th_userB.kicad_sch

## KiCad design fpga/logos2/KiCAD/thriller/th_userB.kicad_sch (2026-11-13)

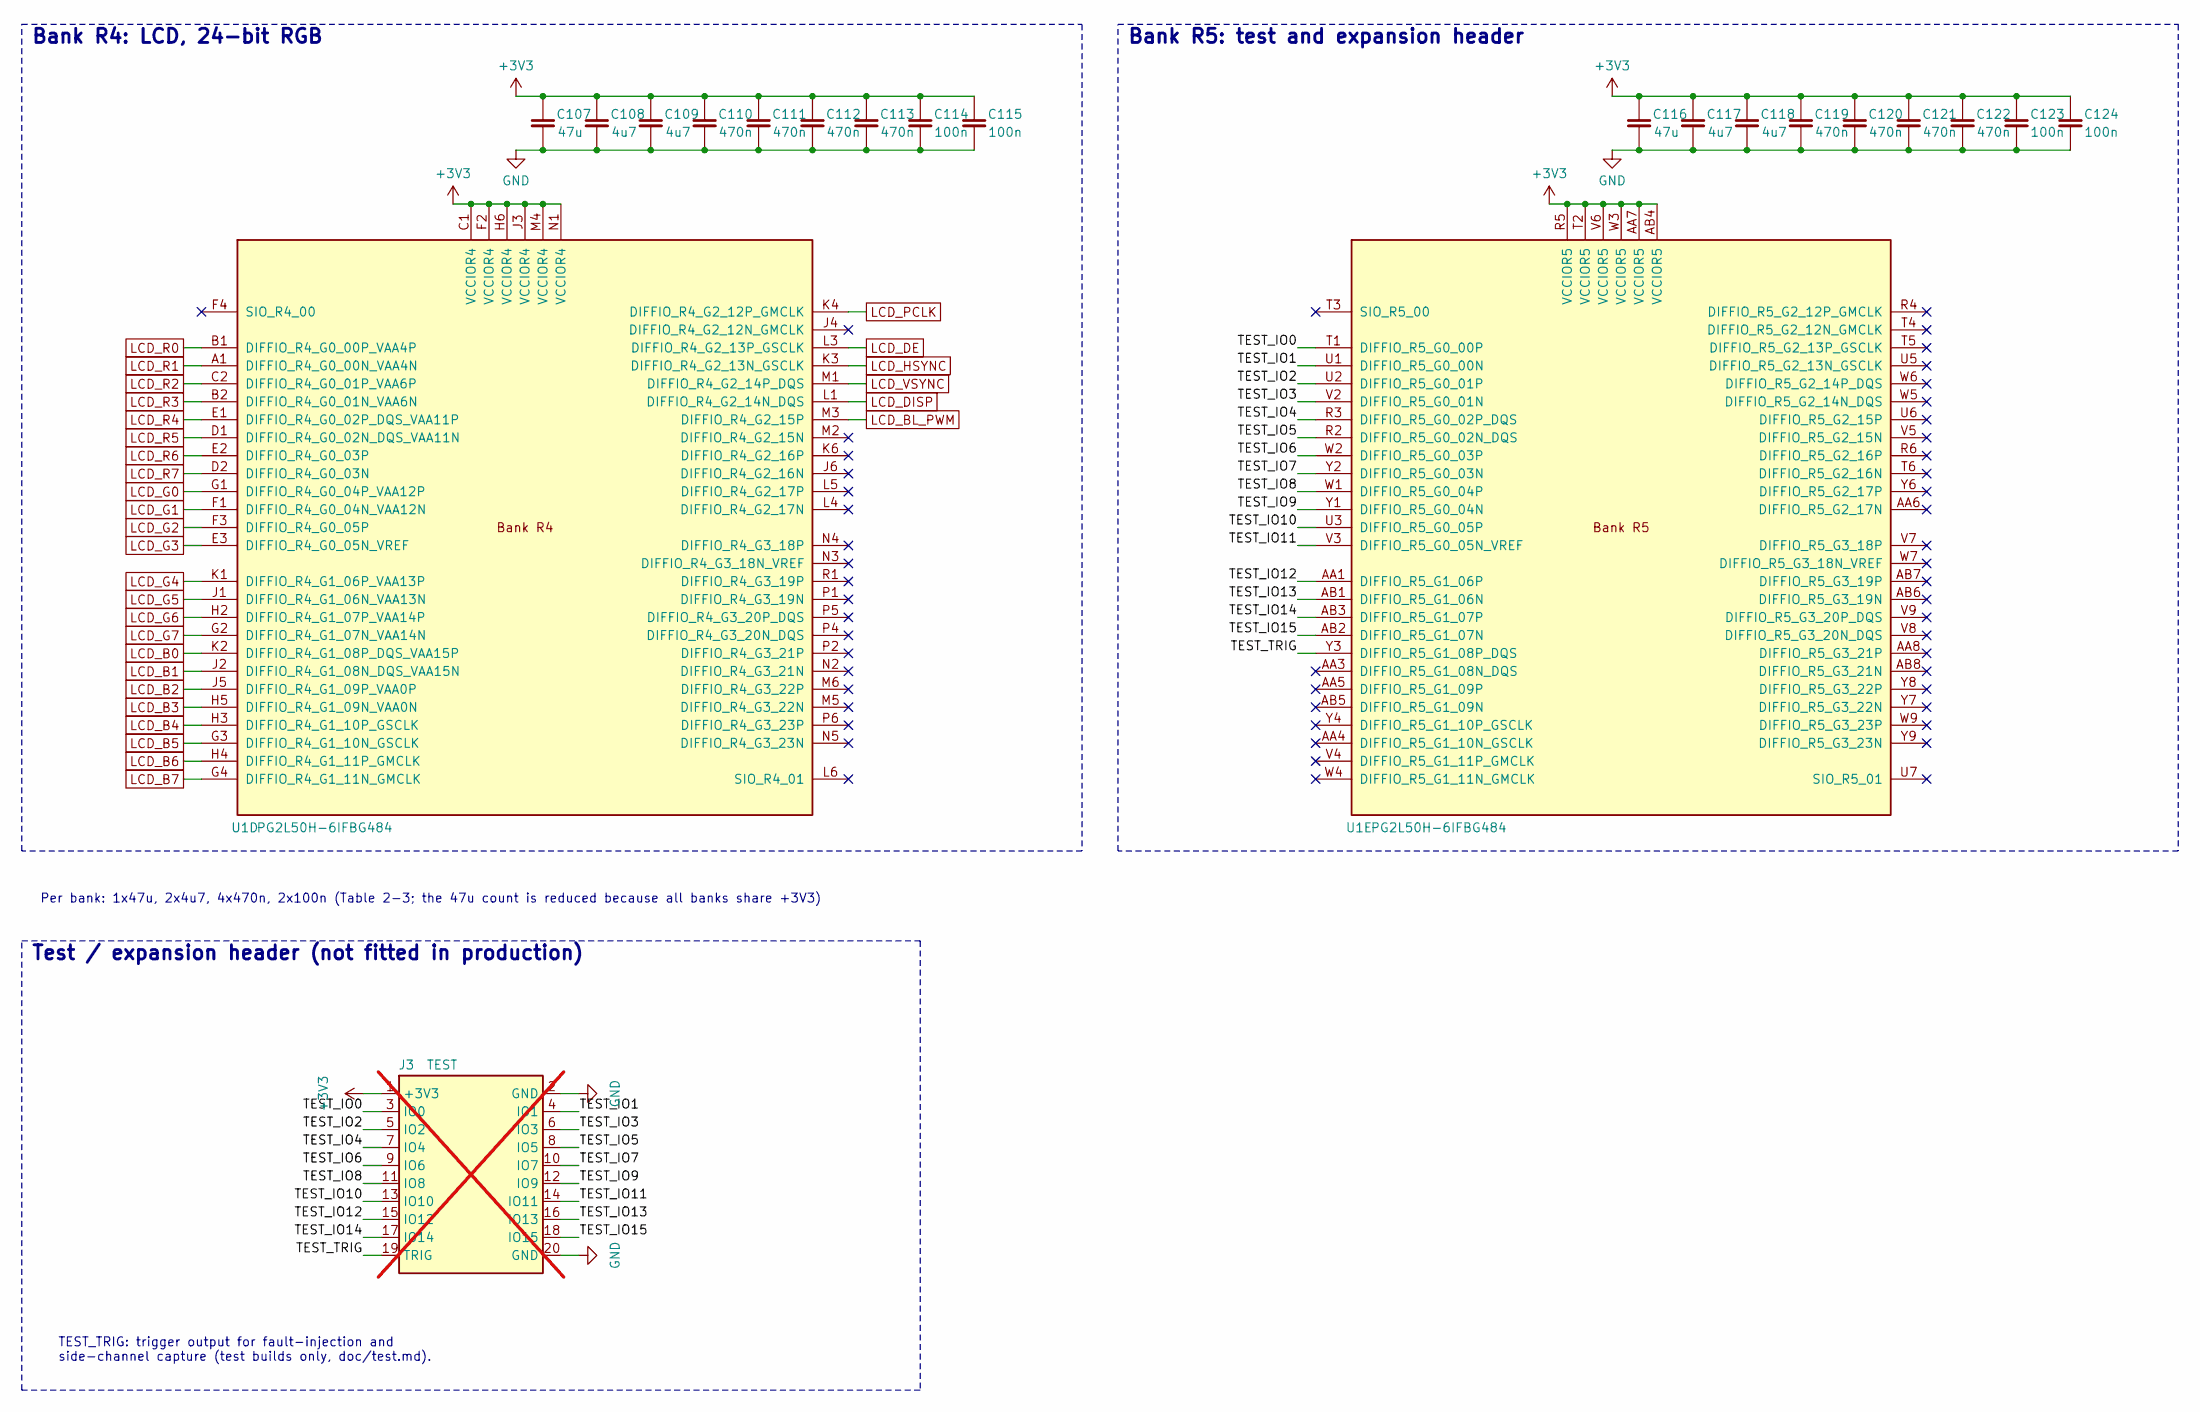
[picture p9: schematic th_userB.kicad_sch]

Parts:
C107, C116: 47u; C_1206_3216Metric; LCSC C96123
C108, C109, C117, C118: 4u7; C_0603_1608Metric; LCSC C19666
C110, C111, C112, C113, C119, C120, C121, C122: 470n; C_0402_1005Metric
C114, C115, C123, C124: 100n; C_0402_1005Metric; LCSC C1525
J3: TEST; PinHeader_2x10_P2.54mm_Vertical; not fitted
U1: PG2L50H-6IFBG484; BGA-484_23.0x23.0mm_Layout22x22_P1.0mm

Connections:
+3V3: C107.1, C108.1, C109.1, C110.1, C111.1, C112.1, C113.1, C114.1, C115.1, C116.1, C117.1, C118.1, C119.1, C120.1, C121.1, C122.1, C123.1, C124.1, J3.1 (+3V3), U1.AA7 (VCCIOR5), U1.AB4 (VCCIOR5), U1.C1 (VCCIOR4), U1.F2 (VCCIOR4), U1.H6 (VCCIOR4), U1.J3 (VCCIOR4), U1.M4 (VCCIOR4), U1.N1 (VCCIOR4), U1.R5 (VCCIOR5), U1.T2 (VCCIOR5), U1.V6 (VCCIOR5), U1.W3 (VCCIOR5)
GND: C107.2, C108.2, C109.2, C110.2, C111.2, C112.2, C113.2, C114.2, C115.2, C116.2, C117.2, C118.2, C119.2, C120.2, C121.2, C122.2, C123.2, C124.2, J3.2 (GND), J3.20 (GND)
LCD_B0: U1.K2 (DIFFIO_R4_G1_08P_DQS_VAA15P)
LCD_B1: U1.J2 (DIFFIO_R4_G1_08N_DQS_VAA15N)
LCD_B2: U1.J5 (DIFFIO_R4_G1_09P_VAA0P)
LCD_B3: U1.H5 (DIFFIO_R4_G1_09N_VAA0N)
LCD_B4: U1.H3 (DIFFIO_R4_G1_10P_GSCLK)
LCD_B5: U1.G3 (DIFFIO_R4_G1_10N_GSCLK)
LCD_B6: U1.H4 (DIFFIO_R4_G1_11P_GMCLK)
LCD_B7: U1.G4 (DIFFIO_R4_G1_11N_GMCLK)
LCD_BL_PWM: U1.M3 (DIFFIO_R4_G2_15P)
LCD_DE: U1.L3 (DIFFIO_R4_G2_13P_GSCLK)
LCD_DISP: U1.L1 (DIFFIO_R4_G2_14N_DQS)
LCD_G0: U1.G1 (DIFFIO_R4_G0_04P_VAA12P)
LCD_G1: U1.F1 (DIFFIO_R4_G0_04N_VAA12N)
LCD_G2: U1.F3 (DIFFIO_R4_G0_05P)
LCD_G3: U1.E3 (DIFFIO_R4_G0_05N_VREF)
LCD_G4: U1.K1 (DIFFIO_R4_G1_06P_VAA13P)
LCD_G5: U1.J1 (DIFFIO_R4_G1_06N_VAA13N)
LCD_G6: U1.H2 (DIFFIO_R4_G1_07P_VAA14P)
LCD_G7: U1.G2 (DIFFIO_R4_G1_07N_VAA14N)
LCD_HSYNC: U1.K3 (DIFFIO_R4_G2_13N_GSCLK)
LCD_PCLK: U1.K4 (DIFFIO_R4_G2_12P_GMCLK)
LCD_R0: U1.B1 (DIFFIO_R4_G0_00P_VAA4P)
LCD_R1: U1.A1 (DIFFIO_R4_G0_00N_VAA4N)
LCD_R2: U1.C2 (DIFFIO_R4_G0_01P_VAA6P)
LCD_R3: U1.B2 (DIFFIO_R4_G0_01N_VAA6N)
LCD_R4: U1.E1 (DIFFIO_R4_G0_02P_DQS_VAA11P)
LCD_R5: U1.D1 (DIFFIO_R4_G0_02N_DQS_VAA11N)
LCD_R6: U1.E2 (DIFFIO_R4_G0_03P)
LCD_R7: U1.D2 (DIFFIO_R4_G0_03N)
LCD_VSYNC: U1.M1 (DIFFIO_R4_G2_14P_DQS)
TEST_IO0: J3.3 (IO0), U1.T1 (DIFFIO_R5_G0_00P)
TEST_IO1: J3.4 (IO1), U1.U1 (DIFFIO_R5_G0_00N)
TEST_IO2: J3.5 (IO2), U1.U2 (DIFFIO_R5_G0_01P)
TEST_IO3: J3.6 (IO3), U1.V2 (DIFFIO_R5_G0_01N)
TEST_IO4: J3.7 (IO4), U1.R3 (DIFFIO_R5_G0_02P_DQS)
TEST_IO5: J3.8 (IO5), U1.R2 (DIFFIO_R5_G0_02N_DQS)
TEST_IO6: J3.9 (IO6), U1.W2 (DIFFIO_R5_G0_03P)
TEST_IO7: J3.10 (IO7), U1.Y2 (DIFFIO_R5_G0_03N)
TEST_IO8: J3.11 (IO8), U1.W1 (DIFFIO_R5_G0_04P)
TEST_IO9: J3.12 (IO9), U1.Y1 (DIFFIO_R5_G0_04N)
TEST_IO10: J3.13 (IO10), U1.U3 (DIFFIO_R5_G0_05P)
TEST_IO11: J3.14 (IO11), U1.V3 (DIFFIO_R5_G0_05N_VREF)
TEST_IO12: J3.15 (IO12), U1.AA1 (DIFFIO_R5_G1_06P)
TEST_IO13: J3.16 (IO13), U1.AB1 (DIFFIO_R5_G1_06N)
TEST_IO14: J3.17 (IO14), U1.AB3 (DIFFIO_R5_G1_07P)
TEST_IO15: J3.18 (IO15), U1.AB2 (DIFFIO_R5_G1_07N)
TEST_TRIG: J3.19 (TRIG), U1.Y3 (DIFFIO_R5_G1_08P_DQS)

Notes on the sheet:
Bank R4: LCD, 24-bit RGB
Bank R5: test and expansion header
Per bank: 1x47u, 2x4u7, 4x470n, 2x100n (Table 2-3; the 47u count is reduced because all banks share +3V3)
Test / expansion header (not fitted in production)
TEST_TRIG: trigger output for fault-injection and side-channel capture (test builds only, doc/test.md).
