bradleyeckert/thriller/(commit log)

2026-10-26 Rework Stage 0/1 around LIFCL-17 + ATECC608B; add open items
    Claude-Session: https://claude.ai/code/session_0161FeKLJ3Qivq438GMspAFJ
2026-10-26 Add doc/arch.md: algorithm bill of materials
    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
2026-10-26 Split platform and application update chains; note ASIC conversion
    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
2026-10-26 Switch update signatures to LMS (RFC 8554); require encrypted-only bitstreams
    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
2026-10-26 Per-board bitstream keys and pairing keys; contain R14 to one board
    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
2026-10-26 Add MicroSD card socket: chipset, FPGA interface table, risks R23-R24
    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
2026-10-27 Add doc/test.md: test framework and fault-injection plan on LiteForth
    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
2026-10-27 ICS55: why a ROM-held unwrapping key is not a per-device secret
    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
2026-10-28 Add doc/roles.md: per-device developer keys for sideloading; per-install XIP salt fixes nonce reuse
    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
2026-11-01 User data on MicroSD; version rule 'not older'; add doc/se.md slot map; R28 user data freshness
    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
2026-11-01 Shared two-port XIP engine for both cores; FPGA mirrors the ASIC boot chain (boot ROM, loader in flash)
    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
2026-11-01 README, arch, fda: platform = bitstream + updatable loader under counter 0; boot ROM stage; per-board loader packages; document index
    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
2026-11-01 Deep-review fixes: restamped loader in every platform package, developer epoch and slot cleanup, slot 10 closed, versioned pairing keys, lockdown in boot ROM, session protection gap (R29), flash map,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
2026-11-01 Second-review fixes: re-hash on install, release manifests, key versions, MAC/derive modes, install port, key check values, hashed public keys, bad-slot fallback, masked AES, backup keys, R30-R31; re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
2026-11-02 Move the root of trust to an ESP32-C5HR8
    The C5 runs the application and holds every key in ESP-TEE; the ATECC608B is gone;
    the ECP5 becomes an untrusted peripheral with a plain open-toolchain bitstream.
    New: c5.md (eFuse map, boot chain, TEE, partitions, anti-rollback), sensor.md
    (replaceable sensor, ML-DSA certificates, offline ML-KEM pairing, per-frame MACs),
    enrollment.md, fpga.md. Rewritten: README, arch (risks R1-R27), roles, test, fda,
    ics55 commentary, questions. Retired hw, xip, se, flash (kept on archive/fpga-rot-v0).
    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
2026-11-02 Add OTA updates over Wi-Fi, CLI over a BLE serial service, UART status and fallback
    Radio policy is set by the application owner in the signed build descriptor.
    New risks R28-R30, R23 rewritten; FDA views, test rows and questions updated;
    D1 and E1 closed.
    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
2026-11-02 Name the UART, BLE and Wi-Fi where docs said host link
    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
2026-11-05 Run the application on the ECP5 with per-device keys in its encrypted bitstream
    The C5 stays root of trust, installer and gateway; the ECP5 runs LiteForth from
    its own QSPI flash through a per-line AES-GCM XIP cache, holds link and image keys
    with no CPU read path, and encrypts recordings to the host with segment keys from
    the TEE. New: xip.md, acquisition.md (CODECs, recording encryption, watermark).
    Rewritten: fpga.md, README, fda.md, roles.md (developer builds as FPGA apps with a
    per-device key), ics55 commentary, questions.md. Updated: arch.md (R17, R21,
    R23, R31-R42), c5.md, enrollment.md (ECP5 keys, bitstream build service),
    sensor.md, test.md.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
2026-11-05 Production bitstreams from Lattice Diamond; ECP5 security settings; LFE5U-25F; remove watermark
    bitgen needs a Diamond .ncd, so the bitstream build service uses Diamond and the
    open flow stays for development. ECP5 security is bitstream settings plus on-chip
    key storage, with boundary scan still available (new R43); foreign bitstreams are
    caught by the link handshake. The slave SPI pins carry the link. Part is
    LFE5U-25F-6BG256C. Watermark documentation removed; R40 now accepted. Safety
    alarms need no independent path.
    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
2026-11-05 ECP5 decrypt-only eFuse and per-device keys via Diamond ECO Tcl
    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
2026-11-05 Switch symmetric crypto to Ascon; move FPGA family specifics into fpga/<family>/
    Ascon-AEAD128 and Ascon-CXOF128 (SP 800-232) for XIP lines, the C5-FPGA link,
    recordings, host and CLI sessions, user data, packages, the sensor and key
    derivation; exceptions fixed by hardware are listed in arch.md. FPGA area
    estimate drops to about 7K-12K LUTs.
    New fpga/README.md (requirements a family must meet) with folders for ECP5
    (current), CrossLink-NX, Titanium and Pango PGL25G, including an analysis of the
    PGL25G's UID-locking scheme. doc/fpga.md and the bitstream build service are now
    family-neutral.
    Claude-Session: https://claude.ai/code/sessi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
2026-11-06 Make the Pango Logos2 PG2L50H the current FPGA and return to AES-256 in its hard AES block
    Pango's DPA protection covers configuration and the fabric's hard AES block, so
    symmetric crypto goes back to AES-256-GCM and an AES-256-CMAC KDF, run in that
    block on the FPGA and in the C5's hardened AES accelerator; AES-CCM if the block
    lacks GHASH. Encrypted-only and signed-only configuration assumed, slave serial
    configuration, JTAG permanently disabled when locked, PDS headless. R17, R32, R33
    and R43 updated (R32 and R43 closed on the Logos2). ECP5 becomes the fallback.
    FPGA questions renumbered around the remaining Pango unknowns.
    Claude-S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
2026-11-08 Root of trust in the FPGA with an ATECC608B; drop the ESP32-C5
    Chipset becomes an FPGA with an authenticated bitstream, one QSPI flash
    and an ATECC608B, with no external microcontroller. The FPGA models the
    ASIC: two LiteForth cores (loader domain owns every key path, application
    domain reaches it only through the mailbox), a boot ROM in the bitstream,
    both images in flash under per-line AES-256-GCM, and a fixed key-source
    interface that is block RAM on the FPGA and a PUF on the ASIC.
    - doc/se.md: slot map, protocol, pairing-key ratchet (each bitstream
    release carries its inherited and own pairing key; the secure element
    holds only the current one, so superseded bitstreams are dead rath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
2026-11-08 Secure element: ATECC608C instead of ATECC608B
    Same command set and slot map; chosen for its RNG certified to NIST
    SP 800-90A/B/C with CMVP entropy source validation, and its updated
    side-channel and invasive-analysis countermeasures. The historical
    reference to the 608B design in commit cecf901 is kept.
    Claude-Session: https://claude.ai/code/session_01XW7t1URBA1NnvnLBYNQmPV
2026-11-08 Ethernet as a UDP-only hardware transport; no radios
    Replace the optional Wi-Fi/BLE modem with one wired Ethernet port over
    an RMII PHY. The FPGA's network side is RTL in the loader domain: MAC,
    ARP responder, IPv4 without fragments or options, ICMP echo, and a UDP
    demux on one port whose payload is the same authenticated session frame
    the UART carries. No network stack on any core. An untrusted edge proxy
    on site relays datagrams over TLS 443 where IT policy requires it.
    Risk rows R23, R28, R29 and R39 rewritten for a LAN attacker against a
    hardware parser; FDA elements and interfaces updated; wireless gap
    replaced by a network/isolation note; questions A6-A9 reassigned (PHY
    and PoE, addre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
2026-11-08 Add network security posture statement
    One page for IT approvers and the FDA: no network stack, hardware
    transport, outbound only, air-gap option; residual risk is denial of
    service. Linked from the README and the FDA use-case views.
    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
2026-11-08 Server time beacons: recording time bracketed by server-attested instants
    The device has no trusted clock. Segment headers carry the latest
    server beacon (MAC'd under the identity key, verified by the secure
    element) and the sample count since it; the first segment after a
    reconnection carries the next beacon. New risk row R47 and test row.
    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
2026-11-08 Stream buffer: 8 MB QSPI PSRAM for the encrypted recording stream
    ESP-PSRAM64H as a ring of authenticated ciphertext blocks between the
    recording engine and the card or network, draining under the loader's
    direction. Holds no plaintext or key, so it sits outside the trust
    boundary like the card. New risk row R48 and test row; capacity,
    overflow and power-loss behavior stated.
    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
2026-11-12 fpga/gw5a: Gowin Arora V evaluated; fallback at best
    AES-128 bitstream encryption without authentication, no hardened crypto
    block, JTAG lock not documented: the ECP5's security tier on 22 nm.
    Recorded so the evaluation is not repeated.
    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
2026-11-12 F1 answered from the PDS Tcl guide: no scripted DRM edits or bitstream options
    Wrapped pairing keys under the eFuse key via the hard AES block (F5)
    become the primary plan for the Logos2; per-device bitstreams (F1) the
    fallback, with three questions for Pango support. New section in
    doc/fpga.md; logos2 README, enrollment and the wish list updated.
    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
2026-11-12 Logos2: headless station flow from the Fabric Configuration guide
    cdt_cfg Tcl script for eFuse keying, lock bits and flash programming;
    eFuse lock-bit table (JTAGLOCK closes R43); multi-boot stream format
    (F3 half-answered); F1 reframed around cheap per-device re-encryption;
    F2 caveat recorded: the eFuse key alone does not refuse plaintext
    bitstreams, so the enable bits must be identified before fusing.
    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
2026-11-12 Logos2 F2: ambiguity, not a hole; close with a bench test
    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
2026-11-12 Drop ECP5 and GW5A; Ti60 is the fallback; add RTC and FIPS note
    Both Lattice ECP5 and Gowin GW5A lack bitstream authentication; with
    the Logos2 and the Ti60 known good they are marked dropped and kept for
    the record. The Ti60 becomes the fallback in every document.
    Real-time clock added to the chipset: untrusted, never a substitute
    for the server's time beacons; its alarm output forces a full
    reconfiguration so every scheduled wake re-runs the trust chain
    (R49, A10). FIPS: the design is kept validatable; A11 asks whether
    CAVP covers Ascon.
    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
2026-11-12 RTC wakes from deep sleep (regulator enables / RST_N); SP 800-90B restart testing
    The alarm is a power control rather than a reconfiguration trigger: a
    wake is a cold start through the whole chain. A test build uses it to
    automate SP 800-90B restart testing, logging raw TRNG samples at a
    thousand cold starts so the conditioner can be sized from measured
    entropy.
    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
2026-11-12 RTC alarm is also an input pin: boot cause and wake-while-awake interrupt
    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
2026-11-12 RTC: /INT survives VDD cycle; backup is two SR44 cells, charging disabled
    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
2026-11-12 hw: KiCad project with the top sheet (block diagram, notes, sheets)
    thrilr_top.kicad_sch on A3: no components, a block diagram of the
    chipset and power architecture, design notes taken from the Logos2
    hardware design guide (rails, Master SPI bank voltages, SCBV, MODE,
    decoupling per Table 2-3, VCCB, unused HSST handling, clock pins), the
    sheet list with a first-guess split into ten sub-sheets, and the sheet
    symbols. Placeholder sub-sheets and a project file included.
    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
    [audio.kicad_sch, display_ui.kicad_sch, ethernet.kicad_sch, fpga_config.kicad_sch, fpga_io.kicad_sch, fpga_power.kicad_sch, memory.kicad_sch, power.kicad_sch]
2026-11-12 hw: top sheet shows the FIPS 140-3 module boundary as a dashed box
    Secure element and QSPI flash move inside the boundary beside the FPGA;
    RTC, PSRAM and MicroSD stay outside. Signals leaving the boundary are
    labeled at the FPGA edge.
    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
    [audio.kicad_sch, display_ui.kicad_sch, ethernet.kicad_sch, fpga_config.kicad_sch, fpga_io.kicad_sch, fpga_power.kicad_sch, memory.kicad_sch, power.kicad_sch]
2026-11-13 first cut claude
    [th_audio.kicad_sch, th_base.kicad_sch, th_display.kicad_sch, th_ext.kicad_sch, th_power.kicad_sch, th_storage.kicad_sch, th_userA.kicad_sch, th_userB.kicad_sch]
2026-11-13 Replace the ATECC608C with an ST33KTPM2X TPM; FIPS boundary B
    doc/se.md becomes doc/tpm.md: NV indices (pairing index whose authorization
    value is the pairing key, eight host indices, two NV counters, freshness,
    lifecycle bits, write-locked LMS public keys), sealed objects whose policies
    name the pairing index (so the ratchet is one TPM2_NV_ChangeAuth and touches
    no blob), PCR measurements, bound sessions with AES-128-CFB parameter
    encryption and HMAC-SHA256, host authentication as a relayed HMAC session,
    attestation by TPM2_Quote under an AK bound to ST's EK certificate, the
    platform-hierarchy and TPM2_Clear handling (TPM reset held by the FPGA, boot
    ROM disables the platform hierarchy), pr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
    [power.kicad_sch, secure.kicad_sch, thrilr_top.kicad_sch]
2026-11-13 Design for few CMVP filings: frozen crypto-kernel module, supervisor core outside it
    The loader domain is the FIPS module, so every change to the bitstream or the
    loader image is a filing. The design now keeps the module a crypto kernel with
    a fixed, versioned service API and moves everything that changes from release
    to release out of it: a third LiteForth core, the supervisor, runs the
    manufacturer's transports (Ethernet, UART framing, sensor link, card, stream
    buffer), DHCP, the CLI command set, scheduling, sleep and wake and the RTC,
    outside the module, in its own LMS-signed image with its own TPM counter (2)
    and XIP port. Releases of it and of the application are not filings.
    fips.md g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
    [thrilr_top.kicad_sch]
2026-11-13 doc/api.md: the module's service API (H9); F12 findings on PDS region locking
    The API has two layers: the mailbox API between the supervisor and
    application cores and the module (status block, sessions as relayed
    handshake steps plus FRAME_IN/FRAME_OUT, user data records with the
    freshness check, recording segments, sensor polling and pairing, two-pass
    installs, attestation, log entries, public records, events), and the
    session API, the plaintext message kinds the module consumes itself (key
    material, recipient keys, settings, beacons, pairing verdicts, denylists,
    lifecycle) versus the kinds it passes through to the supervisor. Fixed
    header, status codes, versioning rule, size limits, and th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
2026-11-14 Act on the external review: undeletable TPM indices, boundary B redrawn, cert #5570, API limits, bitstream repair
    Review findings (claude.ai/artifact/QP1vQQm2KLZ6bQxjiANu7f), in order:
    1. Key extraction, not just denial of service: with the empty platform
    authorization after a TPM reset, an attacker could delete the pairing
    index and recreate it with the same public area (same Name) and a chosen
    authorization value, satisfying every PolicySecret(pairing). Every index
    now carries TPMA_NV_POLICY_DELETE with a PolicyOR whose only deletion
    branch is PolicySecret(owner), HSM-held. R36 rewritten; E5 adds the
    attack as a simulator test against an index without the attribute.
    2. I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
    [thrilr_top.kicad_sch]
